Team-Micras/MicrasPCB/research/next-revision/calculations/power_tree/out/summary.txt

== A_none
  VDDA mean 3.2999 V; p-p    2063.0 uV (  40.97 LSB); rms     417.1 uV (   8.28 LSB)
  >200 kHz (switching) p-p    1407.9 uV (  27.96 LSB);  <200 kHz p-p     722.9 uV (  14.36 LSB)
  wall scan: window-mean spread      10.6 uV (   0.21 LSB); lit-dark     -10.3 uV (  -0.20 LSB); in-window rms     399.2 uV (   7.93 LSB)
  motor-current sample instants: p-p     794.5 uV (  15.78 LSB)
  lines (peak amplitude): a100k 7.00 uV, a300k 2.03 uV, a400k 0.53 uV, a1M1 536.63 uV
  v3d_pp 61.19 mV  vbat_pp 198.23 mV  va0_pp 2.23 mV  va0_mean 3.300 V
== A_bead
  VDDA mean 3.2991 V; p-p     943.7 uV (  18.74 LSB); rms     225.7 uV (   4.48 LSB)
  >200 kHz (switching) p-p     119.5 uV (   2.37 LSB);  <200 kHz p-p     938.1 uV (  18.63 LSB)
  wall scan: window-mean spread     200.1 uV (   3.97 LSB); lit-dark    -199.9 uV (  -3.97 LSB); in-window rms      40.1 uV (   0.80 LSB)
  motor-current sample instants: p-p     905.2 uV (  17.98 LSB)
  lines (peak amplitude): a100k 2.24 uV, a300k 0.79 uV, a400k 0.66 uV, a1M1 2.24 uV
  v3d_pp 61.19 mV  vbat_pp 198.23 mV  va0_pp 2.40 mV  va0_mean 3.300 V
== A_lc
  VDDA mean 3.2982 V; p-p    2452.6 uV (  48.71 LSB); rms     538.5 uV (  10.69 LSB)
  >200 kHz (switching) p-p      85.0 uV (   1.69 LSB);  <200 kHz p-p    2452.0 uV (  48.70 LSB)
  wall scan: window-mean spread     410.3 uV (   8.15 LSB); lit-dark    -409.9 uV (  -8.14 LSB); in-window rms     142.0 uV (   2.82 LSB)
  motor-current sample instants: p-p    2428.8 uV (  48.23 LSB)
  lines (peak amplitude): a100k 2.14 uV, a300k 0.53 uV, a400k 0.47 uV, a1M1 0.14 uV
  v3d_pp 61.19 mV  vbat_pp 198.24 mV  va0_pp 2.41 mV  va0_mean 3.300 V
== A_lcd
  VDDA mean 3.2865 V; p-p    4175.1 uV (  82.91 LSB); rms    1475.8 uV (  29.31 LSB)
  >200 kHz (switching) p-p      84.9 uV (   1.69 LSB);  <200 kHz p-p    4189.5 uV (  83.20 LSB)
  wall scan: window-mean spread    3026.3 uV (  60.10 LSB); lit-dark   -3024.9 uV ( -60.07 LSB); in-window rms     286.1 uV (   5.68 LSB)
  motor-current sample instants: p-p    4174.8 uV (  82.91 LSB)
  lines (peak amplitude): a100k 2.21 uV, a300k 0.53 uV, a400k 0.47 uV, a1M1 0.08 uV
  v3d_pp 61.19 mV  vbat_pp 198.23 mV  va0_pp 1.97 mV  va0_mean 3.300 V
== A_lcx
  VDDA mean 3.2995 V; p-p    1042.9 uV (  20.71 LSB); rms     248.7 uV (   4.94 LSB)
  >200 kHz (switching) p-p      83.1 uV (   1.65 LSB);  <200 kHz p-p    1042.1 uV (  20.70 LSB)
  wall scan: window-mean spread      89.4 uV (   1.78 LSB); lit-dark     -87.8 uV (  -1.74 LSB); in-window rms      40.5 uV (   0.80 LSB)
  motor-current sample instants: p-p    1039.2 uV (  20.64 LSB)
  lines (peak amplitude): a100k 1.92 uV, a300k 0.53 uV, a400k 0.47 uV, a1M1 0.34 uV
  v3d_pp 61.19 mV  vbat_pp 198.23 mV  va0_pp 2.25 mV  va0_mean 3.300 V
== A_lcx_hv
  VDDA mean 3.2995 V; p-p    1043.4 uV (  20.72 LSB); rms     248.7 uV (   4.94 LSB)
  >200 kHz (switching) p-p      83.5 uV (   1.66 LSB);  <200 kHz p-p    1042.4 uV (  20.70 LSB)
  wall scan: window-mean spread      89.4 uV (   1.78 LSB); lit-dark     -87.8 uV (  -1.74 LSB); in-window rms      40.5 uV (   0.80 LSB)
  motor-current sample instants: p-p    1039.2 uV (  20.64 LSB)
  lines (peak amplitude): a100k 1.52 uV, a300k 0.53 uV, a400k 0.47 uV, a1M1 0.34 uV
  v3d_pp 61.19 mV  vbat_pp 384.53 mV  va0_pp 2.26 mV  va0_mean 3.300 V
== A_pfm-lcx
  VDDA mean 3.3618 V; p-p    3474.8 uV (  69.01 LSB); rms     468.8 uV (   9.31 LSB)
  >200 kHz (switching) p-p     112.4 uV (   2.23 LSB);  <200 kHz p-p    3472.5 uV (  68.96 LSB)
  wall scan: window-mean spread     690.5 uV (  13.71 LSB); lit-dark    -125.3 uV (  -2.49 LSB); in-window rms     298.4 uV (   5.93 LSB)
  motor-current sample instants: p-p    3396.3 uV (  67.45 LSB)
  lines (peak amplitude): a100k 12.56 uV, a300k 0.47 uV, a400k 0.45 uV, a1M1 0.08 uV
  v3d_pp 61.19 mV  vbat_pp 198.20 mV  va0_pp 5.87 mV  va0_mean 3.362 V
== A6981_lc
  VDDA mean 3.2982 V; p-p    2245.5 uV (  44.59 LSB); rms     503.9 uV (  10.01 LSB)
  >200 kHz (switching) p-p      87.8 uV (   1.74 LSB);  <200 kHz p-p    2239.9 uV (  44.48 LSB)
  wall scan: window-mean spread     452.5 uV (   8.99 LSB); lit-dark    -442.7 uV (  -8.79 LSB); in-window rms     102.4 uV (   2.03 LSB)
  motor-current sample instants: p-p    2233.1 uV (  44.35 LSB)
  lines (peak amplitude): a100k 2.31 uV, a300k 0.53 uV, a400k 2.64 uV, a1M1 0.08 uV
  v3d_pp 61.19 mV  vbat_pp 197.20 mV  va0_pp 3.47 mV  va0_mean 3.300 V
== A6981_lcx
  VDDA mean 3.2995 V; p-p     918.7 uV (  18.24 LSB); rms     230.8 uV (   4.58 LSB)
  >200 kHz (switching) p-p      85.6 uV (   1.70 LSB);  <200 kHz p-p     907.2 uV (  18.02 LSB)
  wall scan: window-mean spread     147.5 uV (   2.93 LSB); lit-dark    -140.1 uV (  -2.78 LSB); in-window rms      40.5 uV (   0.80 LSB)
  motor-current sample instants: p-p     893.6 uV (  17.75 LSB)
  lines (peak amplitude): a100k 2.26 uV, a300k 0.53 uV, a400k 5.55 uV, a1M1 0.08 uV
  v3d_pp 61.19 mV  vbat_pp 197.20 mV  va0_pp 3.32 mV  va0_mean 3.300 V
== B
  VDDA mean 3.3000 V; p-p    1052.5 uV (  20.90 LSB); rms     118.6 uV (   2.35 LSB)
  >200 kHz (switching) p-p     323.2 uV (   6.42 LSB);  <200 kHz p-p    1082.8 uV (  21.50 LSB)
  wall scan: window-mean spread       0.1 uV (   0.00 LSB); lit-dark       0.0 uV (   0.00 LSB); in-window rms      38.9 uV (   0.77 LSB)
  motor-current sample instants: p-p    1041.3 uV (  20.68 LSB)
  lines (peak amplitude): a100k 6.16 uV, a300k 2.36 uV, a400k 2.07 uV, a1M1 0.30 uV
  v3d_pp 61.19 mV  vbat_pp 197.62 mV  v5_pp 5.92 mV  v5_mean 5.093 V
== B_hv
  VDDA mean 3.3000 V; p-p    1052.5 uV (  20.90 LSB); rms     118.6 uV (   2.35 LSB)
  >200 kHz (switching) p-p     320.9 uV (   6.37 LSB);  <200 kHz p-p    1082.1 uV (  21.49 LSB)
  wall scan: window-mean spread       0.1 uV (   0.00 LSB); lit-dark       0.0 uV (   0.00 LSB); in-window rms      38.9 uV (   0.77 LSB)
  motor-current sample instants: p-p    1043.2 uV (  20.72 LSB)
  lines (peak amplitude): a100k 6.17 uV, a300k 2.34 uV, a400k 2.07 uV, a1M1 0.30 uV
  v3d_pp 61.19 mV  vbat_pp 383.84 mV  v5_pp 5.92 mV  v5_mean 5.093 V
== C
  VDDA mean 3.3000 V; p-p     242.2 uV (   4.81 LSB); rms      32.9 uV (   0.65 LSB)
  >200 kHz (switching) p-p      85.4 uV (   1.70 LSB);  <200 kHz p-p     243.5 uV (   4.84 LSB)
  wall scan: window-mean spread      68.1 uV (   1.35 LSB); lit-dark     -31.7 uV (  -0.63 LSB); in-window rms      16.8 uV (   0.33 LSB)
  motor-current sample instants: p-p     228.9 uV (   4.55 LSB)
  lines (peak amplitude): a100k 1.31 uV, a300k 0.64 uV, a400k 0.61 uV, a1M1 0.11 uV
  v3d_pp 61.19 mV  vbat_pp 196.87 mV  vpre_pp 105.94 mV  vpre_mean 14.350 V
== C_hv
  VDDA mean 3.3000 V; p-p     242.1 uV (   4.81 LSB); rms      32.9 uV (   0.65 LSB)
  >200 kHz (switching) p-p      85.4 uV (   1.70 LSB);  <200 kHz p-p     243.5 uV (   4.84 LSB)
  wall scan: window-mean spread      68.1 uV (   1.35 LSB); lit-dark     -31.7 uV (  -0.63 LSB); in-window rms      16.8 uV (   0.33 LSB)
  motor-current sample instants: p-p     228.9 uV (   4.55 LSB)
  lines (peak amplitude): a100k 1.09 uV, a300k 0.64 uV, a400k 0.61 uV, a1M1 0.11 uV
  v3d_pp 61.19 mV  vbat_pp 382.78 mV  vpre_pp 106.21 mV  vpre_mean 14.344 V
== F
  VDDA mean 3.2987 V; p-p   61949.7 uV (1230.28 LSB); rms   10451.2 uV ( 207.55 LSB)
  >200 kHz (switching) p-p     113.5 uV (   2.25 LSB);  <200 kHz p-p   61956.6 uV (1230.42 LSB)
  wall scan: window-mean spread   29060.8 uV ( 577.13 LSB); lit-dark   -2948.1 uV ( -58.55 LSB); in-window rms    4552.4 uV (  90.41 LSB)
  motor-current sample instants: p-p   61678.0 uV (1224.89 LSB)
  lines (peak amplitude): a100k 26.52 uV, a300k 0.41 uV, a400k 0.47 uV, a1M1 0.10 uV
  v3d_pp 59.90 mV  vbat_pp 197.20 mV
== Frc
  VDDA mean 3.2577 V; p-p   15507.2 uV ( 307.96 LSB); rms    3464.5 uV (  68.80 LSB)
  >200 kHz (switching) p-p      50.2 uV (   1.00 LSB);  <200 kHz p-p   15479.9 uV ( 307.42 LSB)
  wall scan: window-mean spread   14124.1 uV ( 280.50 LSB); lit-dark   -6522.6 uV (-129.53 LSB); in-window rms     830.6 uV (  16.49 LSB)
  motor-current sample instants: p-p   15424.6 uV ( 306.32 LSB)
  lines (peak amplitude): a100k 0.92 uV, a300k 0.23 uV, a400k 0.24 uV, a1M1 0.06 uV
  v3d_pp 60.37 mV  vbat_pp 197.20 mV
== A_none_line
  VDDA mean 3.2999 V; p-p    1361.3 uV (  27.03 LSB); rms     397.6 uV (   7.90 LSB)
  >200 kHz (switching) p-p    1353.2 uV (  26.87 LSB);  <200 kHz p-p      10.5 uV (   0.21 LSB)
  wall scan: window-mean spread       0.4 uV (   0.01 LSB); lit-dark      -0.0 uV (  -0.00 LSB); in-window rms     397.7 uV (   7.90 LSB)
  motor-current sample instants: p-p     161.8 uV (   3.21 LSB)
  LINE REJECTION battery->VDDA: 100 kHz -79.8 dB (VBAT line 51.2 mV), 300 kHz -86.7 dB (VBAT line 36.4 mV)
  lines (peak amplitude): a100k 5.23 uV, a300k 1.68 uV, a400k 0.18 uV, a1M1 536.69 uV
  v3d_pp 0.00 mV  vbat_pp 187.15 mV  va0_pp 1.55 mV  va0_mean 3.300 V
== A_lcx_line
  VDDA mean 3.2995 V; p-p       1.6 uV (   0.03 LSB); rms       0.4 uV (   0.01 LSB)
  >200 kHz (switching) p-p       0.8 uV (   0.02 LSB);  <200 kHz p-p       0.9 uV (   0.02 LSB)
  wall scan: window-mean spread       0.0 uV (   0.00 LSB); lit-dark       0.0 uV (   0.00 LSB); in-window rms       0.4 uV (   0.01 LSB)
  motor-current sample instants: p-p       0.2 uV (   0.00 LSB)
  LINE REJECTION battery->VDDA: 100 kHz -101.6 dB (VBAT line 51.2 mV), 300 kHz -127.7 dB (VBAT line 36.3 mV)
  lines (peak amplitude): a100k 0.42 uV, a300k 0.02 uV, a400k 0.00 uV, a1M1 0.37 uV
  v3d_pp 0.00 mV  vbat_pp 187.57 mV  va0_pp 1.68 mV  va0_mean 3.300 V
== A6981_lcx_line
  VDDA mean 3.2995 V; p-p      11.5 uV (   0.23 LSB); rms       3.9 uV (   0.08 LSB)
  >200 kHz (switching) p-p      11.2 uV (   0.22 LSB);  <200 kHz p-p       0.4 uV (   0.01 LSB)
  wall scan: window-mean spread       0.0 uV (   0.00 LSB); lit-dark       0.0 uV (   0.00 LSB); in-window rms       3.9 uV (   0.08 LSB)
  motor-current sample instants: p-p       0.2 uV (   0.00 LSB)
  LINE REJECTION battery->VDDA: 100 kHz -109.1 dB (VBAT line 51.2 mV), 300 kHz -132.8 dB (VBAT line 36.4 mV)
  lines (peak amplitude): a100k 0.18 uV, a300k 0.01 uV, a400k 5.55 uV, a1M1 0.00 uV
  v3d_pp 0.00 mV  vbat_pp 186.56 mV  va0_pp 2.82 mV  va0_mean 3.300 V
== C_line
  VDDA mean 3.3000 V; p-p      33.2 uV (   0.66 LSB); rms      17.5 uV (   0.35 LSB)
  >200 kHz (switching) p-p       0.7 uV (   0.01 LSB);  <200 kHz p-p      32.9 uV (   0.65 LSB)
  wall scan: window-mean spread      31.0 uV (   0.62 LSB); lit-dark      -0.8 uV (  -0.02 LSB); in-window rms      15.4 uV (   0.31 LSB)
  motor-current sample instants: p-p      32.4 uV (   0.64 LSB)
  LINE REJECTION battery->VDDA: 100 kHz -101.4 dB (VBAT line 51.1 mV), 300 kHz -110.9 dB (VBAT line 36.3 mV)
  lines (peak amplitude): a100k 0.43 uV, a300k 0.10 uV, a400k 0.00 uV, a1M1 0.01 uV
  v3d_pp 0.00 mV  vbat_pp 185.94 mV  vpre_pp 91.15 mV  vpre_mean 14.359 V

| case | VDDA p-p | rms | 100 kHz line | fSW line | scan-mean spread | lit-dark | in-window rms | I-sample p-p |
|---|---|---|---|---|---|---|---|---|
| A_none | 2063.0 µV / 40.97 | 417.1 µV / 8.28 | 7.0 µV / 0.14 | 536.6 µV / 10.66 | 10.6 µV / 0.21 | 10.3 µV / 0.20 | 399.2 µV / 7.93 | 794.5 µV / 15.78 |
| A_bead | 943.7 µV / 18.74 | 225.7 µV / 4.48 | 2.2 µV / 0.04 | 2.2 µV / 0.04 | 200.1 µV / 3.97 | 199.9 µV / 3.97 | 40.1 µV / 0.80 | 905.2 µV / 17.98 |
| A_lc | 2452.6 µV / 48.71 | 538.5 µV / 10.69 | 2.1 µV / 0.04 | 0.5 µV / 0.01 | 410.3 µV / 8.15 | 409.9 µV / 8.14 | 142.0 µV / 2.82 | 2428.8 µV / 48.23 |
| A_lcd | 4175.1 µV / 82.91 | 1475.8 µV / 29.31 | 2.2 µV / 0.04 | 0.5 µV / 0.01 | 3026.3 µV / 60.10 | 3024.9 µV / 60.07 | 286.1 µV / 5.68 | 4174.8 µV / 82.91 |
| A_lcx | 1042.9 µV / 20.71 | 248.7 µV / 4.94 | 1.9 µV / 0.04 | 0.5 µV / 0.01 | 89.4 µV / 1.78 | 87.8 µV / 1.74 | 40.5 µV / 0.80 | 1039.2 µV / 20.64 |
| A_lcx_hv | 1043.4 µV / 20.72 | 248.7 µV / 4.94 | 1.5 µV / 0.03 | 0.5 µV / 0.01 | 89.4 µV / 1.78 | 87.8 µV / 1.74 | 40.5 µV / 0.80 | 1039.2 µV / 20.64 |
| A_pfm-lcx | 3474.8 µV / 69.01 | 468.8 µV / 9.31 | 12.6 µV / 0.25 | 0.4 µV / 0.01 | 690.5 µV / 13.71 | 125.3 µV / 2.49 | 298.4 µV / 5.93 | 3396.3 µV / 67.45 |
| A6981_lc | 2245.5 µV / 44.59 | 503.9 µV / 10.01 | 2.3 µV / 0.05 | 2.6 µV / 0.05 | 452.5 µV / 8.99 | 442.7 µV / 8.79 | 102.4 µV / 2.03 | 2233.1 µV / 44.35 |
| A6981_lcx | 918.7 µV / 18.24 | 230.8 µV / 4.58 | 2.3 µV / 0.04 | 5.5 µV / 0.11 | 147.5 µV / 2.93 | 140.1 µV / 2.78 | 40.5 µV / 0.80 | 893.6 µV / 17.75 |
| B | 1052.5 µV / 20.90 | 118.6 µV / 2.35 | 6.2 µV / 0.12 | 2.1 µV / 0.04 | 0.1 µV / 0.00 | 0.0 µV / 0.00 | 38.9 µV / 0.77 | 1041.3 µV / 20.68 |
| B_hv | 1052.5 µV / 20.90 | 118.6 µV / 2.35 | 6.2 µV / 0.12 | 2.1 µV / 0.04 | 0.1 µV / 0.00 | 0.0 µV / 0.00 | 38.9 µV / 0.77 | 1043.2 µV / 20.72 |
| C | 242.2 µV / 4.81 | 32.9 µV / 0.65 | 1.3 µV / 0.03 | 0.6 µV / 0.01 | 68.1 µV / 1.35 | 31.7 µV / 0.63 | 16.8 µV / 0.33 | 228.9 µV / 4.55 |
| C_hv | 242.1 µV / 4.81 | 32.9 µV / 0.65 | 1.1 µV / 0.02 | 0.6 µV / 0.01 | 68.1 µV / 1.35 | 31.7 µV / 0.63 | 16.8 µV / 0.33 | 228.9 µV / 4.55 |
| F | 61949.7 µV / 1230.28 | 10451.2 µV / 207.55 | 26.5 µV / 0.53 | 0.5 µV / 0.01 | 29060.8 µV / 577.13 | 2948.1 µV / 58.55 | 4552.4 µV / 90.41 | 61678.0 µV / 1224.89 |
| Frc | 15507.2 µV / 307.96 | 3464.5 µV / 68.80 | 0.9 µV / 0.02 | 0.2 µV / 0.00 | 14124.1 µV / 280.50 | 6522.6 µV / 129.53 | 830.6 µV / 16.49 | 15424.6 µV / 306.32 |
| A_none_line | 1361.3 µV / 27.03 | 397.6 µV / 7.90 | 5.2 µV / 0.10 | 536.7 µV / 10.66 | 0.4 µV / 0.01 | 0.0 µV / 0.00 | 397.7 µV / 7.90 | 161.8 µV / 3.21 |
| A_lcx_line | 1.6 µV / 0.03 | 0.4 µV / 0.01 | 0.4 µV / 0.01 | 0.4 µV / 0.01 | 0.0 µV / 0.00 | 0.0 µV / 0.00 | 0.4 µV / 0.01 | 0.2 µV / 0.00 |
| A6981_lcx_line | 11.5 µV / 0.23 | 3.9 µV / 0.08 | 0.2 µV / 0.00 | 5.5 µV / 0.11 | 0.0 µV / 0.00 | 0.0 µV / 0.00 | 3.9 µV / 0.08 | 0.2 µV / 0.00 |
| C_line | 33.2 µV / 0.66 | 17.5 µV / 0.35 | 0.4 µV / 0.01 | 0.0 µV / 0.00 | 31.0 µV / 0.62 | 0.8 µV / 0.02 | 15.4 µV / 0.31 | 32.4 µV / 0.64 |
