Team-Micras/MicrasPCB/research/next-revision/calculations/supply3v3/out/summary_slots.txt

== a
  frame 0 slot    0: 3V3 3.2972  VDDA 3.2966  I_LED  168.61 mA  I/VDDA 51.1448 mA/V
  frame 0 slot    1: 3V3 3.2980  VDDA 3.2975  I_LED  168.68 mA  I/VDDA 51.1544 mA/V
  frame 0 slot    2: 3V3 3.2981  VDDA 3.2975  I_LED  168.68 mA  I/VDDA 51.1545 mA/V
  frame 0 slot    3: 3V3 3.2981  VDDA 3.2975  I_LED  168.68 mA  I/VDDA 51.1545 mA/V
  frame 0 slot dark: 3V3 3.3009  VDDA 3.3004  I_LED    0.00 mA  I/VDDA nan mA/V
  frame 1 slot    0: 3V3 3.2972  VDDA 3.2967  I_LED  168.61 mA  I/VDDA 51.1449 mA/V
  frame 1 slot    1: 3V3 3.2980  VDDA 3.2975  I_LED  168.68 mA  I/VDDA 51.1544 mA/V
  frame 1 slot    2: 3V3 3.2981  VDDA 3.2975  I_LED  168.68 mA  I/VDDA 51.1545 mA/V
  frame 1 slot    3: 3V3 3.2981  VDDA 3.2975  I_LED  168.68 mA  I/VDDA 51.1545 mA/V
  frame 1 slot dark: 3V3 3.3009  VDDA 3.3004  I_LED    0.00 mA  I/VDDA nan mA/V
  frame 2 slot    0: 3V3 3.2972  VDDA 3.2967  I_LED  168.61 mA  I/VDDA 51.1449 mA/V
  frame 2 slot    1: 3V3 3.2980  VDDA 3.2975  I_LED  168.68 mA  I/VDDA 51.1544 mA/V
  frame 2 slot    2: 3V3 3.2981  VDDA 3.2975  I_LED  168.68 mA  I/VDDA 51.1545 mA/V
  frame 2 slot    3: 3V3 3.2981  VDDA 3.2975  I_LED  168.68 mA  I/VDDA 51.1545 mA/V
  frame 2 slot dark: 3V3 3.3009  VDDA 3.3004  I_LED    0.00 mA  I/VDDA nan mA/V
  VDDA in scan windows: 3.2966..3.2975 V (spread 0.9 mV)
  VDDA dark-slot minus lit-slot (mean): 3.0 mV
  I_LED spread 0.08 mA = 0.05 %; I/VDDA spread 0.02 %
== a_esp
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
  frame 0 slot    3: 3V3 3.3000  VDDA 3.2999  I_LED  170.00 mA  I/VDDA 51.5163 mA/V
  frame 0 slot dark: 3V3 3.3000  VDDA 3.2999  I_LED    0.00 mA  I/VDDA nan mA/V
  frame 1 slot    0: 3V3 3.3000  VDDA 3.2999  I_LED  170.00 mA  I/VDDA 51.5163 mA/V
  frame 1 slot    1: 3V3 3.3000  VDDA 3.2999  I_LED  169.98 mA  I/VDDA 51.5114 mA/V
  frame 1 slot    2: 3V3 3.3013  VDDA 3.2999  I_LED  170.00 mA  I/VDDA 51.5163 mA/V
  frame 1 slot    3: 3V3 3.3000  VDDA 3.2999  I_LED  170.00 mA  I/VDDA 51.5163 mA/V
  frame 1 slot dark: 3V3 3.3000  VDDA 3.2999  I_LED    0.00 mA  I/VDDA nan mA/V
  frame 2 slot    0: 3V3 3.3000  VDDA 3.2999  I_LED  170.00 mA  I/VDDA 51.5163 mA/V
  frame 2 slot    1: 3V3 3.3000  VDDA 3.2999  I_LED  170.00 mA  I/VDDA 51.5163 mA/V
  frame 2 slot    2: 3V3 3.3000  VDDA 3.2999  I_LED  170.00 mA  I/VDDA 51.5163 mA/V
  frame 2 slot    3: 3V3 3.3000  VDDA 3.2999  I_LED  170.00 mA  I/VDDA 51.5163 mA/V
  frame 2 slot dark: 3V3 3.3000  VDDA 3.2999  I_LED    0.00 mA  I/VDDA nan mA/V
  VDDA in scan windows: 3.2999..3.2999 V (spread 0.0 mV)
  VDDA dark-slot minus lit-slot (mean): -0.0 mV
  I_LED spread 0.06 mA = 0.03 %; I/VDDA spread 0.03 %
