Team-Micras/MicrasPCB/research/next-revision/calculations/esp/placement.png

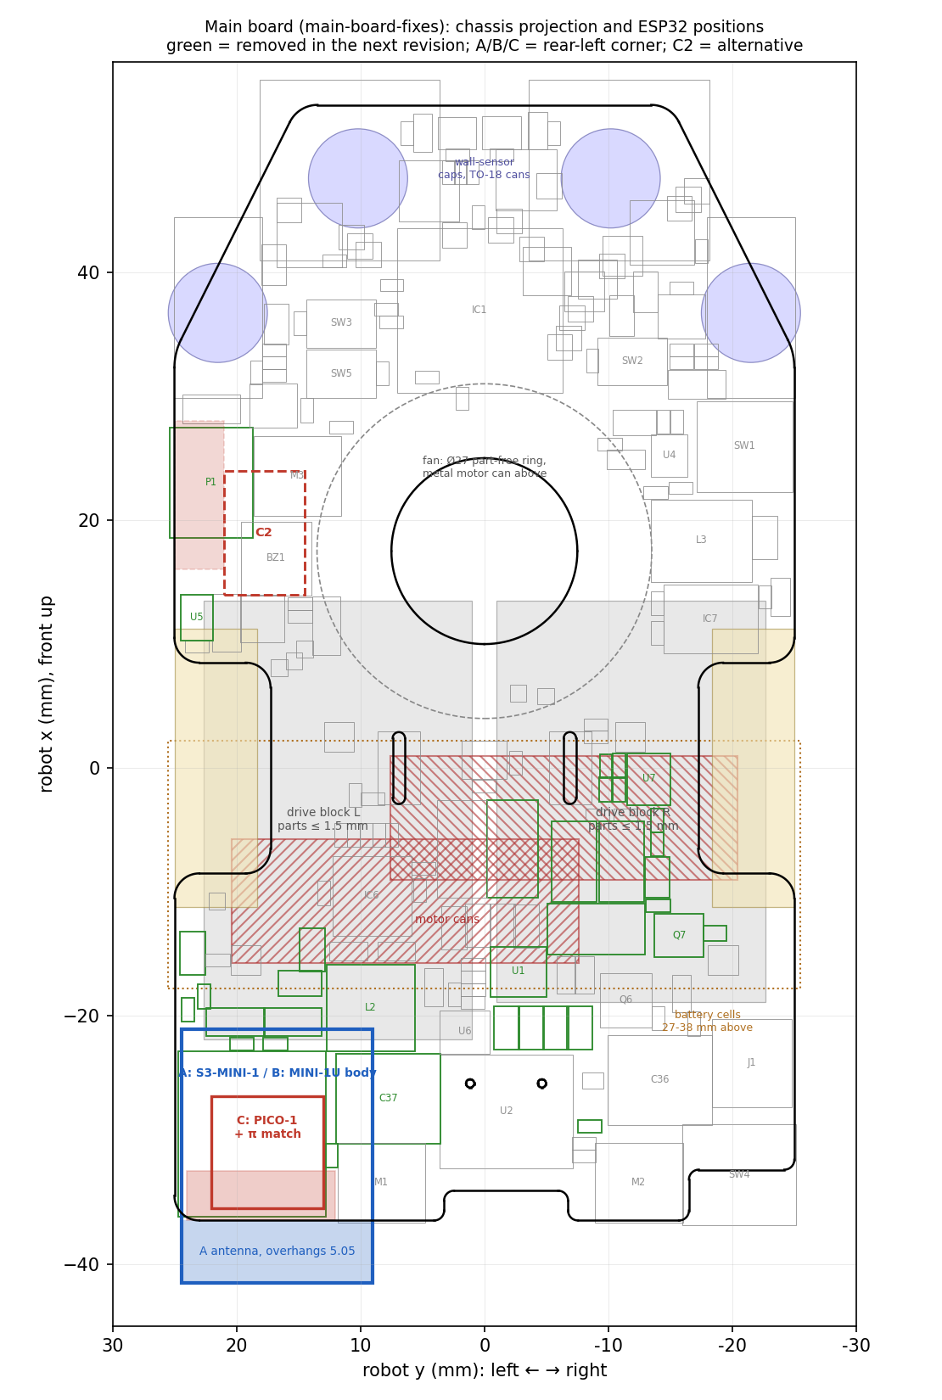
research/next-revision/calculations/esp/placement.png
