Team-Micras/MicrasPCB/boards/main/layout/main.kicad_pcb

## KiCad design boards/main/layout/main.kicad_pcb (2026-11-10)

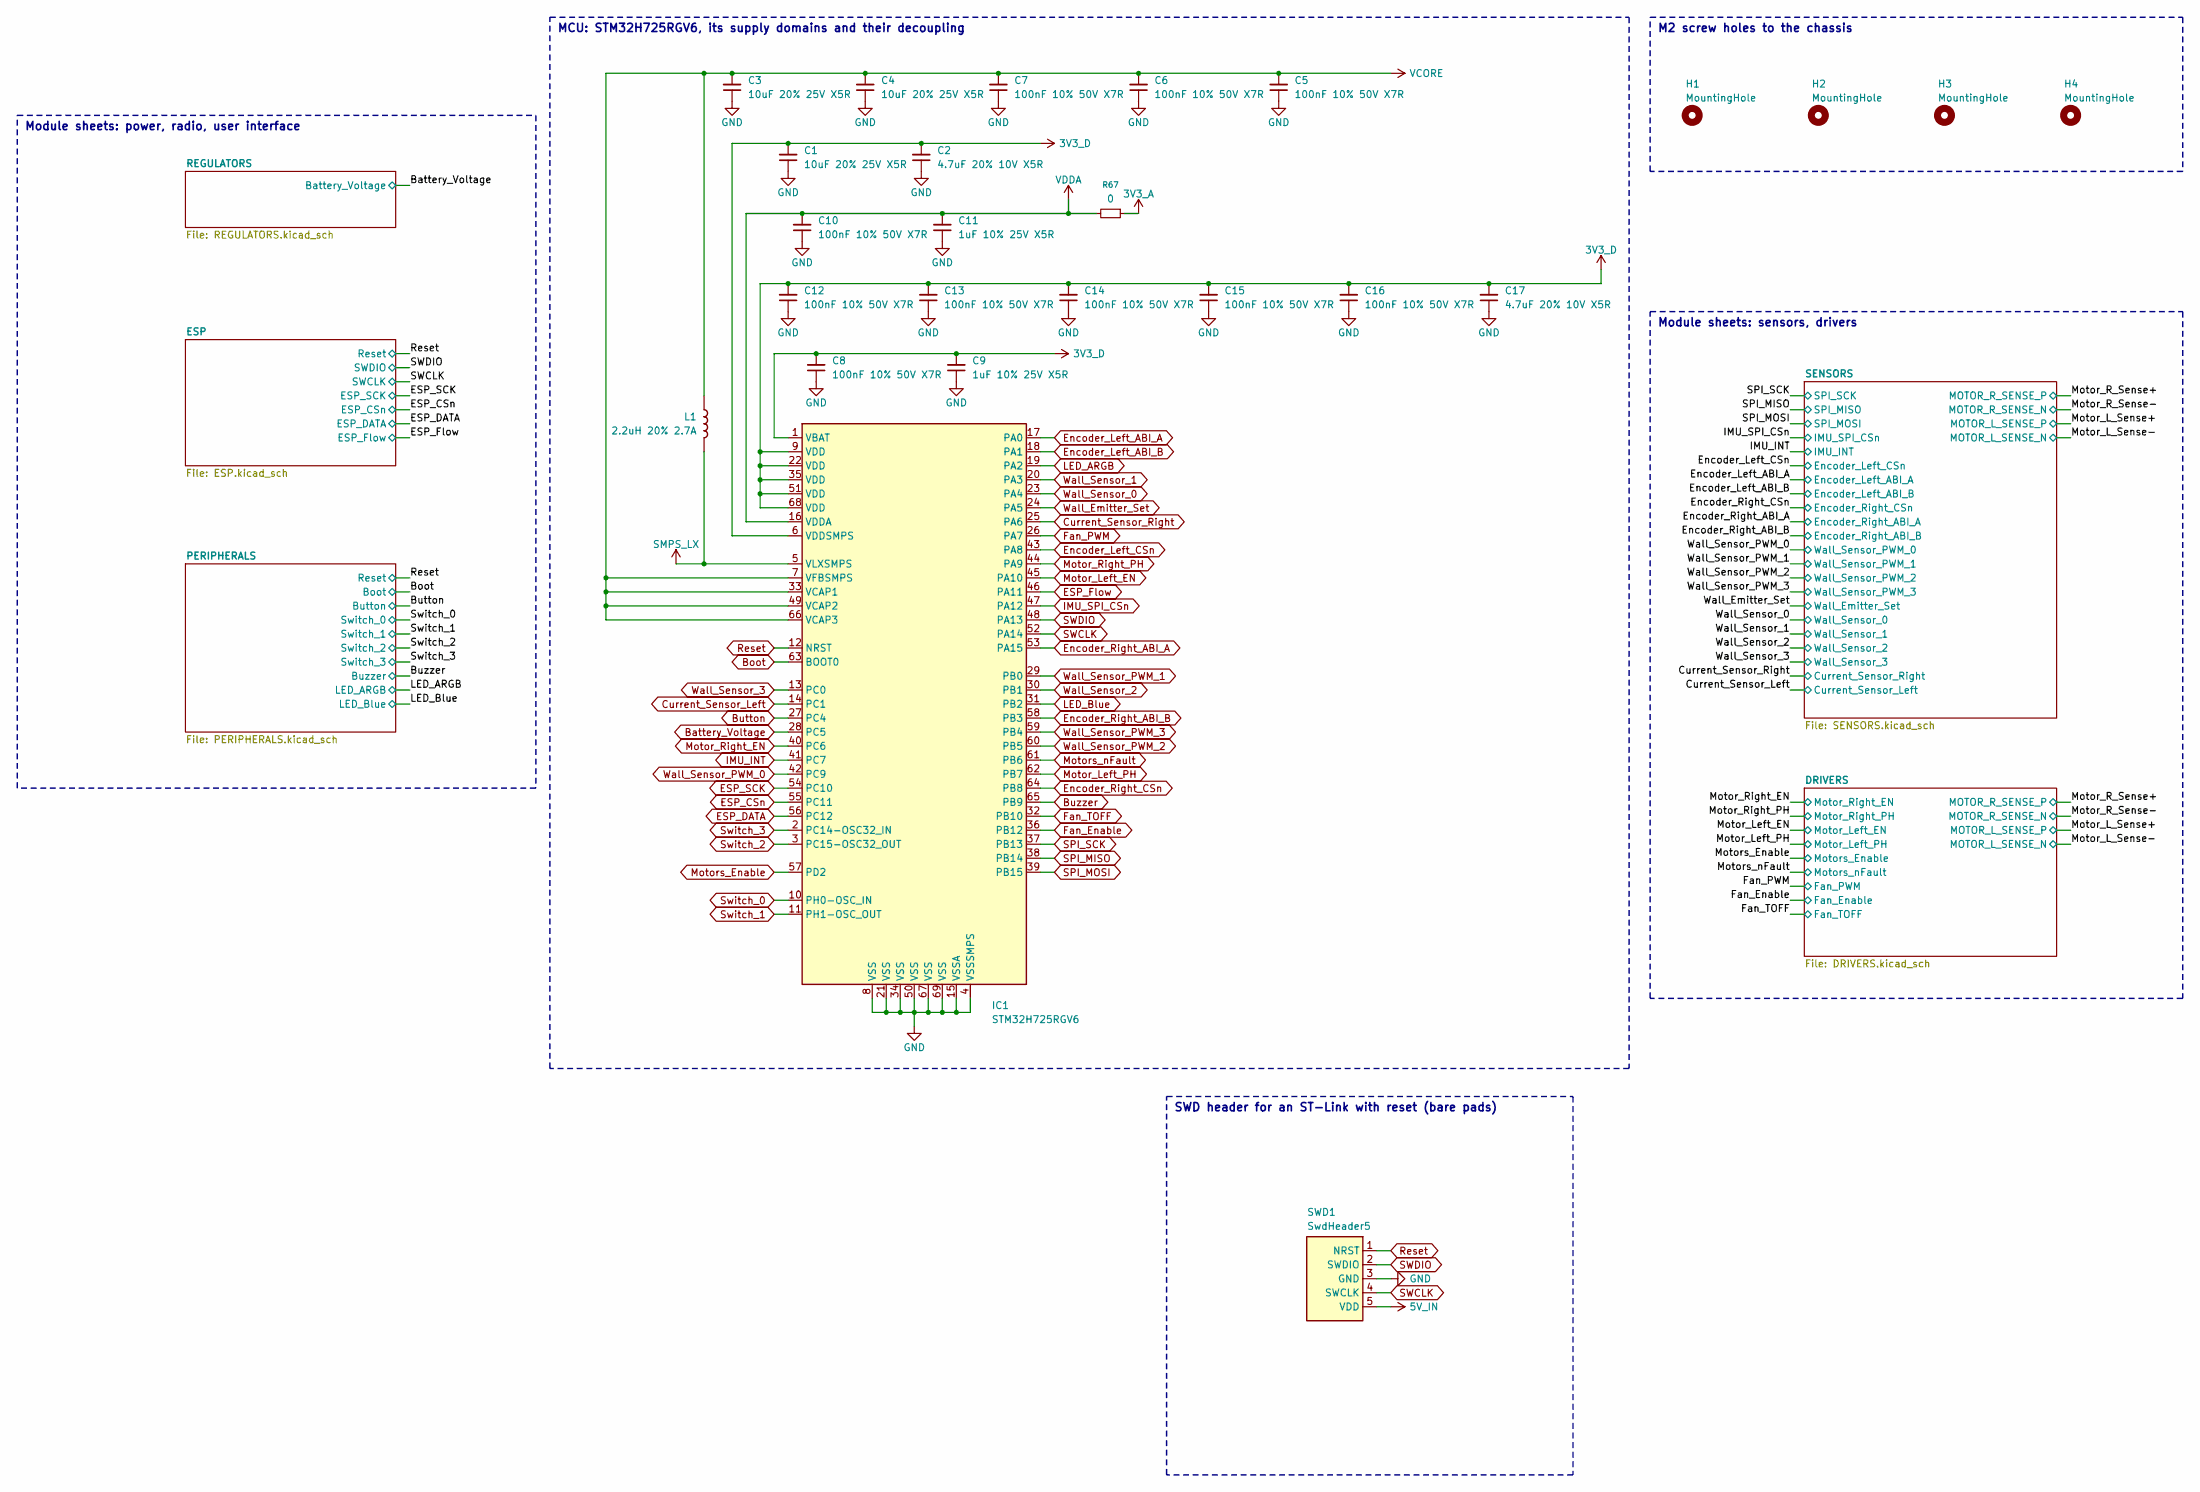
[picture p2: schematic main.kicad_sch, MCU and module sheets]

Parts:
C1, C3, C4: 10uF 20% 25V X5R; C_0603_1608Metric
C2, C17: 4.7uF 20% 10V X5R; C_0402_1005Metric
C5, C6, C7, C8, C10, C12, C13, C14, C15, C16: 100nF 10% 50V X7R; C_0402_1005Metric
C9, C11: 1uF 10% 25V X5R; C_0402_1005Metric
H1, H2, H3, H4: MountingHole; MountingHole_2.4mm_NPTH
IC1: STM32H725RGV6; QFN-68-1EP_8x8mm_P0.4mm_EP6.5x6.5mm_SplitPaste
L1: 2.2uH 20% 2.7A; IND-SMD_L2.0-W1.6-B
R67: 0; R_0402_1005Metric
SWD1: SwdHeader5; PinHeader_1x05_P1.27mm_Vertical

Connections:
3V3_A: R67.1; also elsewhere on the board
3V3_D: C1.2, C2.2, C8.2, C9.2, C12.2, C13.2, C14.2, C15.2, C16.2, C17.2, IC1.1 (VBAT), IC1.6 (VDDSMPS), IC1.9 (VDD), IC1.22 (VDD), IC1.35 (VDD), IC1.51 (VDD), IC1.68 (VDD); also elsewhere on the board
5V_IN: SWD1.5 (VDD); also elsewhere on the board
Battery_Voltage: IC1.28 (PC5); also elsewhere on the board
Boot: IC1.63 (BOOT0); also elsewhere on the board
Button: IC1.27 (PC4); also elsewhere on the board
Buzzer: IC1.65 (PB9); also elsewhere on the board
Current_Sensor_Left: IC1.14 (PC1); also elsewhere on the board
Current_Sensor_Right: IC1.25 (PA6); also elsewhere on the board
ESP_CSn: IC1.55 (PC11); also elsewhere on the board
ESP_DATA: IC1.56 (PC12); also elsewhere on the board
ESP_Flow: IC1.46 (PA11); also elsewhere on the board
ESP_SCK: IC1.54 (PC10); also elsewhere on the board
Encoder_Left_ABI_A: IC1.17 (PA0); also elsewhere on the board
Encoder_Left_ABI_B: IC1.18 (PA1); also elsewhere on the board
Encoder_Left_CSn: IC1.43 (PA8); also elsewhere on the board
Encoder_Right_ABI_A: IC1.53 (PA15); also elsewhere on the board
Encoder_Right_ABI_B: IC1.58 (PB3); also elsewhere on the board
Encoder_Right_CSn: IC1.64 (PB8); also elsewhere on the board
Fan_Enable: IC1.36 (PB12); also elsewhere on the board
Fan_PWM: IC1.26 (PA7); also elsewhere on the board
Fan_TOFF: IC1.32 (PB10); also elsewhere on the board
GND: C1.1, C2.1, C3.1, C4.1, C5.1, C6.1, C7.1, C8.1, C9.1, C10.1, C11.1, C12.1, C13.1, C14.1, C15.1, C16.1, C17.1, IC1.4 (VSSSMPS), IC1.8 (VSS), IC1.15 (VSSA), IC1.21 (VSS), IC1.34 (VSS), IC1.50 (VSS), IC1.67 (VSS), IC1.69 (VSS), SWD1.3 (GND); also elsewhere on the board
IMU_INT: IC1.41 (PC7); also elsewhere on the board
IMU_SPI_CSn: IC1.47 (PA12); also elsewhere on the board
LED_ARGB: IC1.19 (PA2); also elsewhere on the board
LED_Blue: IC1.31 (PB2); also elsewhere on the board
Motor_Left_EN: IC1.45 (PA10); also elsewhere on the board
Motor_Left_PH: IC1.62 (PB7); also elsewhere on the board
Motor_Right_EN: IC1.40 (PC6); also elsewhere on the board
Motor_Right_PH: IC1.44 (PA9); also elsewhere on the board
Motors_Enable: IC1.57 (PD2); also elsewhere on the board
Motors_nFault: IC1.61 (PB6); also elsewhere on the board
Reset: IC1.12 (NRST), SWD1.1 (NRST); also elsewhere on the board
SMPS_LX: IC1.5 (VLXSMPS), L1.2
SPI_MISO: IC1.38 (PB14); also elsewhere on the board
SPI_MOSI: IC1.39 (PB15); also elsewhere on the board
SPI_SCK: IC1.37 (PB13); also elsewhere on the board
SWCLK: IC1.52 (PA14), SWD1.4 (SWCLK); also elsewhere on the board
SWDIO: IC1.48 (PA13), SWD1.2 (SWDIO); also elsewhere on the board
Switch_0: IC1.10 (PH0-OSC_IN); also elsewhere on the board
Switch_1: IC1.11 (PH1-OSC_OUT); also elsewhere on the board
Switch_2: IC1.3 (PC15-OSC32_OUT); also elsewhere on the board
Switch_3: IC1.2 (PC14-OSC32_IN); also elsewhere on the board
VCORE: C3.2, C4.2, C5.2, C6.2, C7.2, IC1.7 (VFBSMPS), IC1.33 (VCAP1), IC1.49 (VCAP2), IC1.66 (VCAP3), L1.1
VDDA: C10.2, C11.2, IC1.16 (VDDA), R67.2
Wall_Emitter_Set: IC1.24 (PA5); also elsewhere on the board
Wall_Sensor_0: IC1.23 (PA4); also elsewhere on the board
Wall_Sensor_1: IC1.20 (PA3); also elsewhere on the board
Wall_Sensor_2: IC1.30 (PB1); also elsewhere on the board
Wall_Sensor_3: IC1.13 (PC0); also elsewhere on the board
Wall_Sensor_PWM_0: IC1.42 (PC9); also elsewhere on the board
Wall_Sensor_PWM_1: IC1.29 (PB0); also elsewhere on the board
Wall_Sensor_PWM_2: IC1.60 (PB5); also elsewhere on the board
Wall_Sensor_PWM_3: IC1.59 (PB4); also elsewhere on the board

Notes on the sheet:
MCU: STM32H725RGV6, its supply domains and their decoupling
SWD header for an ST-Link with reset (bare pads)
M2 screw holes to the chassis
Module sheets: power, radio, user interface
Module sheets: sensors, drivers

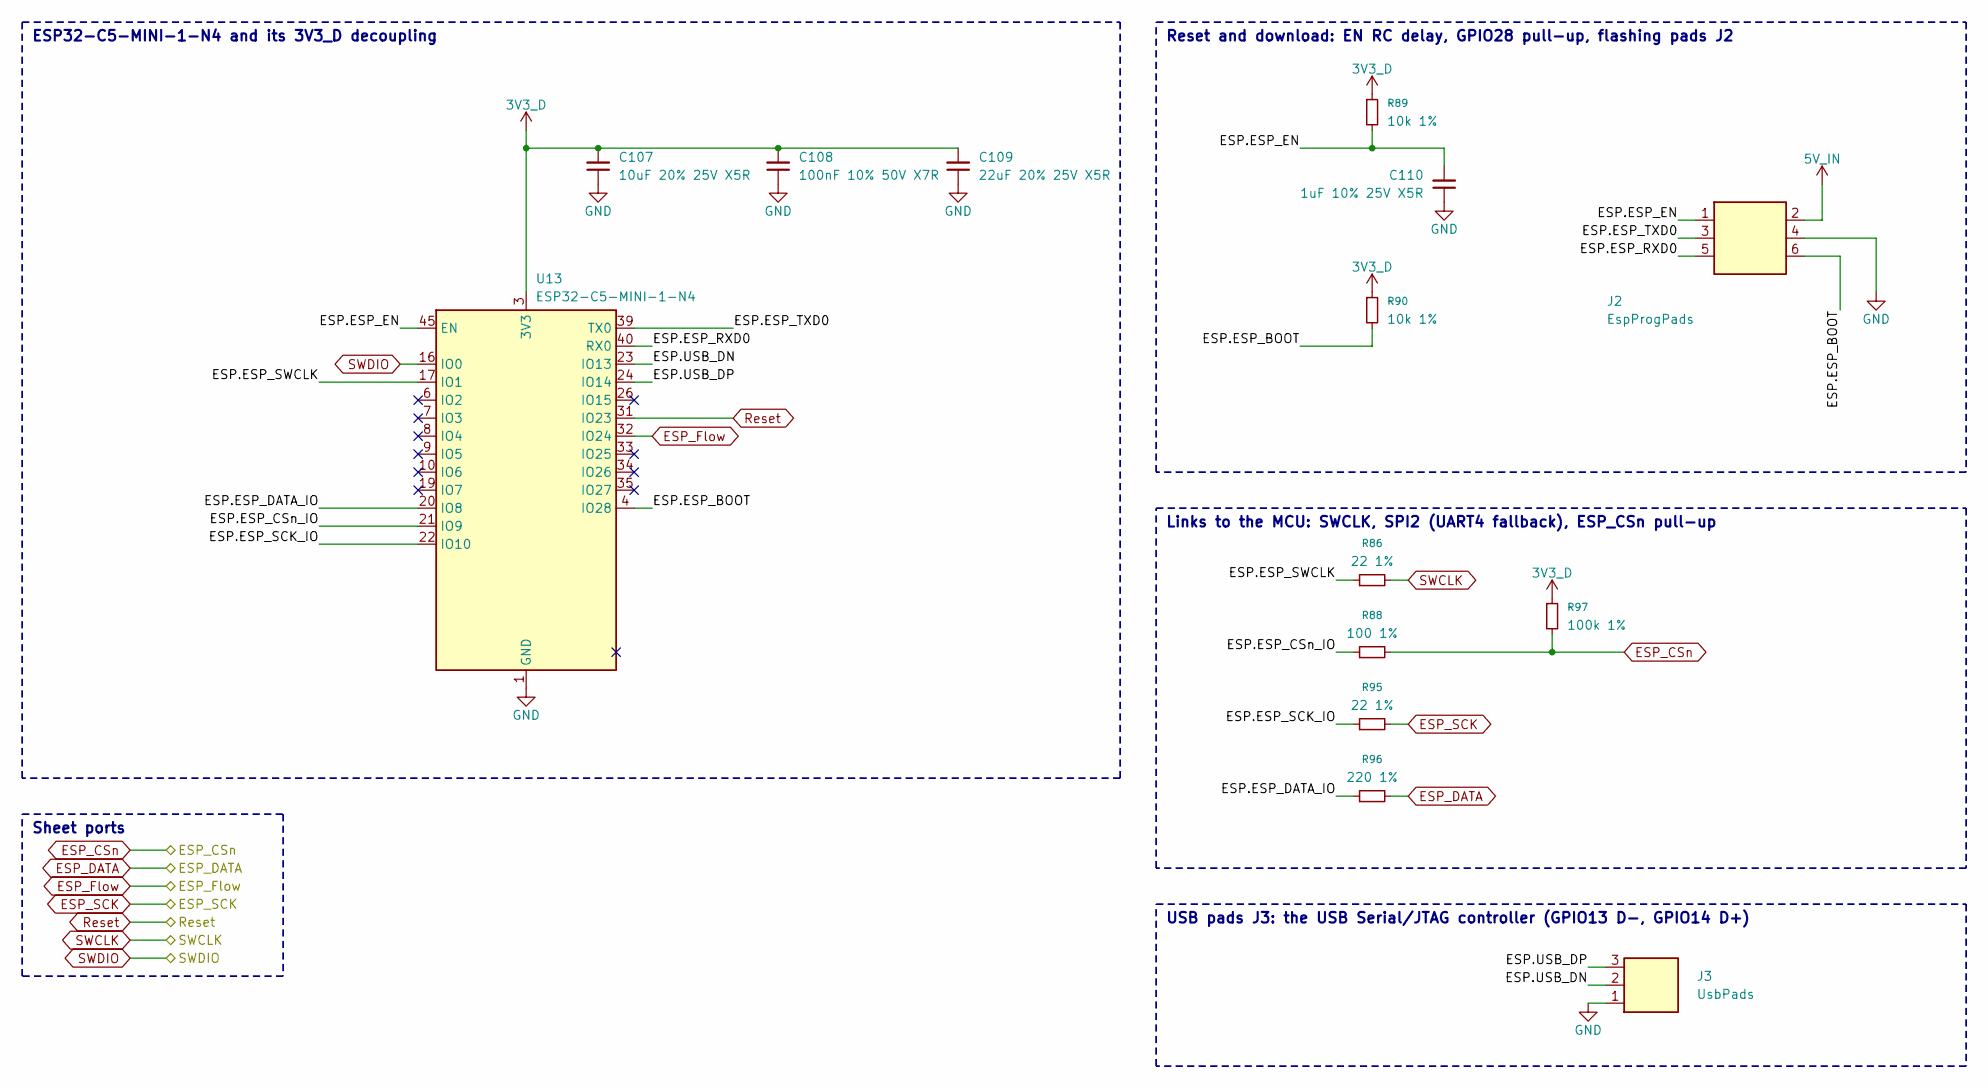
[picture p3: schematic ESP.kicad_sch, ESP32-C5 radio and debug probe]

Parts:
C107: 10uF 20% 25V X5R; C_0603_1608Metric
C108: 100nF 10% 50V X7R; C_0402_1005Metric
C109: 22uF 20% 25V X5R; C_0805_2012Metric
C110: 1uF 10% 25V X5R; C_0402_1005Metric
J2: EspProgPads; EspProgPads_2x03_P1.27mm
J3: UsbPads; UsbPads_1x03_P1.27mm
R86, R95: 22 1%; R_0402_1005Metric
R88: 100 1%; R_0402_1005Metric
R89, R90: 10k 1%; R_0402_1005Metric
R96: 220 1%; R_0402_1005Metric
R97: 100k 1%; R_0402_1005Metric
U13: ESP32-C5-MINI-1-N4; ESP32-C5-MINI-1

Connections:
3V3_D: C107.2, C108.2, C109.2, R89.1, R90.1, R97.1, U13.3 (3V3); also elsewhere on the board
5V_IN: J2.2; also elsewhere on the board
ESP.ESP_BOOT: J2.6, R90.2, U13.4 (IO28)
ESP.ESP_CSn_IO: R88.1, U13.21 (IO9)
ESP.ESP_DATA_IO: R96.1, U13.20 (IO8)
ESP.ESP_EN: C110.2, J2.1, R89.2, U13.45 (EN)
ESP.ESP_RXD0: J2.5, U13.40 (RX0)
ESP.ESP_SCK_IO: R95.1, U13.22 (IO10)
ESP.ESP_SWCLK: R86.1, U13.17 (IO1)
ESP.ESP_TXD0: J2.3, U13.39 (TX0)
ESP.U13.NC_ESP32-C5-MINI-1_IO2: U13.6 (IO2)
ESP.U13.NC_ESP32-C5-MINI-1_IO3: U13.7 (IO3)
ESP.U13.NC_ESP32-C5-MINI-1_IO4: U13.8 (IO4)
ESP.U13.NC_ESP32-C5-MINI-1_IO5: U13.9 (IO5)
ESP.U13.NC_ESP32-C5-MINI-1_IO6: U13.10 (IO6)
ESP.U13.NC_ESP32-C5-MINI-1_IO7: U13.19 (IO7)
ESP.U13.NC_ESP32-C5-MINI-1_IO15: U13.26 (IO15)
ESP.U13.NC_ESP32-C5-MINI-1_IO25: U13.33 (IO25)
ESP.U13.NC_ESP32-C5-MINI-1_IO26: U13.34 (IO26)
ESP.U13.NC_ESP32-C5-MINI-1_IO27: U13.35 (IO27)
ESP.USB_DN: J3.2, U13.23 (IO13)
ESP.USB_DP: J3.3, U13.24 (IO14)
ESP_CSn: R88.2, R97.2; also elsewhere on the board
ESP_DATA: R96.2; also elsewhere on the board
ESP_Flow: U13.32 (IO24); also elsewhere on the board
ESP_SCK: R95.2; also elsewhere on the board
GND: C107.1, C108.1, C109.1, C110.1, J2.4, J3.1, U13.1 (GND), U13.2 (GND), U13.42 (GND), U13.43 (GND), U13.46 (GND), U13.47 (GND), U13.48 (GND), U13.50 (GND), U13.51 (GND), U13.52 (GND), U13.53 (GND), U13.54 (GND), U13.55 (GND), U13.56 (GND), U13.57 (GND), U13.58 (GND), U13.59 (GND), U13.60 (GND), U13.61 (GND), U13.62 (GND), U13.63 (GND), U13.64 (GND), U13.65 (GND); also elsewhere on the board
Reset: U13.31 (IO23); also elsewhere on the board
SWCLK: R86.2; also elsewhere on the board
SWDIO: U13.16 (IO0); also elsewhere on the board

Notes on the sheet:
ESP32-C5-MINI-1-N4 and its 3V3_D decoupling
Reset and download: EN RC delay, GPIO28 pull-up, flashing pads J2
Links to the MCU: SWCLK, SPI2 (UART4 fallback), ESP_CSn pull-up
USB pads J3: the USB Serial/JTAG controller (GPIO13 D-, GPIO14 D+)
Sheet ports

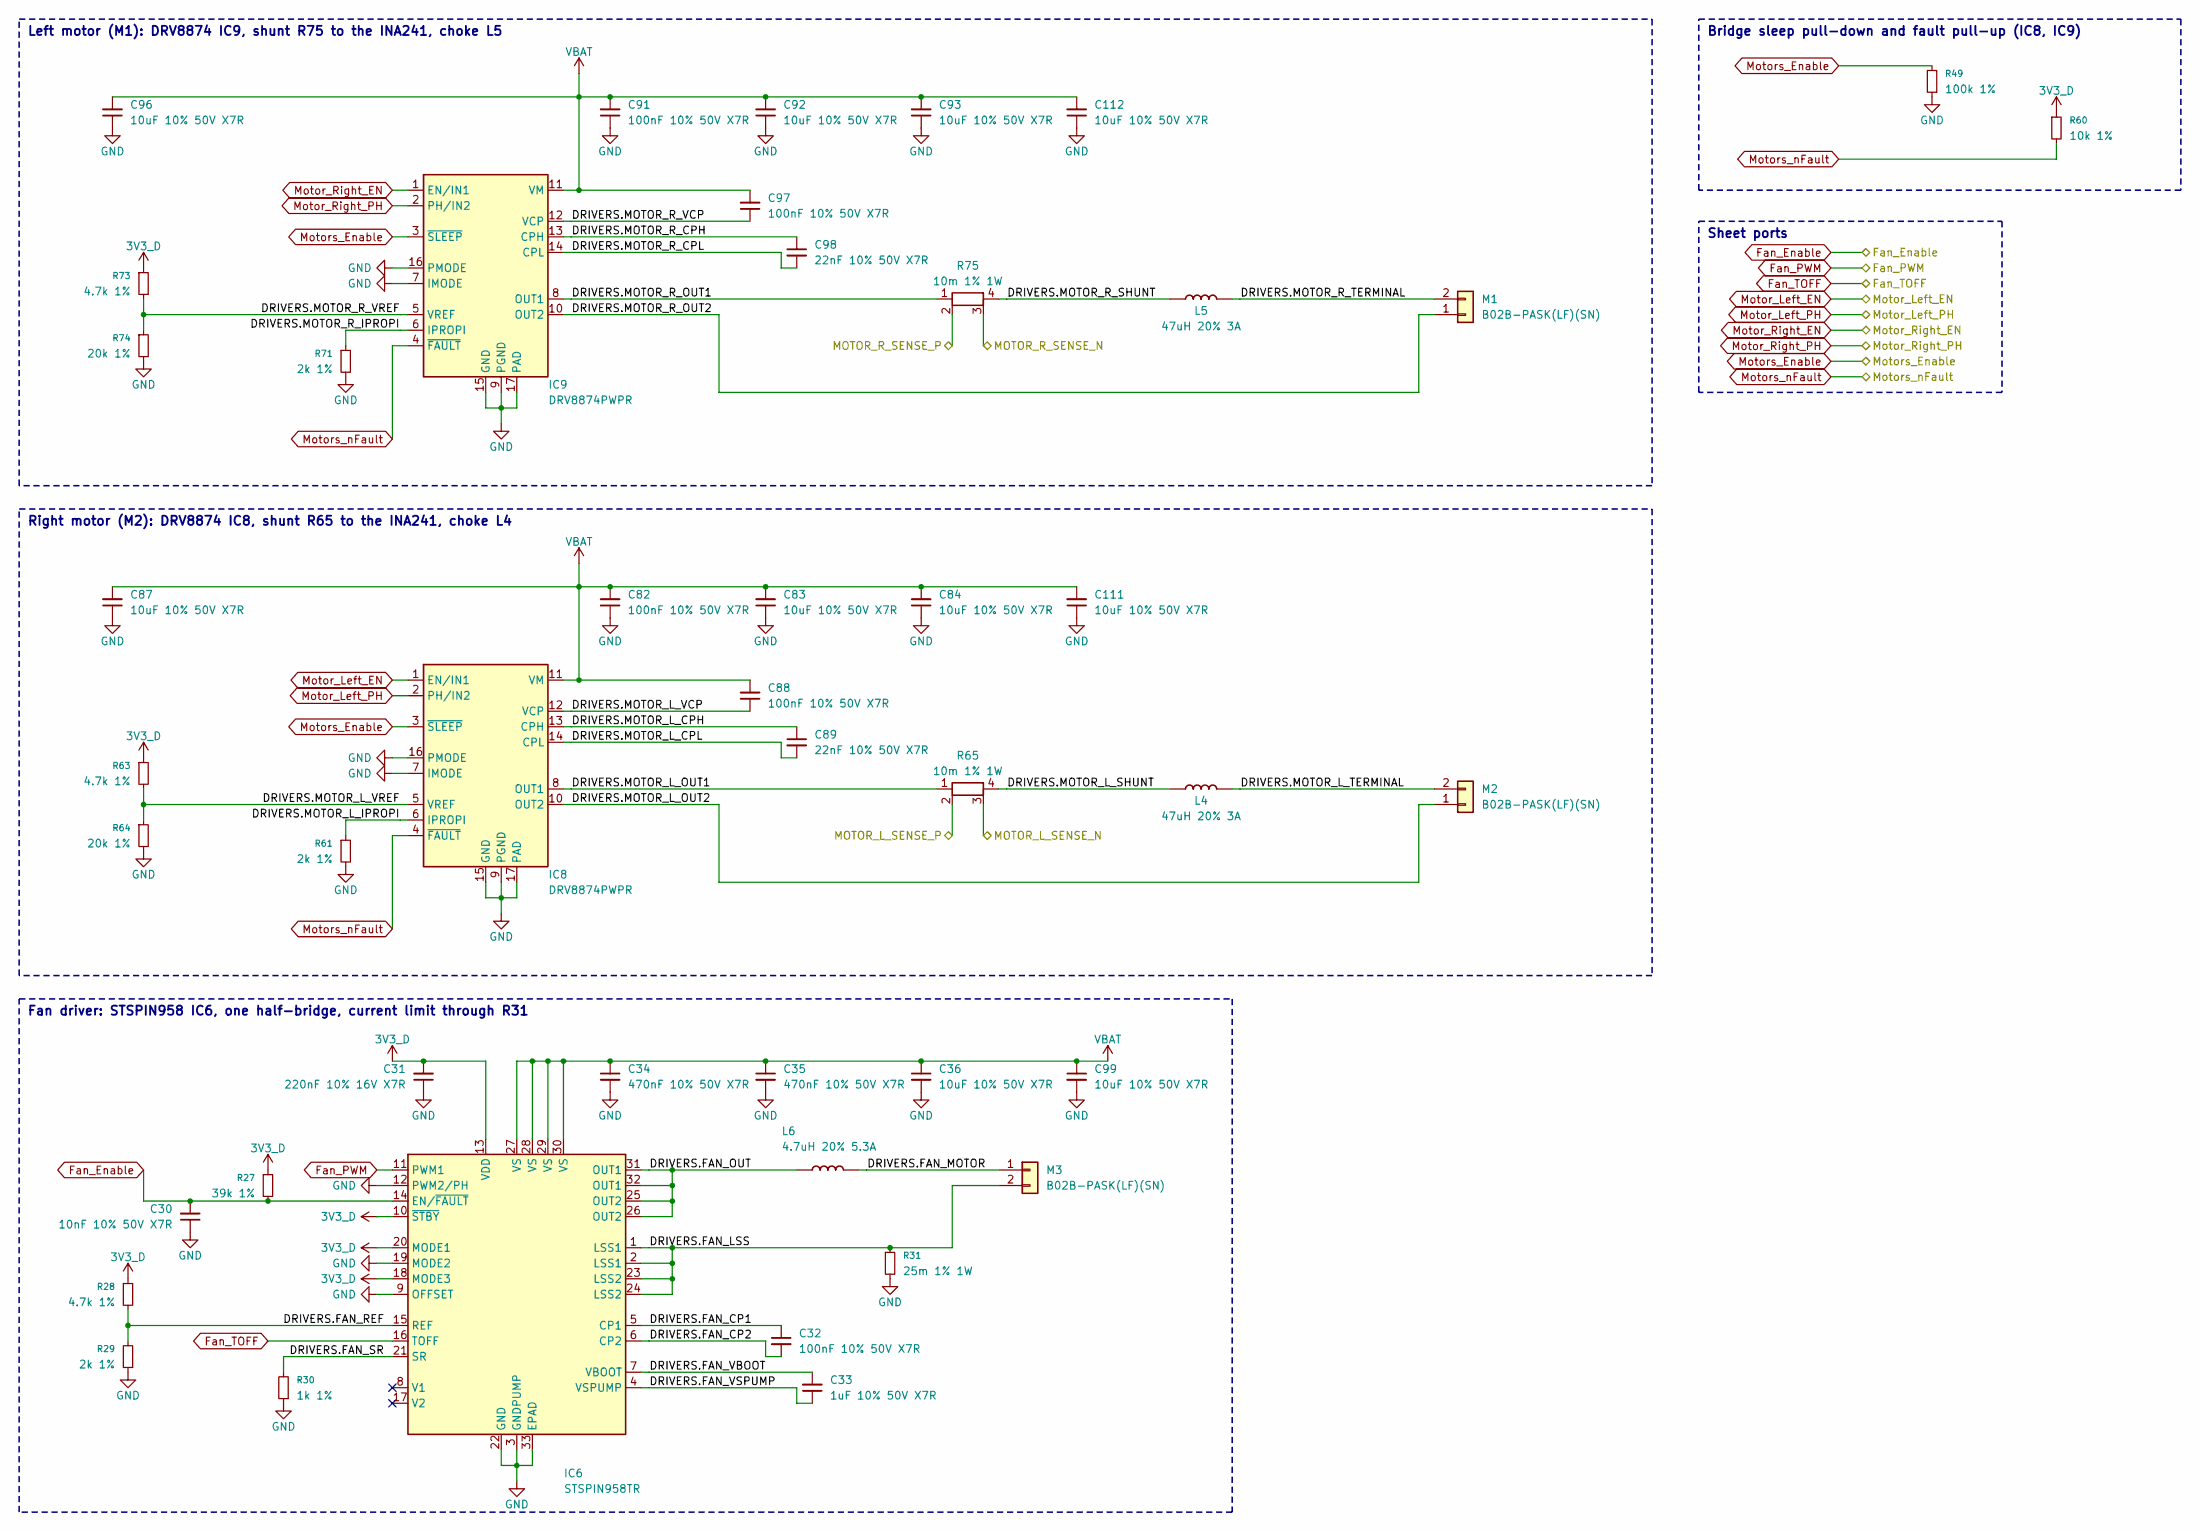
[picture p4: schematic DRIVERS.kicad_sch, Motor bridges and fan driver]

Parts:
C30: 10nF 10% 50V X7R; C_0402_1005Metric
C31: 220nF 10% 16V X7R; C_0402_1005Metric
C32, C82, C88, C91, C97: 100nF 10% 50V X7R; C_0402_1005Metric
C33: 1uF 10% 50V X7R; C_0805_2012Metric
C34, C35: 470nF 10% 50V X7R; C_0805_2012Metric
C36, C83, C84, C87, C92, C93, C96, C99, C111, C112: 10uF 10% 50V X7R; C_1210_3225Metric
C89, C98: 22nF 10% 50V X7R; C_0402_1005Metric
IC6: STSPIN958TR; QFN50P500X500X100-33N-D_SplitPaste
IC8, IC9: DRV8874PWPR; Texas_PWP0016J_HTSSOP-16-1EP_4.4x5mm_P0.65mm_EP3.4x5mm_Mask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
L4, L5: 47uH 20% 3A; L_MetalLions_MTQH707050S
L6: 4.7uH 20% 5.3A; L_MPS_MPL-AL5030
M1, M2, M3: B02B-PASK(LF)(SN); JST_PA_B02B-PASK_1x02_P2.00mm_Vertical
R27: 39k 1%; R_0402_1005Metric
R28, R63, R73: 4.7k 1%; R_0402_1005Metric
R29, R61, R71: 2k 1%; R_0402_1005Metric
R30: 1k 1%; R_0402_1005Metric
R31: 25m 1% 1W; R_1206_3216Metric
R49: 100k 1%; R_0402_1005Metric
R60: 10k 1%; R_0402_1005Metric
R64, R74: 20k 1%; R_0402_1005Metric
R65, R75: 10m 1% 1W; Vishay_WSK2512_6332Metric_5mR-200mR

Connections:
3V3_D: C31.2, IC6.10 (~STBY), IC6.13 (VDD), IC6.18 (MODE3), IC6.20 (MODE1), R27.1, R28.1, R60.1, R63.1, R73.1; also elsewhere on the board
DRIVERS.FAN_CP1: C32.1, IC6.5 (CP1)
DRIVERS.FAN_CP2: C32.2, IC6.6 (CP2)
DRIVERS.FAN_LSS: IC6.1 (LSS1), IC6.2 (LSS1), IC6.23 (LSS2), IC6.24 (LSS2), M3.2, R31.1
DRIVERS.FAN_MOTOR: L6.2, M3.1
DRIVERS.FAN_OUT: IC6.25 (OUT2), IC6.26 (OUT2), IC6.31 (OUT1), IC6.32 (OUT1), L6.1
DRIVERS.FAN_REF: IC6.15 (REF), R28.2, R29.2
DRIVERS.FAN_SR: IC6.21 (SR), R30.2
DRIVERS.FAN_VBOOT: C33.2, IC6.7 (VBOOT)
DRIVERS.FAN_VSPUMP: C33.1, IC6.4 (VSPUMP)
DRIVERS.IC6.NC_STSPIN958_V1: IC6.8 (V1)
DRIVERS.IC6.NC_STSPIN958_V2: IC6.17 (V2)
DRIVERS.MOTOR_L_CPH: C89.1, IC8.13 (CPH)
DRIVERS.MOTOR_L_CPL: C89.2, IC8.14 (CPL)
DRIVERS.MOTOR_L_IPROPI: IC8.6 (IPROPI), R61.1
DRIVERS.MOTOR_L_OUT1: IC8.8 (OUT1), R65.1 (I1)
DRIVERS.MOTOR_L_OUT2: IC8.10 (OUT2), M2.1
DRIVERS.MOTOR_L_SHUNT: L4.1, R65.4 (I2)
DRIVERS.MOTOR_L_TERMINAL: L4.2, M2.2
DRIVERS.MOTOR_L_VCP: C88.1, IC8.12 (VCP)
DRIVERS.MOTOR_L_VREF: IC8.5 (VREF), R63.2, R64.1
DRIVERS.MOTOR_R_CPH: C98.1, IC9.13 (CPH)
DRIVERS.MOTOR_R_CPL: C98.2, IC9.14 (CPL)
DRIVERS.MOTOR_R_IPROPI: IC9.6 (IPROPI), R71.1
DRIVERS.MOTOR_R_OUT1: IC9.8 (OUT1), R75.1 (I1)
DRIVERS.MOTOR_R_OUT2: IC9.10 (OUT2), M1.1
DRIVERS.MOTOR_R_SHUNT: L5.1, R75.4 (I2)
DRIVERS.MOTOR_R_TERMINAL: L5.2, M1.2
DRIVERS.MOTOR_R_VCP: C97.1, IC9.12 (VCP)
DRIVERS.MOTOR_R_VREF: IC9.5 (VREF), R73.2, R74.1
Fan_Enable: C30.2, IC6.14 (EN/~FAULT), R27.2; also elsewhere on the board
Fan_PWM: IC6.11 (PWM1); also elsewhere on the board
Fan_TOFF: IC6.16 (TOFF); also elsewhere on the board
GND: C30.1, C31.1, C34.2, C35.2, C36.2, C82.1, C83.1, C84.1, C87.1, C91.1, C92.1, C93.1, C96.1, C99.2, C111.1, C112.1, IC6.3 (GNDPUMP), IC6.9 (OFFSET), IC6.12 (PWM2/PH), IC6.19 (MODE2), IC6.22 (GND), IC6.33 (EPAD), IC8.7 (IMODE), IC8.9 (PGND), IC8.15 (GND), IC8.16 (PMODE), IC8.17 (PAD), IC9.7 (IMODE), IC9.9 (PGND), IC9.15 (GND), IC9.16 (PMODE), IC9.17 (PAD), R29.1, R30.1, R31.2, R49.1, R61.2, R64.2, R71.2, R74.2; also elsewhere on the board
Motor_L_Sense+: R65.2 (E1); also elsewhere on the board
Motor_L_Sense-: R65.3 (E2); also elsewhere on the board
Motor_Left_EN: IC8.1 (EN/IN1); also elsewhere on the board
Motor_Left_PH: IC8.2 (PH/IN2); also elsewhere on the board
Motor_R_Sense+: R75.2 (E1); also elsewhere on the board
Motor_R_Sense-: R75.3 (E2); also elsewhere on the board
Motor_Right_EN: IC9.1 (EN/IN1); also elsewhere on the board
Motor_Right_PH: IC9.2 (PH/IN2); also elsewhere on the board
Motors_Enable: IC8.3 (~SLEEP), IC9.3 (~SLEEP), R49.2; also elsewhere on the board
Motors_nFault: IC8.4 (~FAULT), IC9.4 (~FAULT), R60.2; also elsewhere on the board
VBAT: C34.1, C35.1, C36.1, C82.2, C83.2, C84.2, C87.2, C88.2, C91.2, C92.2, C93.2, C96.2, C97.2, C99.1, C111.2, C112.2, IC6.27 (VS), IC6.28 (VS), IC6.29 (VS), IC6.30 (VS), IC8.11 (VM), IC9.11 (VM); also elsewhere on the board

Notes on the sheet:
Left motor (M1): DRV8874 IC9, shunt R75 to the INA241, choke L5
Right motor (M2): DRV8874 IC8, shunt R65 to the INA241, choke L4
Fan driver: STSPIN958 IC6, one half-bridge, current limit through R31
Bridge sleep pull-down and fault pull-up (IC8, IC9)
Sheet ports

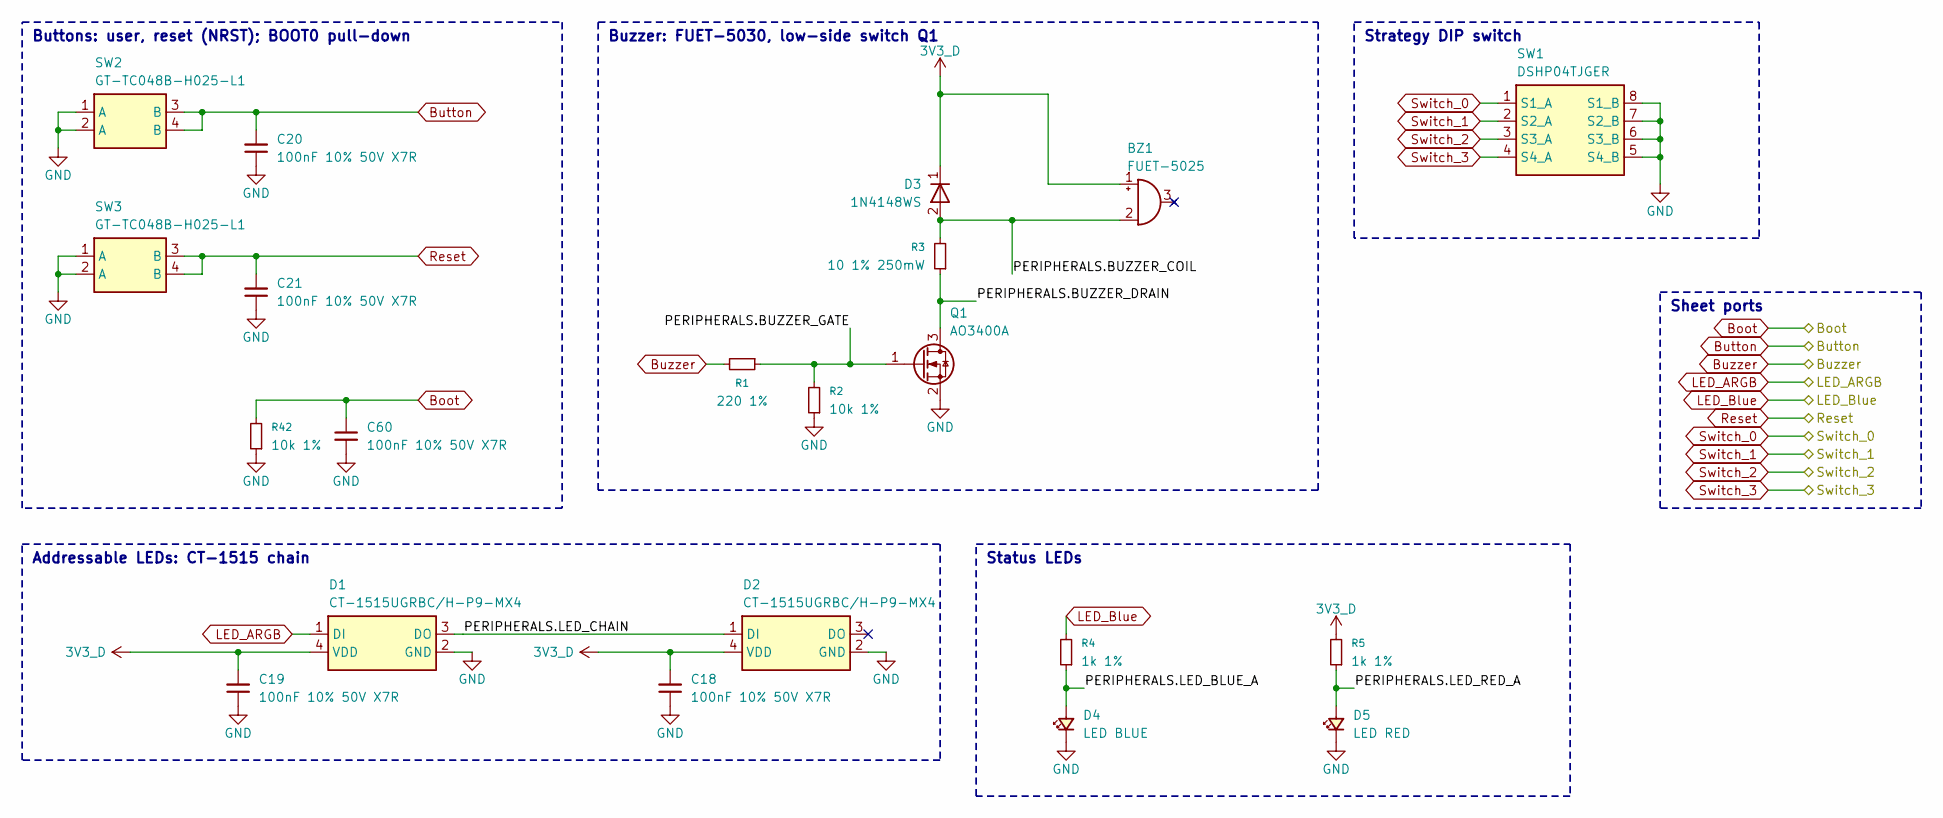
[picture p5: schematic PERIPHERALS.kicad_sch, User interface]

Parts:
BZ1: FUET-5025; BUZ-SMD_FST-5025
C18, C19, C20, C21, C60: 100nF 10% 50V X7R; C_0402_1005Metric
D1, D2: CT-1515UGRBC/H-P9-MX4; LED-SMD_4P-L1.5-W1.5-P1.04_CT-1515UGRBC
D3: 1N4148WS; D_SOD-323
D4: LED BLUE; LED_0603_1608Metric
D5: LED RED; LED_0603_1608Metric
Q1: AO3400A; SOT-23-3_L2.9-W1.3-P1.90-LS2.4-BR
R1: 220 1%; R_0402_1005Metric
R2, R42: 10k 1%; R_0402_1005Metric
R3: 10 1% 250mW; R_1206_3216Metric
R4, R5: 1k 1%; R_0402_1005Metric
SW1: DSHP04TJGER; SW-SMD_8P-L6.7-W5.4-P1.27-LS5.6
SW2, SW3: GT-TC048B-H025-L1; SW-SMD-4P_L4.2-W3.2_GT-TC048

Connections:
3V3_D: BZ1.1 (+), C18.2, C19.2, D1.4 (VDD), D2.4 (VDD), D3.1 (K), R5.2; also elsewhere on the board
Boot: C60.1, R42.2; also elsewhere on the board
Button: C20.2, SW2.3 (B), SW2.4 (B); also elsewhere on the board
Buzzer: R1.2; also elsewhere on the board
GND: C18.1, C19.1, C20.1, C21.1, C60.2, D1.2 (GND), D2.2 (GND), D4.1 (K), D5.1 (K), Q1.2 (S), R2.1, R42.1, SW1.5 (S4_B), SW1.6 (S3_B), SW1.7 (S2_B), SW1.8 (S1_B), SW2.1 (A), SW2.2 (A), SW3.1 (A), SW3.2 (A); also elsewhere on the board
LED_ARGB: D1.1 (DI); also elsewhere on the board
LED_Blue: R4.2; also elsewhere on the board
PERIPHERALS.BUZZER_COIL: BZ1.2 (-), D3.2 (A), R3.2
PERIPHERALS.BUZZER_DRAIN: Q1.3 (D), R3.1
PERIPHERALS.BUZZER_GATE: Q1.1 (G), R1.1, R2.2
PERIPHERALS.BZ1.NC_BUZZER_NC: BZ1.3 (NC)
PERIPHERALS.D2.NC_LED_DO: D2.3 (DO)
PERIPHERALS.LED_BLUE_A: D4.2 (A), R4.1
PERIPHERALS.LED_CHAIN: D1.3 (DO), D2.1 (DI)
PERIPHERALS.LED_RED_A: D5.2 (A), R5.1
Reset: C21.2, SW3.3 (B), SW3.4 (B); also elsewhere on the board
Switch_0: SW1.1 (S1_A); also elsewhere on the board
Switch_1: SW1.2 (S2_A); also elsewhere on the board
Switch_2: SW1.3 (S3_A); also elsewhere on the board
Switch_3: SW1.4 (S4_A); also elsewhere on the board

Notes on the sheet:
Buzzer: FUET-5030, low-side switch Q1
Buttons: user, reset (NRST); BOOT0 pull-down
Addressable LEDs: CT-1515 chain
Strategy DIP switch
Status LEDs
Sheet ports

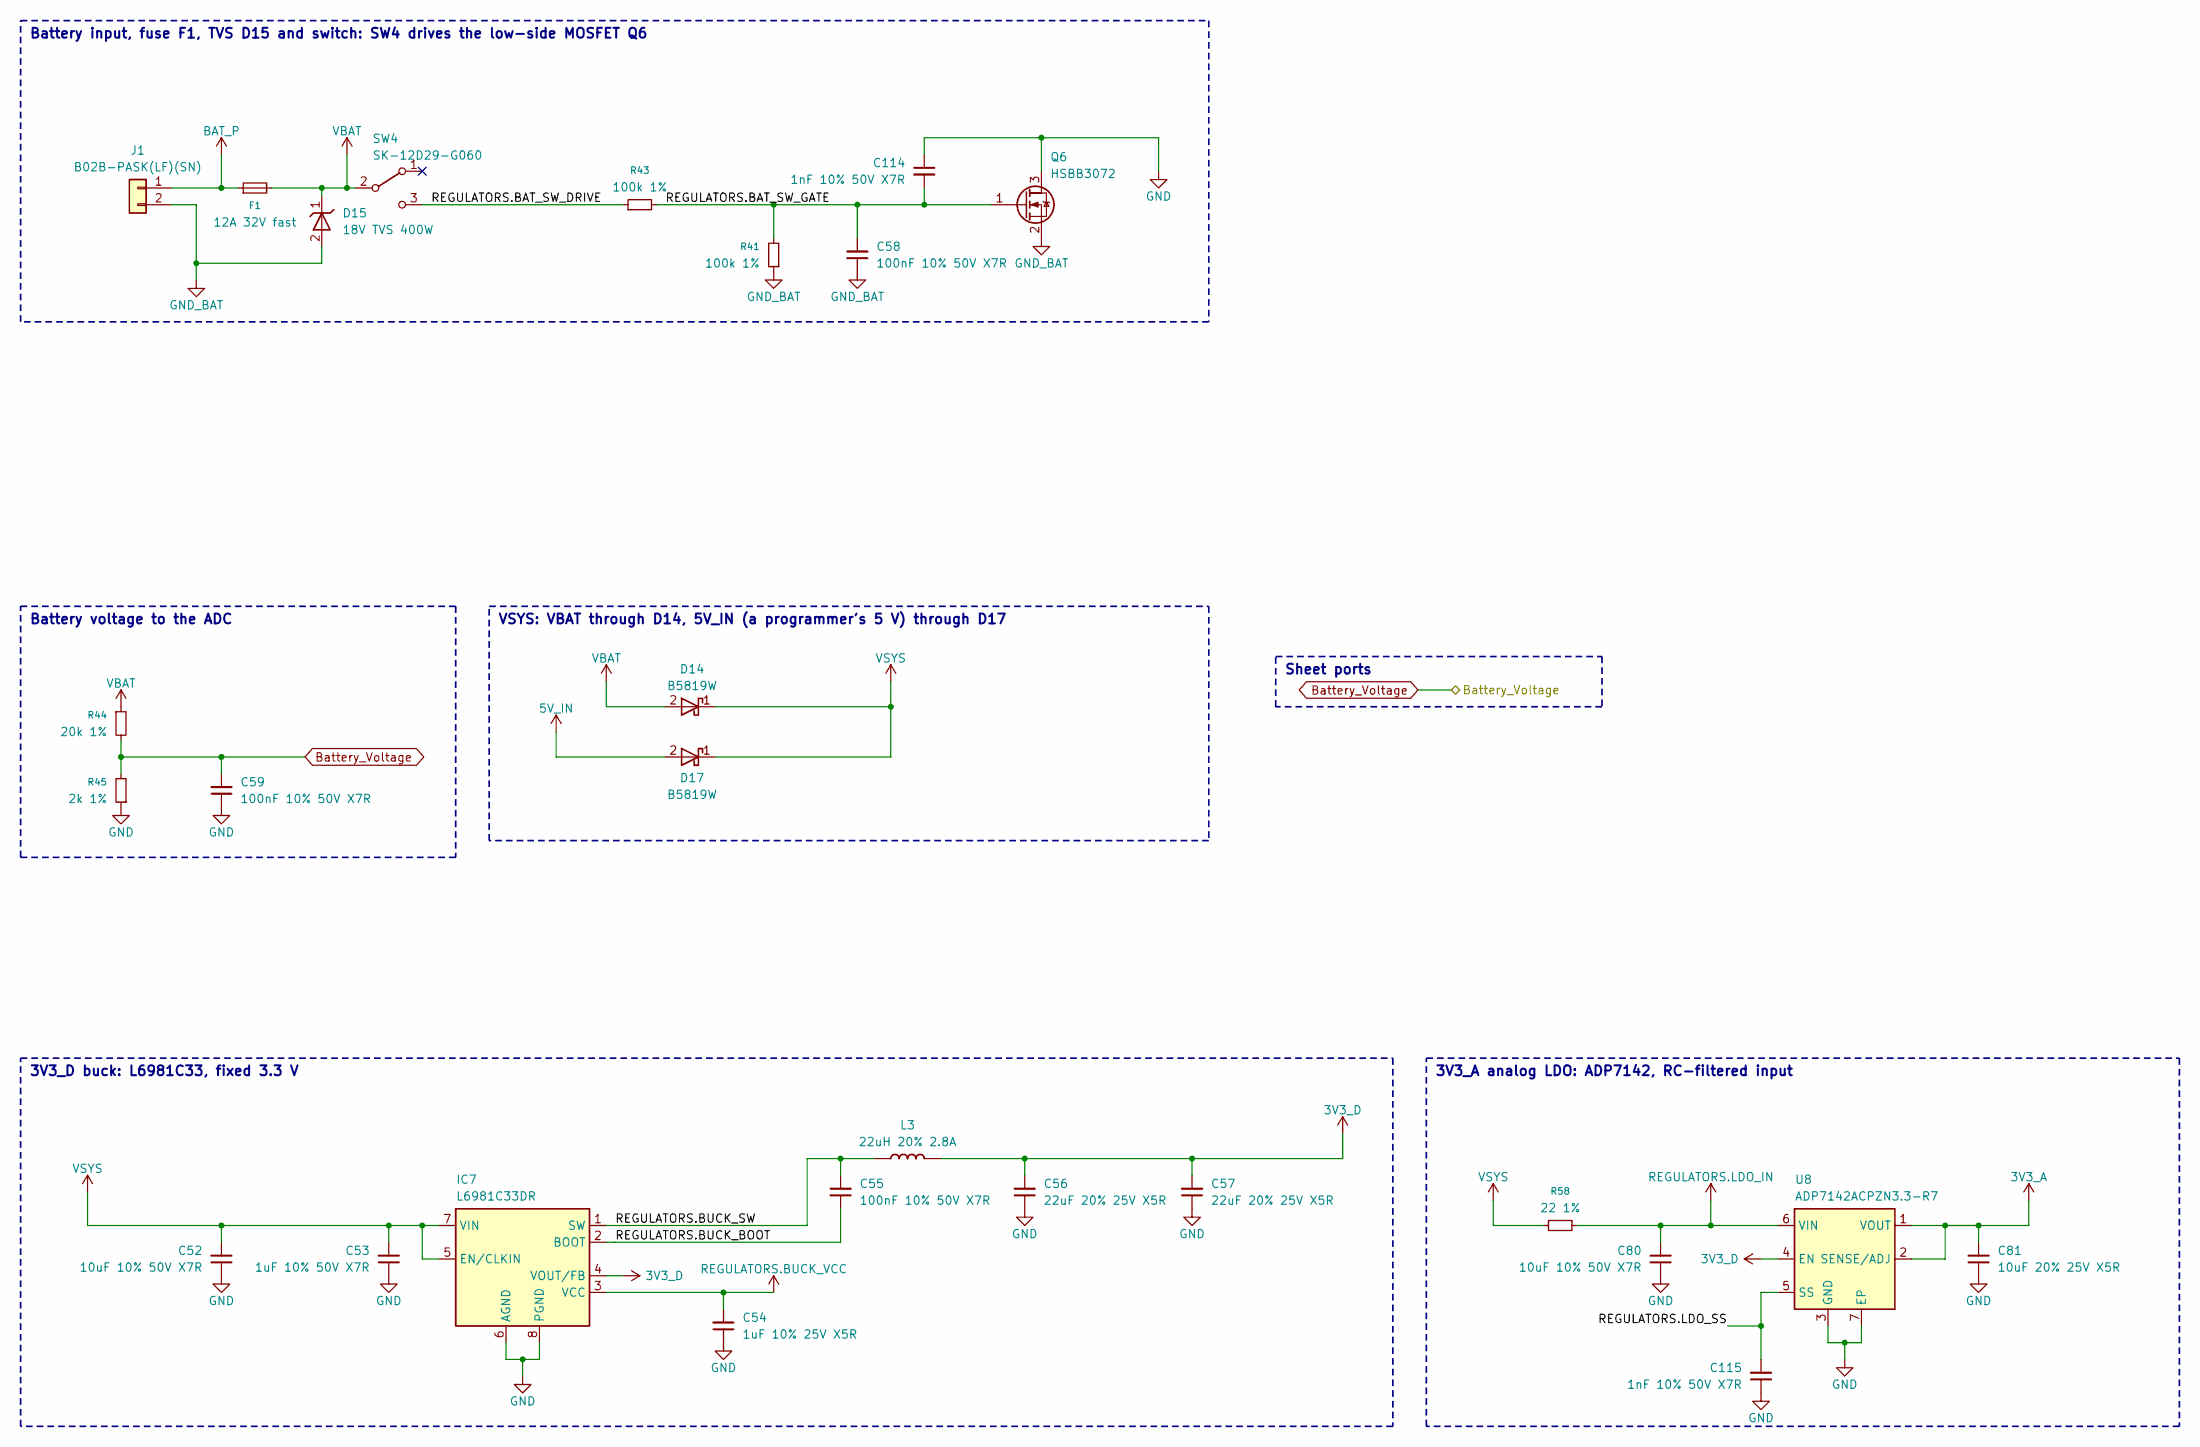
[picture p6: schematic REGULATORS.kicad_sch, Battery input, VSYS and regulators]

Parts:
C52, C80: 10uF 10% 50V X7R; C_1210_3225Metric
C53: 1uF 10% 50V X7R; C_0805_2012Metric
C54: 1uF 10% 25V X5R; C_0402_1005Metric
C55, C58, C59: 100nF 10% 50V X7R; C_0402_1005Metric
C56, C57: 22uF 20% 25V X5R; C_0805_2012Metric
C81: 10uF 20% 25V X5R; C_0603_1608Metric
C114, C115: 1nF 10% 50V X7R; C_0402_1005Metric
D14, D17: B5819W; D_SOD-123
D15: 18V TVS 400W; D_SMA
F1: 12A 32V fast; Fuse_Littelfuse_501_1206
IC7: L6981C33DR; SOIC127P600X175-8N
J1: B02B-PASK(LF)(SN); JST_PA_B02B-PASK_1x02_P2.00mm_Vertical
L3: 22uH 20% 2.8A; IND-SMD_L6.5-W6.0
Q6: HSBB3072; PRPAK-8_L3.0-W3.0-P0.65-BL-EP_SplitPaste
R41, R43: 100k 1%; R_0402_1005Metric
R44: 20k 1%; R_0402_1005Metric
R45: 2k 1%; R_0402_1005Metric
R58: 22 1%; R_0402_1005Metric
SW4: SK-12D29-G060; SW-TH_SK-12D29-G060
U8: ADP7142ACPZN3.3-R7; LFCSP-6-1EP_2x2mm_P0.65mm_EP1x1.6mm

Connections:
3V3_A: C81.2, U8.1 (VOUT), U8.2 (SENSE/ADJ); also elsewhere on the board
3V3_D: C56.2, C57.2, IC7.4 (VOUT/FB), L3.2, U8.4 (EN); also elsewhere on the board
5V_IN: D17.2 (A); also elsewhere on the board
BAT_P: F1.1, J1.1
Battery_Voltage: C59.2, R44.2, R45.2; also elsewhere on the board
GND: C52.1, C53.1, C54.1, C56.1, C57.1, C59.1, C80.1, C81.1, C114.1, C115.1, IC7.6 (AGND), IC7.8 (PGND), Q6.3 (D), R45.1, U8.3 (GND), U8.7 (EP); also elsewhere on the board
GND_BAT: C58.1, D15.2 (A), J1.2, Q6.2 (S), R41.1
REGULATORS.BAT_SW_DRIVE: R43.1, SW4.3 (B)
REGULATORS.BAT_SW_GATE: C58.2, C114.2, Q6.1 (G), R41.2, R43.2
REGULATORS.BUCK_BOOT: C55.1, IC7.2 (BOOT)
REGULATORS.BUCK_SW: C55.2, IC7.1 (SW), L3.1
REGULATORS.BUCK_VCC: C54.2, IC7.3 (VCC)
REGULATORS.LDO_IN: C80.2, R58.2, U8.6 (VIN)
REGULATORS.LDO_SS: C115.2, U8.5 (SS)
REGULATORS.SW4.NC_SK-12D29-G060_A: SW4.1 (A)
VBAT: D14.2 (A), D15.1 (K), F1.2, R44.1, SW4.2 (COM); also elsewhere on the board
VSYS: C52.2, C53.2, D14.1 (K), D17.1 (K), IC7.5 (EN/CLKIN), IC7.7 (VIN), R58.1

Notes on the sheet:
Battery input, fuse F1, TVS D15 and switch: SW4 drives the low-side MOSFET Q6
Battery voltage to the ADC
VSYS: VBAT through D14, 5V_IN (a programmer's 5 V) through D17
3V3_D buck: L6981C33, fixed 3.3 V
3V3_A analog LDO: ADP7142, RC-filtered input
Sheet ports
