Team-Micras/MicrasPCB/boards/main/layout/main.kicad_pcb

## KiCad design boards/main/layout/main.kicad_pcb (continued)

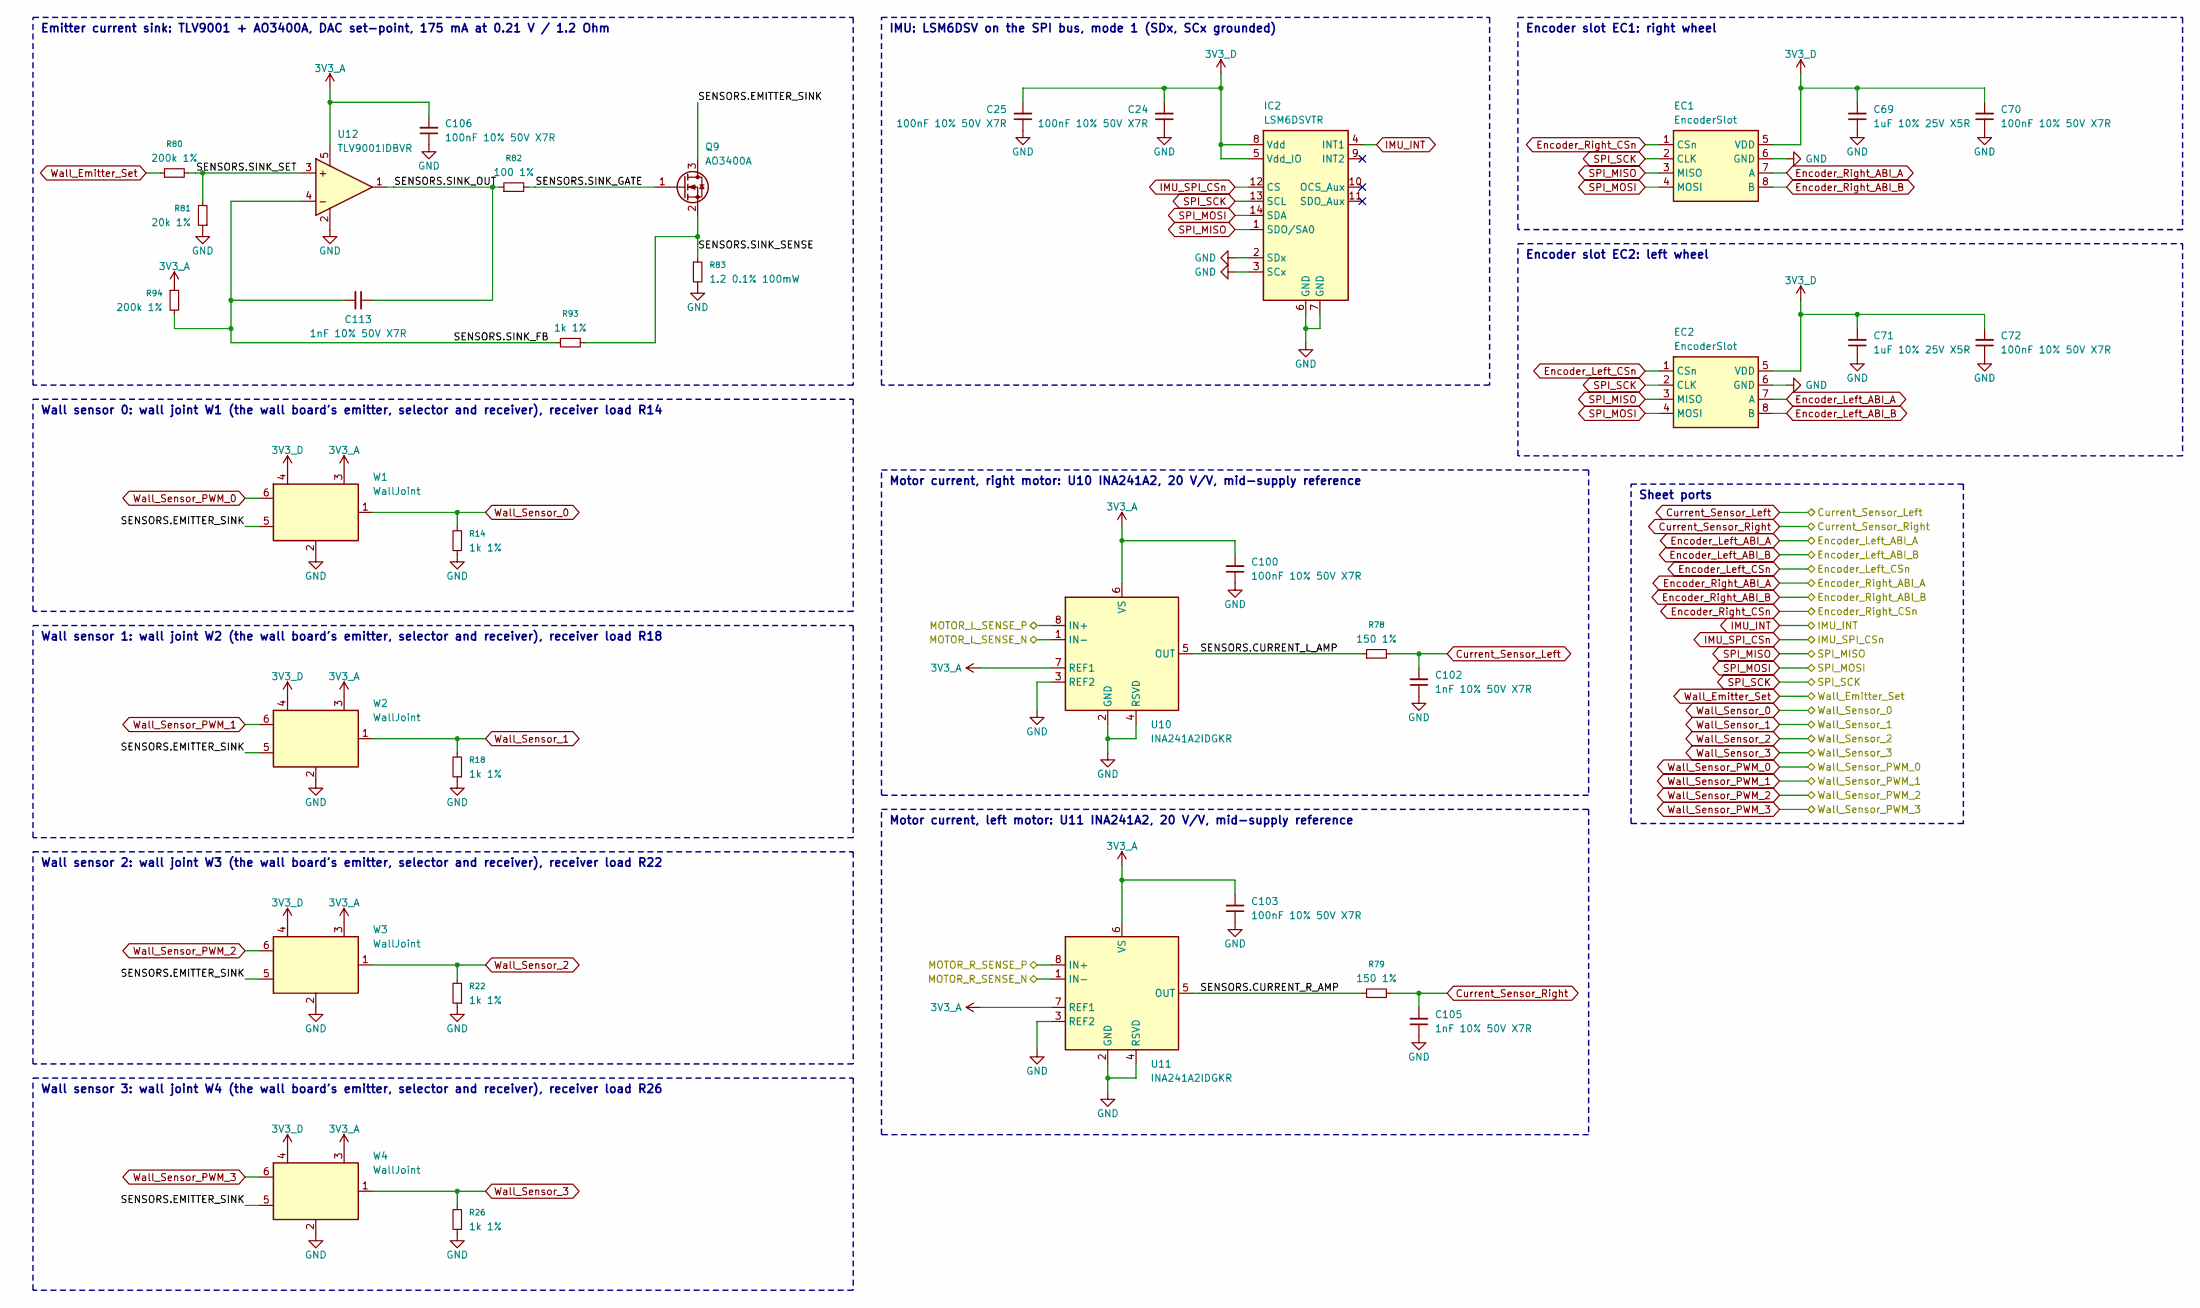
[picture p7: schematic SENSORS.kicad_sch, Sensors: IMU, encoders, motor current, wall sensors]

Parts:
C24, C25, C70, C72, C100, C103, C106: 100nF 10% 50V X7R; C_0402_1005Metric
C69, C71: 1uF 10% 25V X5R; C_0402_1005Metric
C102, C105, C113: 1nF 10% 50V X7R; C_0402_1005Metric
EC1, EC2: EncoderSlot; EncoderSlot_2x4_P0.95mm
IC2: LSM6DSVTR; LGA-14_3x2.5mm_P0.5mm
Q9: AO3400A; SOT-23-3_L2.9-W1.3-P1.90-LS2.4-BR
R14, R18, R22, R26, R93: 1k 1%; R_0402_1005Metric
R78, R79: 150 1%; R_0402_1005Metric
R80, R94: 200k 1%; R_0402_1005Metric
R81: 20k 1%; R_0402_1005Metric
R82: 100 1%; R_0402_1005Metric
R83: 1.2 0.1% 100mW; R_0603_1608Metric
U10, U11: INA241A2IDGKR; Texas_DGK0008A_VSSOP-8_3x3mm_P0.65mm
U12: TLV9001IDBVR; SOT-23-5
W1, W2, W3, W4: WallJoint; WallJoint_2x03_P1.27mm

Connections:
3V3_A: C100.2, C103.2, C106.2, R94.1, U10.6 (VS), U10.7 (REF1), U11.6 (VS), U11.7 (REF1), U12.5 (V+), W1.3 (3V3_A), W2.3 (3V3_A), W3.3 (3V3_A), W4.3 (3V3_A); also elsewhere on the board
3V3_D: C24.2, C25.2, C69.2, C70.2, C71.2, C72.2, EC1.5 (VDD), EC2.5 (VDD), IC2.5 (Vdd_IO), IC2.8 (Vdd), W1.4 (3V3_D), W2.4 (3V3_D), W3.4 (3V3_D), W4.4 (3V3_D); also elsewhere on the board
Current_Sensor_Left: C102.2, R78.2; also elsewhere on the board
Current_Sensor_Right: C105.2, R79.2; also elsewhere on the board
Encoder_Left_ABI_A: EC2.7 (A); also elsewhere on the board
Encoder_Left_ABI_B: EC2.8 (B); also elsewhere on the board
Encoder_Left_CSn: EC2.1 (CSn); also elsewhere on the board
Encoder_Right_ABI_A: EC1.7 (A); also elsewhere on the board
Encoder_Right_ABI_B: EC1.8 (B); also elsewhere on the board
Encoder_Right_CSn: EC1.1 (CSn); also elsewhere on the board
GND: C24.1, C25.1, C69.1, C70.1, C71.1, C72.1, C100.1, C102.1, C103.1, C105.1, C106.1, EC1.6 (GND), EC2.6 (GND), IC2.2 (SDx), IC2.3 (SCx), IC2.6 (GND), IC2.7 (GND), R14.1, R18.1, R22.1, R26.1, R81.1, R83.2, U10.2 (GND), U10.3 (REF2), U10.4 (RSVD), U11.2 (GND), U11.3 (REF2), U11.4 (RSVD), U12.2 (V-), W1.2 (GND), W2.2 (GND), W3.2 (GND), W4.2 (GND); also elsewhere on the board
IMU_INT: IC2.4 (INT1); also elsewhere on the board
IMU_SPI_CSn: IC2.12 (CS); also elsewhere on the board
Motor_L_Sense+: U10.8 (IN+); also elsewhere on the board
Motor_L_Sense-: U10.1 (IN-); also elsewhere on the board
Motor_R_Sense+: U11.8 (IN+); also elsewhere on the board
Motor_R_Sense-: U11.1 (IN-); also elsewhere on the board
SENSORS.CURRENT_L_AMP: R78.1, U10.5 (OUT)
SENSORS.CURRENT_R_AMP: R79.1, U11.5 (OUT)
SENSORS.EMITTER_SINK: Q9.3 (D), W1.5 (SINK), W2.5 (SINK), W3.5 (SINK), W4.5 (SINK)
SENSORS.IC2.NC_LSM6DSV_INT2: IC2.9 (INT2)
SENSORS.IC2.NC_LSM6DSV_OCS_Aux: IC2.10 (OCS_Aux)
SENSORS.IC2.NC_LSM6DSV_SDO_Aux: IC2.11 (SDO_Aux)
SENSORS.SINK_FB: C113.2, R93.2, R94.2, U12.4 (-)
SENSORS.SINK_GATE: Q9.1 (G), R82.2
SENSORS.SINK_OUT: C113.1, R82.1, U12.1 (OUT)
SENSORS.SINK_SENSE: Q9.2 (S), R83.1, R93.1
SENSORS.SINK_SET: R80.2, R81.2, U12.3 (+)
SPI_MISO: EC1.3 (MISO), EC2.3 (MISO), IC2.1 (SDO/SA0); also elsewhere on the board
SPI_MOSI: EC1.4 (MOSI), EC2.4 (MOSI), IC2.14 (SDA); also elsewhere on the board
SPI_SCK: EC1.2 (CLK), EC2.2 (CLK), IC2.13 (SCL); also elsewhere on the board
Wall_Emitter_Set: R80.1; also elsewhere on the board
Wall_Sensor_0: R14.2, W1.1 (OUT); also elsewhere on the board
Wall_Sensor_1: R18.2, W2.1 (OUT); also elsewhere on the board
Wall_Sensor_2: R22.2, W3.1 (OUT); also elsewhere on the board
Wall_Sensor_3: R26.2, W4.1 (OUT); also elsewhere on the board
Wall_Sensor_PWM_0: W1.6 (PWM); also elsewhere on the board
Wall_Sensor_PWM_1: W2.6 (PWM); also elsewhere on the board
Wall_Sensor_PWM_2: W3.6 (PWM); also elsewhere on the board
Wall_Sensor_PWM_3: W4.6 (PWM); also elsewhere on the board

Notes on the sheet:
Emitter current sink: TLV9001 + AO3400A, DAC set-point, 175 mA at 0.21 V / 1.2 Ohm
Wall sensor 0: wall joint W1 (the wall board's emitter, selector and receiver), receiver load R14
Wall sensor 1: wall joint W2 (the wall board's emitter, selector and receiver), receiver load R18
Wall sensor 2: wall joint W3 (the wall board's emitter, selector and receiver), receiver load R22
Wall sensor 3: wall joint W4 (the wall board's emitter, selector and receiver), receiver load R26
IMU: LSM6DSV on the SPI bus, mode 1 (SDx, SCx grounded)
Encoder slot EC1: right wheel
Encoder slot EC2: left wheel
Motor current, right motor: U10 INA241A2, 20 V/V, mid-supply reference
Motor current, left motor: U11 INA241A2, 20 V/V, mid-supply reference
Sheet ports

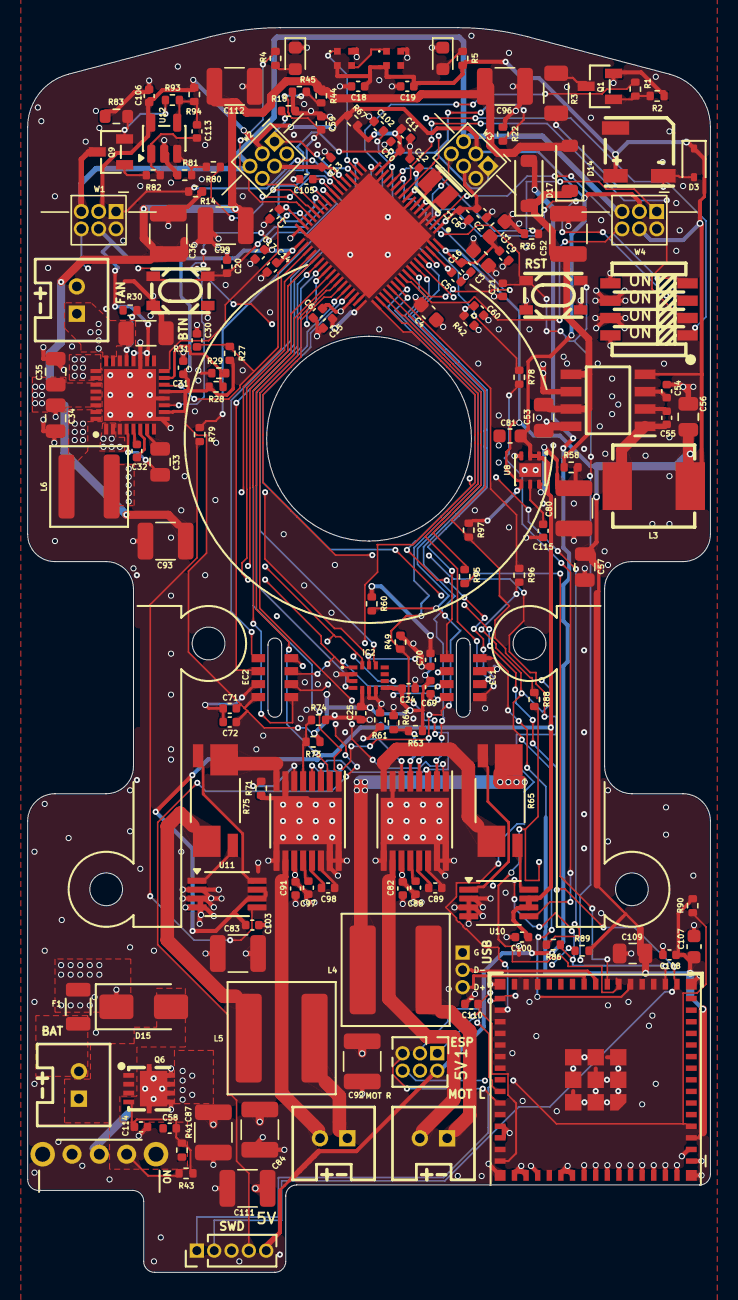
[picture p8: board main.kicad_pcb from above]

Board: 4 copper layers, 50.0 x 91.1 mm, 168 parts (0 on the bottom side), 121 nets.
