Team-Micras/MicrasPCB/boards/encoder/layout/encoder.kicad_pcb

## KiCad design boards/encoder/layout/encoder.kicad_pcb (2026-11-08)

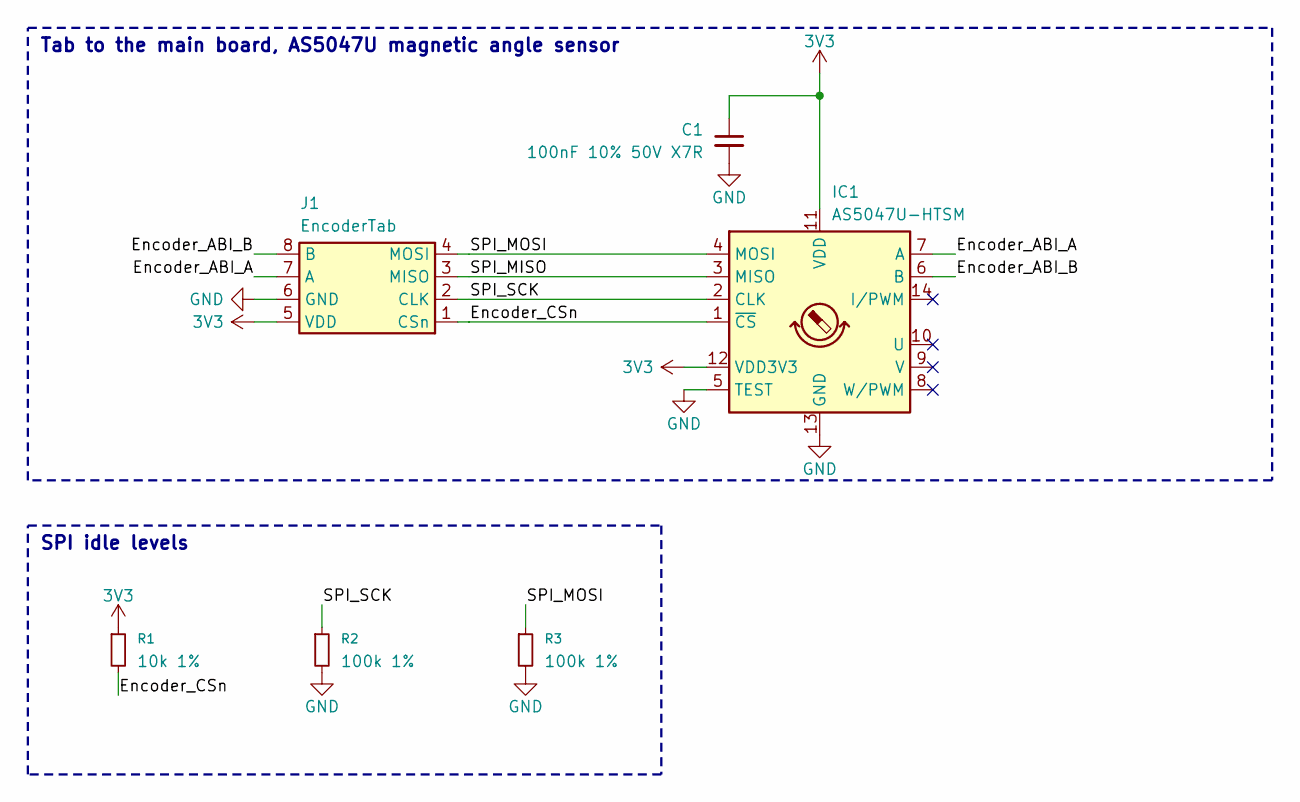
[picture p9: schematic encoder.kicad_sch, Wheel encoder]

Parts:
C1: 100nF 10% 50V X7R; C_0603_1608Metric
IC1: AS5047U-HTSM; SOP65P640X120-14N
J1: EncoderTab; ENCODER_CONN
R1: 10k 1%; R_0402_1005Metric
R2, R3: 100k 1%; R_0402_1005Metric

Connections:
3V3: C1.1, IC1.11 (VDD), IC1.12 (VDD3V3), J1.5 (VDD), R1.1
Encoder_ABI_A: IC1.7 (A), J1.7 (A)
Encoder_ABI_B: IC1.6 (B), J1.8 (B)
Encoder_CSn: IC1.1 (~CS), J1.1 (CSn), R1.2
GND: C1.2, IC1.5 (TEST), IC1.13 (GND), J1.6 (GND), R2.2, R3.2
IC1.NC_AS5047U_I/PWM: IC1.14 (I/PWM)
IC1.NC_AS5047U_U: IC1.10 (U)
IC1.NC_AS5047U_V: IC1.9 (V)
IC1.NC_AS5047U_W/PWM: IC1.8 (W/PWM)
SPI_MISO: IC1.3 (MISO), J1.3 (MISO)
SPI_MOSI: IC1.4 (MOSI), J1.4 (MOSI), R3.1
SPI_SCK: IC1.2 (CLK), J1.2 (CLK), R2.1

Notes on the sheet:
Tab to the main board, AS5047U magnetic angle sensor
SPI idle levels

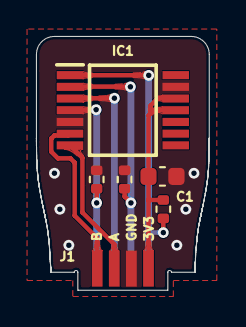
[picture p10: board encoder.kicad_pcb from above]

Board: 2 copper layers, 9.6 x 14.1 mm, 6 parts (0 on the bottom side), 8 nets.
