Team-Micras/MicrasPCB/boards/wall/layout/wall.kicad_pcb

## KiCad design boards/wall/layout/wall.kicad_pcb (2026-11-08)

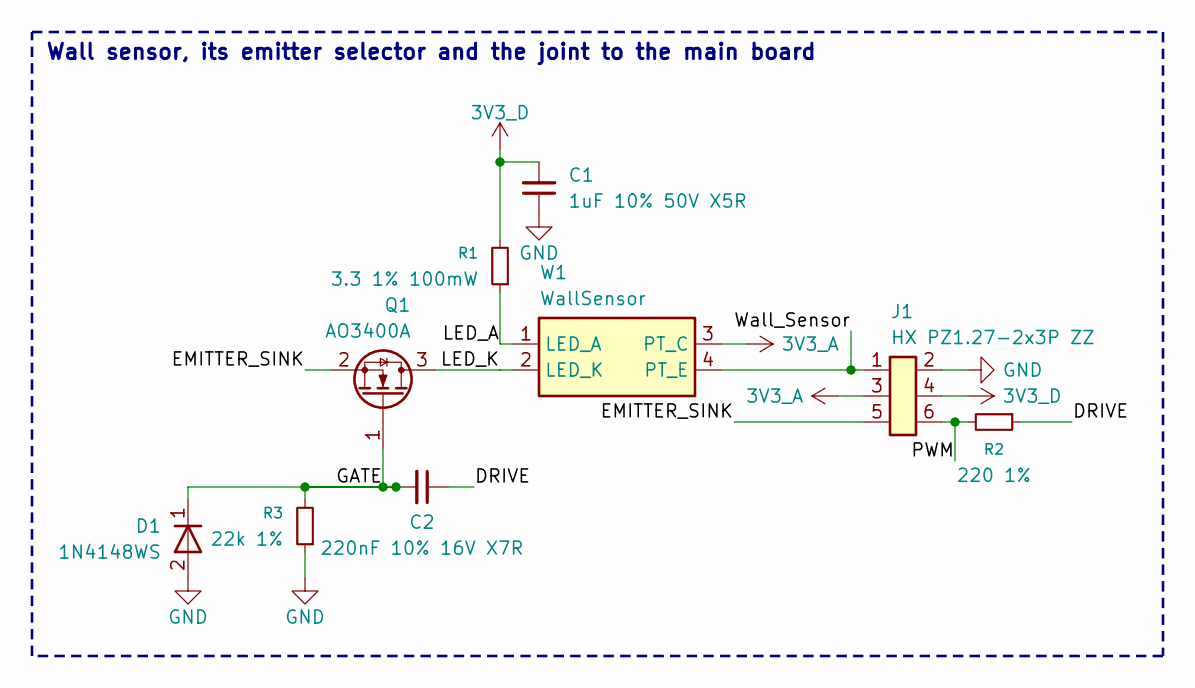
[picture p11: schematic wall.kicad_sch, Micras wall-sensor board]

Parts:
C1: 1uF 10% 50V X5R; C_0603_1608Metric
C2: 220nF 10% 16V X7R; C_0402_1005Metric
D1: 1N4148WS; D_SOD-323
J1: HX PZ1.27-2x3P ZZ; HX-PZ1.27-2x3P-ZZ_Straddle
Q1: AO3400A; SOT-23-3_L2.9-W1.3-P1.90-LS2.4-BR
R1: 3.3 1% 100mW; R_0603_1608Metric
R2: 220 1%; R_0402_1005Metric
R3: 22k 1%; R_0402_1005Metric
W1: WallSensor; WallSensor_SFH4550_TPS601A_Upright

Connections:
3V3_A: J1.3, W1.3 (PT_C)
3V3_D: C1.2, J1.4, R1.2
DRIVE: C2.1, R2.1
EMITTER_SINK: J1.5, Q1.2 (S)
GATE: C2.2, D1.1 (K), Q1.1 (G), R3.2
GND: C1.1, D1.2 (A), J1.2, R3.1
LED_A: R1.1, W1.1 (LED_A)
LED_K: Q1.3 (D), W1.2 (LED_K)
PWM: J1.6, R2.2
Wall_Sensor: J1.1, W1.4 (PT_E)

Notes on the sheet:
Wall sensor, its emitter selector and the joint to the main board

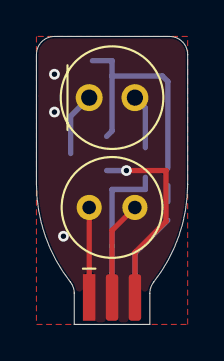
[picture p12: board wall.kicad_pcb from above]

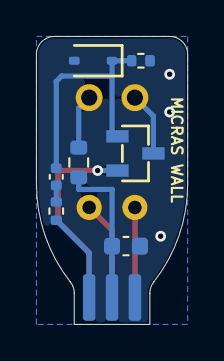
[picture p13: board wall.kicad_pcb from below]

Board: 2 copper layers, 8.4 x 16.0 mm, 9 parts (7 on the bottom side), 10 nets.
