Team-Micras/MicrasPCB/tools/micras_pcb/cli.py

"""micras-pcb: one entry point for the repo's generators and checks (see README)."""

from __future__ import annotations

import argparse
import sys
from pathlib import Path

from . import assembly, checks, firmware, jlc, lvs, mech, order, outputs, placement, previous
from .paths import SCHEMATIC_ONLY, boards, has_layout

# Commands that read the layout: a schematic-only board skips them with the reason.
LAYOUT_COMMANDS = {"lvs", "drc", "dfm"}


def main(argv: list[str] | None = None) -> int:
    ap = argparse.ArgumentParser(prog="micras-pcb")
    sub = ap.add_subparsers(dest="cmd", required=True)

    def board_cmd(name: str, help: str, check: bool = False):
        p = sub.add_parser(name, help=help)
        p.add_argument("boards", nargs="*", help="board names (default: all)")
        if check:
            p.add_argument("--check", action="store_true", help="verify only; fail on drift (CI)")
        return p

    board_cmd("mech", "apply spec/<board>.toml to the layout and export <board>_mech.json", check=True)
    board_cmd(
        "rules", "copy rules/jlcpcb.kicad_dru and set rules/kicad-severities.toml in each board's project", check=True
    )
    p = board_cmd(
        "sch",
        "place the generated schematic from boards/<board>/schematic/*.toml, drafting what they leave out"
        " (check: placed cleanly and up to date)",
        check=True,
    )
    p.add_argument("--info", metavar="SHEET", help="print a sheet's parts and pins (board, then refs to show)")
    p.add_argument(
        "--draft",
        action="store_true",
        help="write drafted entries for parts without one into the placement files (marked auto = true)",
    )
    p.add_argument("--sheet", help="with --draft: only this sheet")
    p.add_argument("--all", action="store_true", help="with --draft: draft whole sheets into build/<board>/sch-draft/")
    board_cmd("erc", "KiCad ERC on the generated schematic")
    board_cmd("drc", "KiCad DRC with the JLCPCB rules and zone refill")
    board_cmd("lvs", "connectivity of the generated schematic vs the PCB")
    board_cmd("dfm", "Diode DFM against the JLCPCB PDK")
    board_cmd(
        "fab", "JLCPCB gerbers, drill, BOM, CPL and order options into build/<board>/fab (a panel's, if spec has one)"
    )
    p = board_cmd("quote", "JLCPCB's bare-board price with each board's order options (online)")
    p.add_argument("--qty", type=int, default=5, help="boards, or panels for a panelised board (default: 5)")
    board_cmd("outputs", "review outputs: schematic PDF/SVG, layer SVGs, 3D renders, GLB/STEP")
    sub.add_parser(
        "assembly",
        help="the main board with its wall and encoder boards in place: build/main/review/assembly.glb/.step and renders",
    )
    p = sub.add_parser("parts", help="check parts/jlc.toml covers every board")
    p.add_argument("--online", action="store_true", help="also query JLCPCB stock and library type")
    p = sub.add_parser("previous", help="a board's previous revision: snapshot and connectivity comparison")
    psub = p.add_subparsers(dest="action", required=True)
    s = psub.add_parser("snapshot", help="write boards/<board>/previous/board.json from the previous revision")
    s.add_argument("board", choices=sorted(previous.SOURCES), help="board")
    s.add_argument(
        "--source", type=Path, help="previous revision directory (default: $MICRAS_PREVIOUS, else ../hw_debug)"
    )
    s.add_argument("--check", action="store_true", help="verify only; fail if board.json is stale")
    s = psub.add_parser("compare", help="new board connectivity vs the previous revision + boards/<board>/changes.toml")
    s.add_argument("board")

    p = sub.add_parser("firmware", help="the firmware's pin map and drive settings as a committed contract")
    fsub = p.add_subparsers(dest="action", required=True)
    s = fsub.add_parser("snapshot", help="write boards/main/firmware.toml from MicrasFirmware")
    s.add_argument(
        "--source", type=Path, help="MicrasFirmware checkout (default: $MICRAS_FIRMWARE, else ../MicrasFirmware)"
    )
    s.add_argument("--check", action="store_true", help="verify only; fail if firmware.toml is stale")

    a = ap.parse_args(argv)
    if a.cmd == "assembly":
        return assembly.run()
    if a.cmd == "parts":
        return jlc.check_parts(a.online)
    if a.cmd == "firmware":
        return firmware.snapshot(a.source, check=a.check)
    if a.cmd == "previous":
        if a.action == "snapshot":
            return previous.snapshot(a.source, a.board, check=a.check)
        return previous.compare(a.board)
    if a.cmd == "quote":
        return order.quote_all(a.boards, a.qty)
    if a.cmd == "sch" and a.info:
        return placement.info(a.boards[0], a.info, a.boards[1:])
    status = 0
    for b in a.boards or boards():
        print(f"== {a.cmd} {b}")
        if a.cmd in LAYOUT_COMMANDS and not has_layout(b):
            print(f"{b}: {a.cmd} skipped: {SCHEMATIC_ONLY}")
            continue
        if a.cmd == "mech":
            status |= mech.run(b, a.check)
        elif a.cmd == "rules":
            status |= checks.rules(b, a.check)
        elif a.cmd == "sch" and a.draft:
            status |= placement.draft(b, a.sheet, a.all)
        elif a.cmd == "sch":
            status |= placement.run(b, a.check)
        elif a.cmd == "erc":
            status |= checks.erc(b)
        elif a.cmd == "lvs":
            status |= lvs.run(b)
        elif a.cmd == "drc":
            status |= checks.drc(b)
        elif a.cmd == "dfm":
            status |= checks.dfm(b)
        elif a.cmd == "fab":
            status |= jlc.fab(b)
        elif a.cmd == "outputs":
            status |= outputs.run(b)
    return status


if __name__ == "__main__":
    sys.exit(main())
