Team-Micras/MicrasPCB/tests/test_layout.py

"""Layout checks on every board: decoupling next to its pin, the encoder joint's slot, fab hygiene.

The placement-dependent checks skip, with the reason, while a board's layout has no outline: until
then the footprints sit where the netlist sync packed them, which says nothing about the design. A
schematic-only board (no layout file, Project(layout = False)) is not listed at all.
"""

import json
import math
import re
import shutil
import tomllib

import pytest
from micras_pcb import jlc, layout, sexpr, spec
from micras_pcb.paths import ROOT, board_pcb, layout_boards, layout_dir

from .conftest import needs_kicad
from .design import design

needs_pcb = pytest.mark.skipif(shutil.which("pcb") is None, reason="pcb not installed")

# Decoupling the datasheets ask to sit at the pin ("as close as possible", "near", "close to"):
# (MPN prefix, pin names, count, capacitance range in F, source). count None: one capacitor per pad
# (the STM32's five VDD pads); a number: that many capacitors at the pin group.
PER_PAD = None
# reach of the capacitors that cannot sit at their pin (mm, pad centre to pad centre; see below)
REACH_C109, REACH_C108 = 15.5, 13.5
REACH_VDDSMPS = 4.6  # mm: the main board's C2 (4.7 uF, the local input capacitor) from VDDSMPS (pin 6)
# C1 (10 uF 0603) cannot sit in the 1.8 mm room between IC1 and the wall joint W3 (spec [ic1] block):
# it stands just past the chip's right vertex, the nearest spot (AN5419 Table 2 asks only "close")
REACH_VDDSMPS_BULK = 5.6  # mm: the main board's C1 from VDDSMPS (pin 6)
REACH_VFBSMPS = 7.5  # mm: the main board's C3/C4 from VFBSMPS (pin 7)
DECOUPLING = [
    (
        "STM32H725",
        ("VDD",),
        PER_PAD,
        (90e-9, 110e-9),
        "AN5419 Rev 3 Table 2 p7: 100 nF per VDD pin, as close as possible",
    ),
    ("STM32H725", ("VDDA",), 1, (90e-9, 110e-9), "AN5419 Table 2 p7: 100 nF as close as possible to VDDA"),
    # The SMPS (Direct SMPS supply): AN5419 asks for its capacitors "close" with no number; the
    # main board's sit where its escape rows leave room (layout README, Open items). The reaches
    # are its own, which may not grow.
    (
        "STM32H725",
        ("VDDSMPS",),
        1,
        (4.2e-6, 5.2e-6),
        "AN5419 Rev 3 Table 2 p8: 10 uF + 4.7 uF on VDDSMPS (best performance)",
        REACH_VDDSMPS,
    ),
    (
        "STM32H725",
        ("VDDSMPS",),
        1,
        (9e-6, 11e-6),
        "AN5419 Rev 3 Table 2 p8: 10 uF + 4.7 uF on VDDSMPS (best performance)",
        REACH_VDDSMPS_BULK,
    ),
    (
        "STM32H725",
        ("VFBSMPS",),
        2,
        (9e-6, 11e-6),
        "AN5419 Rev 3 Table 2 p8: 2 x 10 uF close to the inductor on the VFBSMPS side",
        REACH_VFBSMPS,
    ),
    ("STM32H725", ("VBAT",), 1, (90e-9, 110e-9), "AN5419 Table 2 p7: 100 nF close to the VBAT pin"),
    ("STM32H725", ("VCAP1",), 1, (90e-9, 110e-9), "AN5419 Figure 5 p10: 100 nF close to each VCAP pin"),
    ("STM32H725", ("VCAP2",), 1, (90e-9, 110e-9), "AN5419 Figure 5 p10: 100 nF close to each VCAP pin"),
    ("STM32H725", ("VCAP3",), 1, (90e-9, 110e-9), "AN5419 Figure 5 p10: 100 nF close to each VCAP pin"),
    ("LSM6DSV", ("Vdd",), 1, (90e-9, 110e-9), "DS13476 Rev 5 Table 2 note 1, Figure 27: 100 nF as near as possible"),
    ("LSM6DSV", ("Vdd_IO",), 1, (90e-9, 110e-9), "DS13476 Rev 5 Table 2 note 1, Figure 27: 100 nF as near as possible"),
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
