Team-Micras/MicrasPCB/(commit log)

2026-10-13 ✨ Add the PCB-as-code framework and the encoder board, checked and published by CI
    [encoder.kicad_pcb, encoder.kicad_sch]
2026-10-14 🔥 Check JLCPCB stock with make parts-online before ordering instead of a weekly workflow
2026-10-14 ⬆️ Move CI to Ubuntu 26.04 and the current actions, Zener to 0.4.81 and the tools to Python 3.14, with Dependabot keeping them current and no GitHub Pages deploy
    [encoder.kicad_sch]
2026-10-14 📌 Pin the CI actions to commits, since setup-uv publishes no major-version tags
2026-10-14 🐛 Add the KiCad PPA source and key explicitly, since add-apt-repository added nothing on Ubuntu 26.04 runners
2026-10-14 🔊 Show apt's KiCad candidates in CI
2026-10-14 🐛 Keep the KiCad PPA on the base architecture, since its amd64v3 index on Ubuntu 26.04 lacks KiCad itself
2026-10-14 🔧 Set the KiCad rule severities from rules/kicad-severities.toml, ignoring footprint library links a clean checkout cannot resolve
    [checks.py, cli.py]
2026-10-14 📝 Drop KiHub from the severities note
2026-10-14 🔥 Remove the design webpage, keeping the review outputs and fab package as the CI artifact
2026-10-14 ✨ Add the previous main board snapshot and connectivity comparator
    micras-pcb previous snapshot reads the previous revision (KiCad 10 conversion in hw_debug)
    into boards/main/previous/board.json; micras-pcb previous compare <board> checks the new
    board's connectivity against it plus the changes declared in boards/<board>/changes.toml.
2026-10-14 🔥 Remove docs/, keeping what is still relevant in the README and skills
    The README now explains why the repo uses Zener and KiCad and the toolchain's known limits; the
    new micras-pcb skill gives agents the parts, JLCPCB-output, KiCad-scripting and review-gate
    workflow. pcb.toml no longer needs to exclude docs/.
2026-10-14 🙈 Ignore agent worktrees
2026-10-14 📝 Describe the final state in the docs, without history
2026-10-14 📝 Allow pcbnew in one-off layout scripts
2026-10-14 ✨ Add the L6205D dual full-bridge driver package
2026-10-14 ✨ Add the STSPIN958 brushed DC driver package
2026-10-14 ✨ Add the TSC2020 current-sense amplifier package
2026-10-14 ✨ Add the AO3400A N-MOSFET package
2026-10-14 ✨ Add the main board peripheral and Micras custom part packages
    EncoderSlot (EC) and WallSensor (W) custom parts, WS2815C-2020-4P (D), FUET-5030 buzzer (BZ), DSHP04TJGER DIP switch (SW), GT-TC048B-H025-L1 tactile switch (SW) and 1N4148W (D): Altium MicrasLib footprints with their STEP models, KiCad 10 symbols with pins = pad numbers, datasheet docstrings and test benches.
2026-10-14 ✨ Add the main board power component packages
    L6981 buck, TPS61178 boost, CJA1117B LDO, HSBB3072 MOSFET, MK-12D18-G040 slide switch, the AFE201612S2R2MBT, XAL6030-102 and YSPIA0645-220M inductors, the VT1C221M0605 and JVS25V100M6X4 electrolytic capacitors and the JST B02B-PASK header. Footprints and STEP models come from the MicrasMainBoard Altium library with unchanged pad numbers and geometry; the SOT-89 tab copper carries pad number 2.
2026-10-14 ✨ Add the STM32H725RGV6, LSM6DSV, GT-USB-7010ASV, KASML010, PZ254V-11-04P and test point packages
    Component packages for the main board's MCU, IMU, USB and debug group, with the main board's footprints and embedded STEP models, datasheet-typed symbols and test benches.
2026-10-14 🔧 Let the checks handle a board without spec or with off-board supplies
    ERC accepts power_pin_not_driven only on the nets a board lists in boards/<board>/erc.toml as supplied from off the board, the role a PWR_FLAG has in a hand-drawn schematic (Zener cannot place one). mech skips a board that has no spec/<board>.toml yet. parts --online reports zero stock without failing, since some parts are bought elsewhere. A comparator test pins down that a single-pin net counts as unconnected whatever its name.
    [checks.py, jlc.py, mech.py]
2026-10-14 ✨ Add the main board circuit
    boards/main in Zener: the root sheet with the STM32H725RGV6 and its supply network, and the REGULATORS, DRIVERS, SENSORS and PERIPHERALS sheets. Every part keeps its designator from the MicrasMainBoard Altium design, every passive its value, rating and part number, and every named net its name. The generated KiCad project has the footprints unplaced; the layout transfer places and routes them.
    [main.kicad_pcb, main.kicad_sch]
2026-10-14 🍱 Source the main board parts at JLCPCB
    LCSC numbers from the MicrasMainBoard JLCPCB BOM, basic/extended and stock from the JLCPCB parts search on 2026-10-14. 0402CG180J500NT maps to its own LCSC number C1549 (basic).
2026-10-14 ✅ Gate the main board on its previous revision
    changes.toml declares C1 (MCU VBAT pin and its C8/C9 on 3V3), C2 (VFBSMPS and VCAP1-3 on VCORE) and the test point designators that gain a number. make check runs micras-pcb previous compare main; tests/test_main.py pins the declared changes, the net names and the part numbers.
2026-10-14 📝 Describe the main board
2026-10-14 🔧 Run every gate in make check and report each one
    make check now runs build, warnings, test, layout-check, erc, lvs,
    previous, drc, dfm, pytest, lint and parts even when one fails, then
    prints a pass/FAIL line per gate and fails if any failed. Multi-board
    gates check every board before failing. The new warnings gate fails on
    any pcb build warning (a net outside a part's operating range). make
    help prints target names again.
2026-10-14 ✅ Test the main board's circuit against its datasheets
    Test benches that instantiate the whole board: the MCU supply, boot,
    reset, debug header and USB lines (AN5419, DS13311, AN4879); the buck,
    boost, USB LDO and battery switch with the datasheet equations (DS13554
    Eq. 36-43, SLVSDA7E Eq. 2-5, LM1117, DS14341 dVS/dt); the L6205,
    STSPIN958 and TSC2020 application circuits; the USB-C terminations, SBU
    and ESD; capacitor ratings against net voltages. The encoder board gets
    the generic ones. Correct the L6981 ripple statement in Regulators.zen:
    18 % is below the 20-40 % target, not inside it.
2026-10-14 ✨ Test the main board against the firmware's pin map
    micras-pcb firmware snapshot reads MicrasFirmware (cube/micras_v1.ioc,
    the v1 target and the buzzer driver) and writes boards/main/firmware.toml:
    every assigned pin with its label and function, the supply configuration,
    the battery channel and the drive duties. tests/test_firmware.py checks
    the board against it: every pin wired, net names, each function reaching
    its part, the Direct SMPS wiring, a measurable battery voltage, and the
    emitter and buzzer resistor ratings at the firmware's duties.
    [cli.py, design.py, firmware.py]
2026-10-14 ✅ Test the power tree, the encoder joint and the layout
    One source per supply net and no back-feed through a regulator; the
    encoder slots' pinout against the encoder tab, by signal role; on every
    board: courtyards, paste on SMD pads, embedded 3D models and complete
    JLCPCB part data. Decoupling within 3 mm of its pin and the encoder slot
    fit (JLCPCB 1.0 mm minimum non-plated slot, rounded milling) skip until a
    layout has an outline.
    [layout.py, test_joint.py, test_layout.py]
2026-10-14 🔧 Add JLCPCB's per-object clearances to the DRC rules
    From the JLCPCB capabilities page: SMD pad to pad 0.15 mm, PTH hole to
    track 0.28 mm (0.35 mm preferred), NPTH and via hole to track 0.2 mm,
    inner-layer PTH hole to copper 0.3 mm and via hole to copper 0.2 mm.
2026-10-14 📝 Describe the main board's known faults and the new gates
    boards/main/README.md lists every check the board fails, with the fault,
    the requirement it breaks and a fix that keeps the board's functions,
    the checks that wait for the layout, and the requirements left without
    a check. The README gate table and the micras-pcb skill cover the
    warnings gate, the board test benches and the firmware contract.
2026-10-14 🔧 Keep agent worktrees out of the pcb workspace and the edit hook
    pcb scans every pcb.toml under the workspace, so a git worktree under
    .claude/worktrees (a full checkout with its own [workspace]) broke pcb
    build and pcb bom in the main checkout; the workspace now excludes it.
    The after-edit hook checks the checkout that holds the edited file, so
    an agent in a worktree gets feedback on its own tree.
2026-10-14 ✨ Add the M2 screw holes to the main board
    The previous board's four screw holes were footprints without a designator. They are now
    H1-H4, instances of a new micras/MountingHole package (2.4 mm NPTH, the previous footprint),
    declared in changes.toml as added parts.
    [main.kicad_pcb, main.kicad_sch]
2026-10-14 🚚 Transfer the previous main board's placement, routing and outline
    boards/main/previous/transfer_layout.py copies the previous revision's copper, zones and board
    graphics with each net renamed by pad membership, places every footprint by designator (stdlib
    generic R/C/LED footprints fitted onto the old pads), keeps the old reference text and the aux and
    grid origins, refills the zones and syncs with pcb layout. Teardrop zones become plain zones with
    stable UUIDs: KiCad 10 does not save teardrop UUIDs, so a board with teardrops is never
    byte-stable.
    boards/main/previous/rework.py makes the two copper changes: C1 (IC1 pin 1, C8 and C9 off the
    battery chain, onto 3V3 with a bridge to pin 6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
    [main.kicad_pcb]
2026-10-14 📐 Add the main board's mechanical spec
    spec/main.toml holds the main board's interface in the robot frame: thickness, axle origin,
    extents, M2 holes, encoder slots, USB-C peg holes, fan hole and wheel notches. micras-pcb mech
    main places and locks H1-H4, sets the Altium aux origin, checks every outline feature against
    the transferred Edge.Cuts and exports build/main/main_mech.json; --check fails on drift.
    [main.kicad_pcb]
2026-10-14 📝 Describe the main board layout
    Layers, block placement, the C1/C2 copper, the generic footprints and the teardrop zones; the
    layout gates' failures inherited from the previous layout; the transfer scripts in the repository
    map and the spec's role for an outline that is layout geometry.
2026-10-14 📝 Give every layout check failure of the main board its root cause
    Each DRC and DFM violation type with its count, cause and fix, and the
    two layout tests that run now that the board has an outline.
2026-10-14 🍱 Give the main board packages courtyards, tab paste and edge-clear silkscreen
    Every package from the Altium library gets an F.CrtYd courtyard around its
    body outline and pads (IPC-7351B nominal excess: 0.25 mm, 0.5 mm for
    connectors, 0.15 mm below 0603), replacing the User-layer courtyards, so
    KiCad's overlap check sees them. CJA1117B's tab pad gets its paste opening,
    the WallSensor silkscreen keeps clear of the board edge, the DIP switch
    texts reach the 0.6 mm / 0.08 mm minimums, and the pads that carried a
    -100 mm paste margin (U2, Q6, SW4) take their paste from the drawn
    apertures only, with the same stencil.
2026-10-14 ✨ Add the TPS2121, LM66100, USBLC6-2SC6, AO3401A, 1N4148WS and PZ254V-11-05P packages
    The parts the main board's fixes need: the TPS2121 power mux and the
    LM66100 ideal diode for the supply ORing, the USBLC6-2SC6 ESD array for the
    USB data lines, the AO3401A P-MOSFET for the switched SBU supply, the
    1N4148WS gate clamp of the wall emitters, and the 5-pin header that brings
    NRST to the SWD connector. Footprints from the datasheet land patterns or
    the matching KiCad library footprints, each with a courtyard and its STEP
    embedded (the TPS2121's is a body envelope: no RUX0012A model exists).
2026-10-14 ✨ Compare net names in the previous-revision gate, with declared renames
    `micras-pcb previous compare` now also fails when a net the previous board
    named (not an Altium automatic name) is the same pads under another name,
    unless a change declares it with rename_nets (applied at once, so two nets
    can swap names). Changes can also declare part_numbers (same pads, another
    part) and dnp, which tests/test_main.py checks against the BOM.
2026-10-14 ✨ Declare the firmware changes a board needs before MicrasFirmware has them
    boards/<board>/firmware_changes.toml lists pin, battery, supply or drive
    settings the board needs from the firmware; the firmware tests apply them
    on top of the snapshot, and flag one the snapshot already has.
2026-10-14 🐛 Count the KiCad library's paste-only pads in the paste check
    KiCad library footprints such as D_SOD-882 give each copper pad no paste
    of its own and a separate paste-only pad over it; the check counted only
    drawn paste shapes, so it reported those pads as unpasted.
2026-10-14 🔧 Accept ERC's undriven power pins on nets fed through a passive part
    A net supplied through a ferrite bead or an inductor has no power output
    pin in KiCad's eyes, the case a PWR_FLAG covers in a hand-drawn schematic.
    erc.toml lists such nets in [passive_supply], next to [external_supply].
2026-10-14 📐 Make the encoder slots 1.0 x 5.8 mm milled slots with round ends
    JLCPCB mills non-plated slots no narrower than 1.0 mm and cannot cut square
    corners, so the 0.9 x 5.1 mm rectangles cannot be made, and their milled
    corners would keep the 5.0 mm tab out. The spec now gives a 1.0 mm slot
    with R0.5 ends, 5.8 mm long so the tab's corners (0.8 mm board + 0.1 mm)
    clear the ends with 0.1 mm of outline tolerance; mech checks the straight
    sides and the end arcs and exports the radius. The EncoderSlot pads move
    out to x = +/-1.21 mm, 0.21 mm from the new walls, keeping their pitch, so
    existing encoder boards still mate. The tab-fit test now measures the
    length the round ends leave open (the old 0.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
    [mech.py, test_spec.py]
2026-10-14 🐛 Type the TPS2121's second OUT pin passive
    KiCad's ERC reports two power outputs on one net as a pin conflict; pin 1
    keeps the power output type for the net.
2026-10-14 🐛 Fix the main board's design review findings in the circuit
    Every fix keeps the board's functions, connectors and firmware interface,
    and is declared in boards/main/changes.toml under its review item
    (hw_debug/schematic_review.md):
    - Power tree (C3, C4, C5, M3, m5): the TPS2121 power mux U4 feeds the 3V3
    buck from the battery or USB VBUS (VSYS); the buck is the non-sinking
    L6981C33; the USB LDO U3 is gone; the SWD probe's pin reaches 3V3 through
    the LM66100 ideal diode U5; the boost (now the auto-PFM TPS61178, M15) is
    enabled by Motors_Enable. USB or the probe alone can no longer power VBAT,
    the boost or the fan driver. The review's LM66100 on VSYS is not possible:
    its VIN/V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
    [main.kicad_pcb, main.kicad_sch]
2026-10-14 📝 Describe the main board with the review's findings fixed
    The power tree and its three modes, the firmware changes the board needs,
    the one circuit check that stays failing (SBU supply, M6) and why, and what
    the layout still lacks: placement and routing of the new parts, the encoder
    slot outline, footprint updates, with placement notes.
2026-10-14 ♻️ Update the main board's footprints from their packages
    `pcb layout --sync-footprints` reloads the 42 footprints that differed from
    their packages, keeping position, rotation, nets and routing: the packages'
    courtyards, paste apertures, edge-clear wall sensor silkscreen, SW1 texts and
    the EncoderSlot pads at x = +/-1.21 mm. Clears lib_footprint_mismatch and
    padstack.
    [main.kicad_pcb]
2026-10-14 🐛 Trim the USB-C receptacle's outer ground pads clear of the peg holes
    The A1B12/B1A12 pads of the GT-USB-7010ASV footprint ended 0.175/0.190 mm
    from the NPTH peg holes, under JLCPCB's 0.2 mm hole-to-copper limit. They
    are now 1.19 mm long (0.05 mm shorter at the end facing the holes), which
    leaves 0.22 mm; the paste apertures follow.
2026-10-14 ♻️ Use an 0402 ferrite bead for FB1
    The 0603 GZ1608D601TF found no room in IC1's VDDA feed. The Murata
    BLM15AX601SN1D (LCSC C76886, extended) has the same 600 Ohm at 100 MHz,
    340 mOhm DCR and 500 mA in 0402.
    [main.kicad_sch]
2026-10-14 ✨ Place and route the main board's review fixes
    boards/main/layout/fixes.py is a one-off pcbnew script run on the layout
    as the footprint update left it; router.py is the grid router it uses for
    the connections left over after the hand-placed copper. The layout:
    - Edge.Cuts: the six 1-10 nm outline lines go; both encoder slots are
    1.0 x 5.8 mm with R0.5 ends at the spec's centres.
    - Places the 35 new parts (U4 power mux with R46/C61/C62/C63, U5/C64,
    U6/D8, Q7, R43/C58, R44/R45/C59, R47/R48, R49, C65-C76, D9-D12, FB1)
    and the resized R3/R13/R17/R21/R25 (1206), C56 (0805) and P1 (1x05).
    - Removes the copper the changed nets contradict (U1 pad 11 off VBAT,
    C60/IC6 pad 12 to GND, SBU,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
    [main.kicad_pcb]
2026-10-14 📝 Describe the main board's layout and its remaining faults
2026-10-14 ✨ Snapshot the previous encoder board
    `micras-pcb previous snapshot` takes a board: the encoder's previous
    revision is read from the Altium files in hw_debug/modules/encoder. The
    PcbDoc is converted with `kicad-cli pcb import` on each run, the part
    fields come from the SchDoc's component parameters (read from its
    compound file), and the Altium netlist export must group the pads as the
    PCB does. boards/encoder/previous/board.json holds the result: IC1, C1,
    J1 with their pad nets, 2 layers, 0.79 mm.
2026-10-14 ✨ Add the HM-19, USB-C plug and open pad packages
    Footprints from the Altium MicrasBluetoothModuleLib of the previous Bluetooth module, pad numbers and geometry kept, STEP models embedded with pcb embed-step; KiCad 10 symbols with the datasheet pin types; test benches for the contact tables.
2026-10-14 📸 Snapshot the previous Bluetooth module
    boards/bluetooth/previous/board.json from hw_debug/modules/bluetooth (PcbDoc converted by kicad-cli, SchDoc part fields, extracted netlist as a cross-check). The SchDoc reader now also takes the LCSC library's parameter names (Manufacturer Part, Manufacturer, Supplier Part) and the UTF-8 form of a value; the main and encoder snapshots are unchanged.
2026-10-14 ✨ Add the Bluetooth module board
    boards/bluetooth replicates the MicrasBluetoothModule Altium design part for part, with its designators: HM-19 with its vendor application circuit, the vertical USB-C plug that takes 3V3 from SBU and the UART on D+/D-, the status LED and the key pad. Stackup and design rules from the PcbDoc.
    [bluetooth.kicad_sch]
2026-10-14 🍱 Source the Bluetooth module parts
    R1-R3 and C2 move to JLCPCB basic parts of the same value, package and rating; C1, D1, USB1 keep their LCSC numbers from the SchDoc; the HM-19 maps to JLCPCB's consignment listing.
2026-10-14 🚚 Transfer the previous Bluetooth module's placement, routing and outline
    A pcbnew script converts the PcbDoc with kicad-cli and moves its placement, tracks, vias, zones, outline and silkscreen logo onto the generated layout, in the same KiCad coordinates. Converter UUIDs and item order change on every run, so copied items get content-derived UUIDs and a sorted order; placement runs before the copy, since KiCad gives a loose via the net of a pad it lands on when it loads a board.
    [bluetooth.kicad_pcb]
2026-10-14 📐 Add the Bluetooth module's mechanical spec
    spec/bluetooth.toml: plug-centred board frame, outline extents, plug and HM-19 positions, and the mating with the main board's U2. micras-pcb mech locks the plug, checks the layout-owned outline and exports build/bluetooth/bluetooth_mech.json with the board's place in the robot frame.
2026-10-14 🔧 Compare the Bluetooth module with its previous revision in make check
2026-10-14 ✅ Test the Bluetooth module against its datasheets and the main board
    A pcb test bench for the HM-19 application circuit, the LED current, SBU power and RESETB; pytest for the previous revision, the plug-to-U2 joint in both orientations (UART crossing to the firmware's UART4, supply, ground, PA11 held with the module unplugged) and the mechanics against the main board's layout. The SBU, RESETB, PA11 and courtyard checks fail on the replicated design (review M6, m17).
2026-10-14 📝 Describe the Bluetooth module and its known faults
2026-10-14 ✨ Add the JST SM05B-SRSS-TB package
2026-10-14 ✨ Give the AS5047U and EncoderTab packages the previous encoder board's footprints
    SOP65P640X120-14N (IC1) and ENCODER_CONN (J1) from the Altium EncoderLib, with pad numbers and geometry kept and the library's TSSOP-14 STEP embedded (pcb rectify: OK). The AS5047U package becomes a bare part with reference prefix IC: its 100 nF belongs to the board.
2026-10-14 🚚 Replicate the previous encoder board
    The circuit, designators (IC1, C1, J1) and net names of the Altium
    MicrasEncoder design, with C1 as the equivalent JLCPCB basic part
    (Yageo CC0603KRX7R9BB104 for the Fenghua 0603B104K500NT). The layout
    comes from the PcbDoc through boards/encoder/previous/transfer_layout.py:
    tracks, vias, pours, teardrops (as plain zones), outline, silkscreen and
    logo copied, IC1 and J1 at their previous positions, C1 fitted on the
    previous pads.
    spec/encoder.toml now checks the outline (layout geometry) instead of
    generating it: tab, reliefs, shoulder, tapers (fitted Bezier, 0.021 mm),
    corners and extents; thickness 0.79 mm from the PcbDoc stack; the mech
    JSON expo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
    [encoder.kicad_pcb, encoder.kicad_sch]
2026-10-14 ✅ Test the encoder against its previous revision and the slot joint
    Same connectivity and net names as the previous board, part numbers kept but for the declared C1 swap, the outline checked against the spec and exported from the layout, and the tab pads facing the EncoderSlot pads across the main board's surface.
    [test_encoder.py, test_joint.py, test_spec.py]
2026-10-14 📝 Describe the replicated encoder board
    Circuit, layout, mechanics, the joint, and the root cause of every check the board fails: IC1's courtyard on a user layer, a 1 nm outline line, an SPI_MOSI teardrop sliver and 0.5 mm pin labels.
2026-10-14 🍱 Give the HM-19 and USB-C plug packages courtyards
    F.CrtYd rectangles 0.25 mm around the pads and bodies (the HM-19's antenna
    end included), so KiCad's courtyard checks see the module's two largest
    parts.
2026-10-14 🐛 Identify the Bluetooth module on CC and pull its RESETB up
    M6: the plug's CC1 and CC2 join its D+ contacts. The main board's UART4 TX
    idles high and pulls its CC contacts (5.1 kOhm Rd each) to about 3.2 V
    through them, a level no USB Type-C source makes across a sink's Rd (R2.0
    Tables 4-35, 4-36: 2.18 / 2.04 V max), so the main board can switch 3V3
    onto SBU only for the module and leave SBU open for every USB partner.
    m17: R4 10 kOhm from HM-19 RESETB to 3V3; the CC2640R2F's RESET_N has no
    internal pull-up (SWRS204C Table 7-1).
    The board's minimum silkscreen text height is 0.5 mm, the size of its
    reference designators. The layout gets the packages' new courtyards and R4,
    not yet place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
    [bluetooth.kicad_pcb, bluetooth.kicad_sch]
2026-10-14 ✨ Place and route the Bluetooth module's review fixes
    boards/bluetooth/layout/fixes.py, a one-off pcbnew script:
    - removes the seven 1-12 nm Edge.Cuts lines of the Altium conversion and
    joins their neighbours, so the outline closes (invalid_outline);
    - joins USB1's CC1 and CC2 pads to the adjacent D+ pads (the signature);
    - places R4 between the HM-19 and C2, to C2's 3V3 pad and under the module
    to U1 pad 11 (RESETB), and moves C2's reference beside C2;
    - refills the pours.
    DRC is clean.
    [bluetooth.kicad_pcb]
2026-10-14 ✅ Test the Bluetooth module's signature, VBUS and RESETB pull-up
    Bench: SBU may supply U1 only with the signature (CC1 and CC2 on D+, nothing
    loading it), VBUS stays open, RESETB has one 10-100 kOhm pull-up to VCC.
    pytest: the changes M6 and m17 against the previous revision; the signature
    reaches both of the main board's CC contacts in either orientation, and its
    level at the main board's minimum TX high level stays above the highest CC
    level of a USB Type-C source; the supply check follows the main board's SBU
    through series parts to 3V3; the UART check looks at the data contacts.
2026-10-14 📝 Describe the Bluetooth module's signature and remaining fault
2026-10-14 🍱 Give the AS5047U footprint its courtyard on F.CrtYd and body outline on F.Fab
    The Altium EncoderLib footprint drew the courtyard on User.15 and the
    body outline on User.13 (Altium mechanical layers), so KiCad's
    courtyard checks did not see IC1. Same rectangles, on the KiCad layers;
    the encoder layout takes them with pcb layout --sync-footprints.
    [encoder.kicad_pcb]
2026-10-14 🔧 Set the encoder's silkscreen text minimum to 0.5 mm and test the 0.15 mm stroke
    The pin labels beside the tab are 0.5 mm high with a 0.154 mm stroke,
    the size the previous boards carry and the team reads; the owner takes
    that as the project minimum (JLCPCB recommends 1.0 mm). The board's
    design rules now say so, which clears DRC's eight text_height warnings
    without enlarging the labels. Zener does not set KiCad's minimum text
    thickness, so a pytest checks every visible silkscreen text against
    0.5 mm / 0.15 mm.
2026-10-14 📝 Give the main board's detector thresholds in the Bluetooth module README
2026-10-14 ✨ Pull the AS5047U's SPI inputs on the encoder board
    AS5047U DS v1-00 Figure 4 note 1 forbids a floating digital input, and
    CSn, CLK and MOSI float while the main board's MCU is in reset (its pins
    are in analog mode, RM0468 section 11.3.1). The board now carries the
    pulls of notes 2 and 3, with the part that needs them:
    - R1 10 kOhm, Encoder_CSn to 3V3: the sensor stays deselected.
    - R2 100 kOhm, SPI_SCK to GND, and R3 100 kOhm, SPI_MOSI to GND: the
    lines idle low (SPI mode 1). Both encoder boards and the IMU share
    them, so the two boards' pull-downs act in parallel (50 kOhm, 66 uA
    with a line high); the LSM6DSV adds no pull-up (DS13476 Table 22).
    Uni-Royal 0402 1 % parts, JLCPCB b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
    [encoder.kicad_pcb, encoder.kicad_sch]
2026-10-14 🐛 Fix the encoder layout's DRC findings and place R1-R3
    boards/encoder/layout/fixes.py, a one-off pcbnew script run on the
    previous layout after the netlist sync added R1-R3:
    - Outline: delete the 1 nm Edge.Cuts line the Altium conversion left at
    the top right corner, KiCad (153.3011, 98.953604)-(153.3011,
    98.953605), and start the right side on the corner arc's end
    (invalid_outline). The outline is unchanged; micras-pcb mech still
    matches spec/encoder.toml.
    - Teardrops: delete the second SPI_MOSI teardrop at IC1 pad 4, which
    overlapped the first and left a copper sliver (copper_sliver). Pad 4
    keeps one teardrop, as pads 1-3.
    - Supply: 3V3 runs straight up from its tab pad to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
    [encoder.kicad_pcb]
2026-10-14 📝 Describe the encoder board with its SPI pulls and clean checks
    The board README gives the pulls' datasheet reasons and values, the
    3V3 route and the new parts' placement, the project's 0.5 mm / 0.15 mm
    silkscreen text minimum, the regeneration chain (transfer_layout.py,
    fixes.py) and the remaining open items: mask colour and finish (Zener's
    ENIG/black defaults until confirmed), the paste openings on the edge
    tab, the placement rotations to verify. Its known-faults list is empty;
    the top-level README follows.
2026-10-14 ♻️ Make the SWD connector P1 a JST SH 5-pin side-entry header
    The owner chose a JST SH 1.0 mm connector for P1 instead of the 2.54 mm pin
    header. SM05B-SRSS-TB(LF)(SN) (LCSC C136657), side entry, so the probe cable
    leaves the board sideways at the left edge where the header stood. Same signal
    set and order: 1 SWD_VDD, 2 GND, 3 SWDIO, 4 SWCLK, 5 NRST; the reinforcement
    pads on GND. changes.toml m7 declares the new part and its MP pads.
    [main.kicad_sch]
2026-10-14 🔧 Allow 0.5 mm / 0.15 mm silkscreen text on the main board
    The owner wants the reference designators back on the silkscreen at the size
    of the previous board's (0.5 mm high, 0.154 mm stroke, legible on the
    fabricated board). Zener sets the minimum height; `micras-pcb rules` now also
    writes per-board design-rule constraints Zener cannot set
    ([design.<board>] in rules/kicad-severities.toml), here the 0.15 mm minimum
    stroke. Below JLCPCB's 1.0 mm / 0.153 mm legibility guarantee, as accepted.
2026-10-14 ✨ Apply the owner's layout decisions on the main board
    boards/main/layout/refine.py, a one-off pcbnew script after fixes.py:
    - Courtyards: the five overlaps cleared by moving parts instead of DRC
    exclusions (owner's choice). C36 -0.43 mm x, C37 -0.397 mm x, C23 -0.15,
    R6/R7 -0.12; SW4 +0.09/+0.22 mm, M2 -0.55 mm x, M1 +1.2 mm x (IC5's pad 10
    sits 0.2 mm from the corner arc, so IC5 cannot move); C38 into the corner M1
    frees, beside IC5 pin 14. Motor_R_Sense+/- re-run between C36's pads and
    past M1's pad 2.
    - P1: the JST SH side-entry header on the left edge (mating face 0.4 mm inside
    it, reinforcement pads 0.22 mm from it), M3 1.95 mm inwards to make room;
    the pin header's co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
    [main.kicad_pcb]
2026-10-14 🍱 Draw SW1's "ON" marks with a 0.15 mm stroke
    The DIP switch package's "ON" marks were 0.6 mm / 0.1 mm, under the main
    board's 0.15 mm silkscreen stroke minimum; 0.15 mm is the largest stroke
    KiCad's font draws at 0.6 mm. refine.py carries the same stroke onto the
    placed SW1, so the layout matches the package.
    [main.kicad_pcb]
2026-10-14 📝 Record the encoder's finish, mask colour and pre-tinned tab
2026-10-14 📝 Record the Bluetooth module's finish, mask colour and the PA11 pull-up in firmware
2026-10-14 ✅ Check the encoder tab against both boards' fab tolerances
    The encoder board is now 0.79 mm (its Altium stack), so the fixed play limits
    (0.2 mm across, 0.4 mm along, written for a 0.80 mm board) read 0.21 and
    0.41 mm. The bounds now come from the tolerances instead: the thickest
    encoder board (0.79 + 0.1 mm, JLCPCB below 1.0 mm) must enter the slot milled
    0.1 mm narrow and 0.1 mm short at each end, and the slot is no larger than
    that needs: one 0.1 mm grid step shorter fails, and its 1.0 mm width is
    JLCPCB's minimum non-plated slot. The 1.0 x 5.8 mm slot passes with 0.01 mm
    across and 0.06 mm along at the worst case. EncoderSlot's docs and the spec
    source quote the 0.79 mm board.
    [test_spec.py]
2026-10-14 ✅ Trace the Bluetooth module's SBU supply through the main board's switch
    The main board feeds SBU from 3V3 through the switch Q7 (review M6) and the
    fuse F1, so the mate test follows the sheet's local nets upstream through
    series parts and a transistor's drain to source, instead of one series part.
2026-10-14 ✅ Check every main board silkscreen text against the board's minimum
    Reads the project's min_text_height and min_text_thickness and checks every
    visible silkscreen text, field and footprint text of the layout, with the
    stroke KiCad draws (at most a quarter of the text size).
2026-10-14 📝 Describe the main board after the owner's layout decisions
    The SWD connector's pinout, the courtyard moves with their coordinates for
    MicrasHardware, C15 at IC1 pad 51, the silkscreen text size, and the
    remaining findings: the silkscreen artwork warnings, Wall_Sensor_2's long
    route and U6's branch, with what blocks each.
2026-10-14 ✨ Put the current-sense shunts on the Altium 2512 land pattern
    R31-R33 used KiCad's R_2512_6332Metric (1.225 x 3.35 mm pads, 4.10 mm2)
    where the MicrasMainBoard routed and soldered them on the MicrasLib
    RESC6432X89N land pattern (1.45 x 3.45 mm pads, 5.00 mm2). The R2512
    package is the stdlib resistor on that footprint, with the generic's
    configs, type and properties, its Altium STEP and the Altium courtyard
    on F.CrtYd.
2026-10-14 🍱 Keep the WallSensor silkscreen on the board
    The package drew the sensor body hatch on F.SilkS, which runs up to
    4.1 mm past the main board's edge at W1, W2 and W4. The silkscreen now
    outlines the lead area with the C and E labels beside it, and the body
    stays on User.13, as in main-board-fixes (525ddea), so both branches
    carry the same package.
2026-10-14 🔧 Set the boards up as the Altium designs: mask expansion, FR-4, origin, pour edge
    - Solder mask expansion 0.02 mm on all three boards (Altium rule
    SolderMaskExpansion, 0.7874 mil); the boards had 0.
    - Encoder dielectric: FR-4, Dk 4.5, as in MicrasEncoder.PcbDoc (was the
    stdlib FR4-Core, 4.6).
    - Main board drill and placement origin: the Altium origin (Board6
    ORIGINX/Y, the rear edge centre, KiCad 148.501075, 150.00362), as the
    Altium CAM output uses and as encoder and bluetooth already do. The
    previous value (84.3403, 180.6148) came from the hw_debug conversion,
    not from Altium.
    - Pours keep 0.21 mm from the board edge instead of 0.30 mm: JLCPCB's
    capability page allows 0.2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
2026-10-14 🚚 Transfer the Altium pour, teardrop and outline settings to the layouts
    The transfer scripts now carry what KiCad's Altium importer drops, and
    the layouts are regenerated with them:
    - Teardrops (converted to plain zones) fill with a 0.1 mm minimum width
    instead of the importer's 0.25 mm, which left 652 of 786 (main), 5 of
    25 (encoder) and 10 of 46 (bluetooth) teardrops without copper. 0.1 mm
    is JLCPCB's minimum copper feature: 0.0254 mm fills slightly more but
    fails the DFM feature width on all three boards.
    - Pours use the Altium polygons' neck width as minimum width (0.1 mm;
    0.4 mm on the encoder's bottom pour, which keeps it out of the channels
    between the SPI tracks, 0.3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
    [bluetooth.kicad_pcb, encoder.kicad_pcb, main.kicad_pcb, main.kicad_sch]
2026-10-14 📝 Describe the boards' differences from the Altium designs
    Each board README states its stackup and fab setup, the zone settings
    taken from Altium, a table of what stays different from the Altium board
    and why (pour clearances, generic footprints' pads, paste, mask and
    silkscreen, 3D models, mask thickness), and the known-faults counts after
    the layout changes.
2026-10-14 🐛 Write each schematic afresh in make gen
    pcb apply on an existing schematic only repairs netlist differences and keeps the power
    symbols, labels and wires a pin has left (pcb-kicad-sch DESIGN.md): after Q7's gate left +5V
    and R8/R9 went, ERC reported the stale +5V symbol, its wire and the USBD_P/USBD_N labels as
    dangling. Generation is deterministic, and the committed encoder and Bluetooth schematics are
    byte-identical when written afresh.
2026-10-14 ✨ Power SBU only for the Bluetooth module's CC signature, USB on plain copper
    M6: Q7's gate leaves VBUS. U7 (TLV7041) compares a peak hold of CC1 (R50, D13, C77, R51)
    with two thirds of 3V3 (R52/R53, hysteresis R54) and pulls the gate (R55 to 3V3) low only
    above any level a Type-C source makes across Rd: the module ties its CC contacts to D+, which
    UART4 TX holds high. New packages onsemi/BAT54HT1G and ti/TLV7041; the benches usb_c_sbu_open
    and sbu_signature_detector check the scheme and its thresholds.
    M11: R8/R9 (0 Ohm) and the unfitted C22/C23 go; D+/D- run on plain copper from U2 to PA12/PA11.
    PA11's idle level comes from the firmware's pull-up, not a resistor.
    USBLC6-2SC6: pins 1/6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
    [main.kicad_sch]
2026-10-14 ✅ Declare PA5 analog without pull and PA11's pull-up for the firmware
    C1: PA5 stops being Encoder_Left_ABI_I (S_TIM2_ETR with GPIO_PULLUP in micras_v0.ioc) and
    reads the battery divider, analog with no pull; the battery test fails on a pull on the
    divider's pin. m17: UART4_RX (PA11) with GPIO_PULLUP; the Bluetooth test counts the pulls the
    board declares for the firmware.
2026-10-14 ✨ Lay out U6 in line, the SBU detector and Wall_Sensor_2's short path
    boards/main/layout/usb_wall.py, a one-off pcbnew script after refine.py: U6 at the
    receptacle with D+/D- through its pads (F1 and D8 moved), the SBU feed to F1 by Q7, the
    detector between EC1 and the USB pair, and Wall_Sensor_2 back over IC1's top corner with
    PA5's node stepping under it to the divider.
    [main.kicad_pcb]
2026-10-14 🔧 Give KiCad Prism the boards' names and descriptions
    Prism takes each board's layout folder (the one holding the .kicad_pro)
    as a project and reads an optional .prism.json there. Each board's file
    sets project_name and description.
    It sets no readme: Prism reads a README only from inside the project
    folder. A "../README.md" path resolves in its working-tree view, but its
    commit view (which the project page uses for the selected branch) rejects
    paths that leave the project folder with HTTP 400, and the overview
    request fails with it.
2026-10-14 ♻️ Give the main layout main's pour settings and clear what the 2512 shunts touch
    boards/main/layout/finish.py, one-off after usb_wall.py: the teardrop, pour, inner-plane relief,
    screw-hole void, mask and LED settings that previous/transfer_layout.py gives a fresh transfer
    (the earlier scripts name copper with random UUIDs, so they do not replay on a new transfer);
    C33 above C32, clear of R31's 2512 courtyard; the SBU_DET_A via off R33's pad; C69/C70's 3V3
    from EC1 pin 5, their vias being in H2's plane void; three bumps on D- that match the USB pair;
    and the teardrops a 0.1 mm fill leaves alone or that make copper slivers (found by removing each
    and re-running DRC).
    [main.kicad_pcb]
2026-10-14 📝 Describe the main board's USB-C, SBU detector and finished layout
    The board README gives the USB-C and Bluetooth module section (U6 in line, the signature
    detector and its thresholds), the three firmware changes, the finish (ENIG, black mask, white
    silkscreen), the layout of IC1's top corner, the USB area and the detector, the moved parts for
    MicrasHardware, and the remaining known faults (silkscreen warnings only) and open items.
2026-10-14 ✨ Bypass U6's rail pin with C79 and set the designators to 0.5 mm / 0.125 mm
    USBLC6-2 DocID 11265 Figure 18 puts CBUS = 100 nF on the VBUS pin: C79
    (0402 X7R, CL05B104KB54PNC, basic) on 3V3 above U6, placed and routed by
    boards/main/layout/rail_silk.py, declared under M12.
    The owner chose 0.5 mm high, 0.125 mm stroke silkscreen designators (KiCad's
    stroke clamp at 0.5 mm): rail_silk.py resizes every designator and P1's
    labels and re-places the two whose spot changed; the board minimum stroke is
    0.125 mm.
    [main.kicad_pcb, main.kicad_sch]
2026-10-14 📝 Record the probe's VSYS back-feed and test that it stops at U4
    On the bench the L6981's high-side body diode lifts VSYS to 3V3 less a diode
    drop when the SWD probe alone powers the board. U4 holds OUT Hi-Z with no
    input above UVLO (SLVSEA3F Table 9-3, Figure 9-2, Table 7.5 ILK), so VBAT
    and +5V stay off. The README records it as known and accepted, with the
    load on the probe and the L6981's out-of-datasheet state as a bench item;
    test_debug_supply_back_feed_stops_at_the_mux walks every conducting path
    from the debug supplies.
2026-10-14 💄 Set the Bluetooth module's designators to 0.5 mm / 0.125 mm
    The owner's choice for every board: fixes.py sets each reference designator
    to 0.5 mm high with a 0.125 mm stroke (the layout rebuilt by the transfer
    script, the footprint sync and fixes.py; R4's footprint graphics take new
    UUIDs), the board's minimum stroke is 0.125 mm ([design.bluetooth]) and the
    silkscreen test covers the module. The README's known faults now list only
    the copper sliver warning.
    [bluetooth.kicad_pcb]
2026-10-14 💄 Set the encoder's silkscreen texts to 0.5 mm / 0.125 mm
    The owner's choice for every board: fixes.py sets the pin labels and the
    IC1, C1 and J1 designators to 0.5 mm high with a 0.125 mm stroke (the chain
    transfer_layout.py, make gen, fixes.py, make gen rebuilds the layout byte
    for byte), the board's minimum stroke is 0.125 mm ([design.encoder]) and the
    encoder's silkscreen test checks against it.
    [encoder.kicad_pcb]
2026-10-14 🚚 Move the board READMEs into their KiCad project folders
    KiCad Prism takes boards/<board>/layout/ as each board's project and shows a README only from that folder, so each board README moves there, its links rewritten. The layout/.prism.json files are dropped. README.md also records the main board's flat-schematic limit (diodeinc/pcb#1520).
2026-10-14 🐛 Name schematic nets without KiCad's sheet path
    KiCad prefixes a net named by a sheet-local label with its sheet path: "/" on the root sheet, "/REGULATORS/" on a module sheet. The tools dropped only the leading "/", so on a hierarchical schematic the previous-revision gate saw REGULATORS.MUX_SS as REGULATORS/REGULATORS.MUX_SS. The netlist reader now keeps the design's name, what follows the last "/" (KiCad writes a "/" inside a name as {slash}), and fails if two sheets' local nets would share it.
    [netlist.py, test_netlist.py]
2026-10-14 🐛 Accept erc.toml supplies on power symbols of every schematic sheet
    The ERC acceptance of boards/<board>/erc.toml nets read the power symbols of the root sheet only, so an undriven power input on a module sheet's VBAT or GND symbol failed ERC. It now follows the sheet files from the root and reads every sheet, with each instance's reference.
    [checks.py, test_checks.py]
2026-10-14 ✨ Give each main-board module its own schematic sheet
    Regulators, Drivers, Sensors and Peripherals declare Project(path="layout", layout=False), so pcb apply writes them as sheets of layout/main.kicad_sch (REGULATORS, DRIVERS, SENSORS, PERIPHERALS.kicad_sch) and the layout stays the board's: main.kicad_pcb is byte-identical. Every sheet's symbols fit its page (A1 root and SENSORS, A2 the others), where the flat sheet spanned 2627 x 1063 mm.
    make gen deletes every .kicad_sch of a layout before pcb apply: pcb refuses to write a new root over existing module sheets, and a regenerated sheet must not keep labels from an older generator.
    ERC fails on the sheets (diodeinc/pcb#1520) until a pcb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
    [DRIVERS.kicad_sch, PERIPHERALS.kicad_sch, REGULATORS.kicad_sch, SENSORS.kicad_sch, main.kicad_sch]
2026-10-14 📝 Record the main board's module sheets and the ERC labels they wait on
2026-10-15 ✅ Check that every track runs at a multiple of 45°
    tests/test_layout.py: test_tracks_are_octilinear_without_acute_corners
    fails on arc tracks, on a segment whose end lies more than 1 um off the
    nearest 45-degree line, and on two segments of a net joined end to end
    at an interior angle below 90 degrees outside a pad or via (acid trap).
    layout.Board now reads tracks and vias. The main and encoder boards'
    offenders are listed in their known faults.
    [layout.py, test_layout.py]
2026-10-15 🍱 Bare the wall sensor: SFH 4550 and TPS601A without the casing
    The embedded STEP keeps its name and frame but holds only the two devices at
    nominal size (MicrasHardware micras/leds.py sensor_model(), from the datasheet
    outlines), without CasingStacked; its TPS601A is a TO-18 can with the leads
    formed 2 mm behind the body. The footprint draws the bodies on User.13, outlines
    them on the silkscreen and adds an F.CrtYd courtyard (bodies at their largest
    and the pads, 0.25 mm excess).
2026-10-15 🚧 Draft the script that puts W1-W4 fully on the main board
    Not run yet: --study prints each sensor's courtyard margin to the edge, the
    least move for the chosen option, what it overlaps and the beams; the apply
    path stops without saving until NEIGHBOURS re-places the overlapped parts.
2026-10-15 📝 Add the next main-board revision research
    Design proposal for the next main board (4S, DCX 10 L, DRV8874, INA241, ESP32-S3, battery-side analog LDO), the owner's five questions, bench plan and the calculation scripts. Research only: no board changes.
2026-10-15 📝 Compare the ESP32 form factors for the next revision
    Module, SiP and chip-down options for the ESP32-S3 (and the C5 alternative) with sizes, support parts, certificates and JLCPCB stock; placement on the main board against the MicrasHardware chassis, with a plot script. Recommends the S3-MINI-1-N8 in the rear-left corner with its antenna beyond the rear edge.
2026-10-15 🎨 Route the main board's fix tracks at 45°
    router.py searches over (layer, cell, direction) with 45/90 degree bend costs, a minimum run after each turn and no acute corners, enters pads along their axes and fits the route's ends onto the anchors by changing run lengths only, so every track it draws runs at 0, 45 or 90 degrees. octilinear.py redraws the 279 off-angle segments the earlier scripts left (snap, slide, rip-up and reroute between the same copper, doglegs) and squares Wall_Sensor_0's acute fork: 0 off-45 segments, 0 arcs, 0 acute corners, DRC and LVS unchanged.
    [main.kicad_pcb]
2026-10-15 ✨ Add the INA241, INA228 and the four-terminal shunts
    Components for the next main-board revision's current sensing
    (research/next-revision, Current sensing and appendix A.3):
    - ti/INA241A2: INA241A2IDGKR, VSSOP-8 on TI's DGK0008A land pattern;
    build checks for the -5..110 V common mode and REF1/REF2 within 0..VS.
    - ti/INA228: INA228AIDGSR (the only commercial orderable), VSSOP-10 on
    TI's DGS0010A land pattern; build checks for IN+/IN- and VBUS ranges.
    - vishay/WSK2512-HIGH: 5 mOhm-0.2 Ohm Kelvin shunt (WSK2512R0100FEA
    default, R0100DEA, 5L000FEA) on Vishay's land pattern for that band.
    - vishay/WSK2512-MID: 1-4.9 mOhm band (WSK25122L000FEA, 2 mOhm), whose
    land pattern differs (a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
2026-10-15 ✨ Add the analog LDO, power-path diode, emitter op-amp and 3.3 V status LED
    Components for the next main-board revision (research/next-revision):
    - adi/ADP7142: ADP7142ACPZN3.3-R7, 40 V low-noise LDO, fixed 3.3 V, 6-lead
    LFCSP CP-6-3 (Rev. H), with a bench for the capacitors, EN levels, SS and
    junction temperature.
    - cj/B5819W: 40 V 1 A Schottky (JCET, SOD-123) for the VBAT -> VSYS OR-ing.
    - ti/TLV9001: TLV9001IDBVR, 1 MHz 2 V/us RRIO op amp at 60 uA, the IR
    emitter current-sink amplifier; the README compares it with the TLV9061,
    OPA376, MCP6001, LMV321 and OPA313.
    - worldsemi/WS2812C-2020: WS2812C-2020-V6, 3.3-5.3 V addressable RGB LED.
    The VBUS leg reuses components/aos/AO3401A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
2026-10-15 ✨ Add the DRV8874 and the motor and fan chokes
    DRV8874PWPR (TI SLVSF66A): symbol, PWP0016J footprint from TI's land pattern
    with the thermal-via grid as a layout guide, embedded STEP, and checks.zen:
    the board-side datasheet rules as a reusable test-bench check, exercised on a
    Figure 19 fixture with each legal strap and one broken rule per case.
    Coilcraft XAL7070-473MEC (47 uH, Isat 4.2 A, 97 mOhm max) for the wheel
    motors and XGL5030-472MEC (4.7 uH, Isat 6.7 A at 30 %, 24.5 mOhm max) for the
    fan, with the candidate comparison and the 0 Ohm option in their READMEs.
2026-10-15 🔧 Use the top-entry JST BM05B-SRSS-TB for the SWD connector P1
    The previous revision had an upright 2.54 mm header at this spot, so an upright plug fits the chassis; the side-entry SM05B-SRSS-TB was never needed. New package components/jst/BM05B-SRSS-TB (KiCad library footprint checked against the JST SH catalogue's top-entry land pattern, STEP embedded, test bench), LCSC C160391; the SM05B-SRSS-TB package goes. swd_top.py places P1 where the side-entry header was, contacts inwards, and routes its five nets at 45 degrees.
    [main.kicad_pcb, main.kicad_sch]
2026-10-15 🎨 Square the encoder's 3V3 fork at IC1
    The previous revision's 3V3 trunk forked into two branches leaving in the same direction, a 45 degree wedge away from any pad. fork.py makes the branch to IC1 pin 11 leave the vertical of the branch to pin 12 at 90 degrees; same copper otherwise. Every board now passes test_tracks_are_octilinear_without_acute_corners.
    [encoder.kicad_pcb]
2026-10-15 ✨ Add the ESP32-S3-MINI-1 module
    The ESP32-S3-MINI-1-N8 radio and debug-probe module of the next main board: the KiCad 10
    RF_Module symbol, Espressif's footprint (checked against the datasheet's Figure 11-1 land pattern,
    antenna keep-out on every copper layer) with Espressif's STEP embedded, a docstring citing the
    module datasheet v1.7 (supply, TX peaks, strapping pins, EN delay, USB pins), a test bench and
    its JLCPCB entry.
2026-10-15 🔧 Let the tooling handle a schematic-only board
    A board whose root declares Project(layout = False) has no .kicad_pcb: `micras-pcb lvs/drc/dfm`
    skip it with that reason, `rules` writes only the ERC severities into its project (no DRC rules
    copy), `outputs` exports its schematic alone, `fab` its BOM alone, and the layout tests list only
    the boards with a layout.
    [checks.py, cli.py, jlc.py, outputs.py, paths.py, test_layout.py]
2026-10-15 ✨ Add the main2 board schematic
    The main board's second revision from research/next-revision, entered in Zener as a new,
    schematic-only board (boards/main stays the current board with its layout):
    - REGULATORS: the 4S battery input with Q6/SW4 kept, an INA228 on a 2 mOhm WSK2512 shunt for the
    ESP32, the 100k/20k battery divider, the VSYS power path (B5819W from VBAT, AO3401A from VBUS
    with its gate on VBAT), the L6981C33 3V3_D buck, the ADP7142 3V3_A LDO behind 22 Ohm + 10 uF
    with EN on 3V3_D.
    - DRIVERS: two DRV8874 in PH/EN with IMODE on GND, ITRIP 2.97 A, nSLEEP on Motors_Enable,
    nFAULT wire-ORed on PC15, 10 mOhm 4-terminal shunts and 47 uH chokes with DNP 0 Ohm
    alternatives;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
    [main2.kicad_sch]
2026-10-15 📝 Document the main2 board
    The root README lists main2 and how the gates treat a schematic-only board; the next-revision
    research points at the board and records the parts it settled (chokes, battery shunt, emitter
    op-amp, power-path diode, ESP EN RC); the micras-pcb skill covers per-board firmware changes and
    schematic-only boards.
2026-10-15 📝 Note that the main2 schematic shares the flat-sheet page limit
2026-10-16 🍱 Give the wall sensor's courtyard and silkscreen the LED's cathode flat
    The SFH 4550 flange is cut flat on its cathode side (pad 2/4), flush with the
    body, so the courtyard there follows the body (2.8 mm from the axis) rather than
    the round flange (3.2 mm).
2026-10-16 🏷️ Name the main board's module ports after their nets
    A sheet pin and its hierarchical label take the module's port name and the root's label the net
    name; KiCad's ERC flagged the 33 nets whose two names differed only in case (similar_labels).
    GND_BAT becomes a ground port of REGULATORS, so the root shows a power symbol at its sheet pin
    instead of a label nothing else joined (label_dangling).
    [DRIVERS.kicad_sch, PERIPHERALS.kicad_sch, REGULATORS.kicad_sch, SENSORS.kicad_sch, main.kicad_sch]
2026-10-16 🚨 Accept the ERC warnings pcb 0.4.81 leaves on module sheets
    boards/<board>/erc.toml [accepted_warning] names the KiCad ERC rules a board accepts at warning
    severity, each with its reason. The main board accepts same_local_global_label and
    multiple_net_names, from the global labels pcb 0.4.81 adds beside each sheet pin
    (diodeinc/pcb#1520) until a release includes diodeinc/pcb#1522. GND_BAT joins the nets supplied
    from off the board.
2026-10-16 ✅ Check that every schematic item lies on its sheet's page
2026-10-16 ✅ Check that each label's text stays on its sheet's page
2026-10-16 ✨ Give each main2 module its own schematic sheet
    As on the main board: each module declares Project(..., layout=False), its signal ports take the
    names of the nets they carry, GND_BAT is a ground port of REGULATORS, and erc.toml accepts the
    two ERC warnings pcb 0.4.81's labels leave (diodeinc/pcb#1520). The netlist is unchanged (174
    nets, same connectivity). The root's SENSORS pin labels run past the page's left edge until a pcb
    release includes diodeinc/pcb#1522; tests/test_schematic.py expects it.
    [DRIVERS.kicad_sch, ESP.kicad_sch, PERIPHERALS.kicad_sch, REGULATORS.kicad_sch, SENSORS.kicad_sch, main2.kicad_sch]
2026-10-16 ✨ Give each main-board module its own schematic sheet
    Regulators, Drivers, Sensors and Peripherals declare Project(path="layout", layout=False), so pcb apply writes them as sheets of layout/main.kicad_sch (REGULATORS, DRIVERS, SENSORS, PERIPHERALS.kicad_sch) and the layout stays the board's: main.kicad_pcb is byte-identical.
    ERC fails on the sheets until the ports take their nets' names (next commit) and the warnings pcb 0.4.81 leaves on module sheets are accepted (diodeinc/pcb#1520).
    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
    [DRIVERS.kicad_sch, PERIPHERALS.kicad_sch, REGULATORS.kicad_sch, SENSORS.kicad_sch, main.kicad_sch]
2026-10-17 🏷️ Name the main board's module ports after their nets
    A module's signal port now takes the name of the board net it carries (Fan_Enable, Wall_Sensor_0, Button), so its sheet pin and hierarchical label match the root's label: KiCad's ERC flagged each pair as similar_labels, names that differ only in case. The SPI buses and the Motor_*_Sense+/- nets, whose names are not identifiers, keep their port names. GND_BAT becomes a ground port of REGULATORS, so it reaches the root as a power symbol at the sheet pin instead of a dangling label. The netlist is unchanged: same nets, same names.
    [DRIVERS.kicad_sch, PERIPHERALS.kicad_sch, REGULATORS.kicad_sch, SENSORS.kicad_sch, main.kicad_sch]
2026-10-17 🚨 Accept the ERC warnings pcb 0.4.81 leaves on module sheets
    boards/<board>/erc.toml gains an [accepted_warning] table, rule by rule with the reason; `micras-pcb erc` accepts a violation of a listed rule only at warning severity and prints one line per rule. The main board accepts same_local_global_label and multiple_net_names, both from the global label pcb 0.4.81 puts beside each sheet pin and hierarchical label (diodeinc/pcb#1520); they go away with a pcb release that includes diodeinc/pcb#1522. GND_BAT, the battery's minus on J1, joins the off-board supplies now that it is a power net on two sheets.
2026-10-17 ✅ Check that every schematic item and label text lies on its sheet's page
    tests/test_schematic.py checks each sheet of every board's schematic: its symbols (body, pins and visible fields, rotated and mirrored as KiCad places them), labels with their text, wires and sheet symbols lie inside the sheet's paper, so the exported PDF and KiCad Prism show the whole circuit. pcb apply grows a sheet's paper only up to A0 and places what does not fit past the page with a warning; the main board's flat sheet had 970 items off its page.
    [test_schematic.py]
2026-10-17 📝 Record the main board's module sheets and the ERC warnings they leave
2026-10-17 🐛 Keep main2's root labels on the page
    SENSORS took three Spi ports, one per device, so the shared SCK, MISO and MOSI came in three times: 32 sheet pins. pcb 0.4.81 places the root's sheet symbols one by one in the order of their names, each as near the page centre as the earlier ones leave room and by its box alone, and a 32-pin SENSORS fitted only against the page's left edge, where the labels at its pins ran up to 11 mm past the page.
    SENSORS now takes the bus once (SPI_SCK, SPI_MISO, SPI_MOSI) and each device's chip select (IMU_SPI_CSn, Encoder_Right_CSn, Encoder_Left_CSn), and builds the three Spi interfaces inside. With 26 pins it sits right of ESP, and every label is on its page,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
    [SENSORS.kicad_sch, main2.kicad_sch]
2026-10-17 ⚡️ Speed up the layout router and route to the cheapest path
    router.py keeps its API and its rules (octilinear, no acute corner, MINRUN, pad axes, the 0.12 mm
    clearance) and gets faster and better:
    - the A* heuristic never overestimates (octile distance plus a bend where a state cannot run
    straight into the target; after GEO_AFTER states, the least cost around the obstacles with the
    vias between layers), so a route is the cheapest one; the old 4-neighbour distance overestimated
    diagonals;
    - free regions that cannot reach the target are never entered, and a search whose source lies in
    none stops at once (the old search exhausted its window, up to 84 s each);
    - rasters cover each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
    [test_router.py]
2026-10-17 ✨ Place the schematics from per-sheet placement files
    micras-pcb sch redraws each sheet pcb apply writes from
    boards/<board>/schematic/<sheet>.toml: parts, wires, labels, power
    symbols, titled frames, paper and title block, the root's sheet
    symbols, and a ports column for the module sheets' extra labels. It
    fails unless KiCad's netlist of the placed schematic equals pcb's.
    make gen runs it after pcb apply; make check's sch gate fails on a part
    without a placement, and tests/test_placement.py on any overlap.
    The encoder and Bluetooth sheets are placed; the main board's DRIVERS
    sheet is drafted.
    [DRIVERS.kicad_sch, bluetooth.kicad_sch, encoder.kicad_sch]
2026-10-17 ✨ Place and route the bare wall sensors fully on the main board
    wall_inside.py moves W1/W4 3.3 mm inwards and 0.45 mm back, W2 0.03 mm
    sideways, re-places each channel's parts around its sensor and routes what
    the moves cut with router.py (octilinear, the board's clearances).
2026-10-17 🎨 Draw the main board's DRIVERS sheet from its placement, and refine labels and fields
    Labels of a wired net sit one grid step along the wire, clear of the pin
    number; junction dots mark only wires and pins; fields clear pin names
    drawn past a small body; the overlap check sizes labels as KiCad draws
    them.
    [DRIVERS.kicad_sch, bluetooth.kicad_sch, encoder.kicad_sch]
2026-10-17 🐛 Share one connection among stacked pins, and skip placement entries the sheet no longer has
    Pins stacked on one point (a part's ground pads) all count as wired by a
    wire that reaches the point, and an unwired stack gets one label or power
    symbol. A placement entry for a part or pin the sheet no longer has is
    reported and skipped, so make gen still places the rest; make check's
    sch gate names it.
    [placement.py]
2026-10-17 ✅ Name the placement entries for pins a sheet no longer has
    [placement.py]
2026-10-17 🎨 Hang the fan driver's slew-rate resistor below its pin
    [DRIVERS.kicad_sch]
2026-10-17 🚸 Put the bare wall sensors fully on the main board
    Ran boards/main/layout/wall_inside.py: W1/W4 3.3 mm inwards and 0.45 mm back
    (robot (36.270, +/-18.200)), W2 0.03 mm sideways, each channel's parts around its
    sensor, the cut connections routed again at 0/45/90 degrees. Every gate passes.
    [main.kicad_pcb]
2026-10-17 📝 List swd_top.py and wall_inside.py among the main layout scripts
2026-10-17 🎨 Place main2's REGULATORS sheet
    [REGULATORS.kicad_sch]
2026-10-17 🎨 Place the main board's REGULATORS sheet
    [REGULATORS.kicad_sch]
2026-10-17 🎨 Hide the B02B-PASK connector's pin names, and let stubs name a pin by its name
    [DRIVERS.kicad_sch, REGULATORS.kicad_sch]
2026-10-17 🐛 Let a sheet pin's name sit inside its own sheet box in the overlap check
2026-10-17 🎨 Place the main board's SENSORS sheet, and size the ports column for global labels' flags
    [DRIVERS.kicad_sch, REGULATORS.kicad_sch, SENSORS.kicad_sch]
2026-10-17 🎨 Place main2's SENSORS sheet, and draw the TLV9001's inputs as + and − in its triangle
    [DRIVERS.kicad_sch, ESP.kicad_sch, REGULATORS.kicad_sch, SENSORS.kicad_sch]
2026-10-17 📝 Note where a wired net's label goes
2026-10-17 ✨ Leave blank slots between a sheet symbol's pin groups
2026-10-17 🎨 Place main2's root sheet: the MCU with its supply domains, and the module sheets
    [main2.kicad_sch]
2026-10-17 🎨 Place the main board's root sheet: the MCU with its Direct SMPS supply, debug, test pads and the module sheets
    [main.kicad_sch]
2026-10-17 🐛 Keep the overlap check's line list when it measures a note
2026-10-17 🎨 Place the main board's PERIPHERALS sheet; widen the USBLC6 symbol and draw the TLV7041's inputs as + and −
    A wired pin of a jumper pin group (the USBLC6's second I/O pads) takes
    the labels of its partners, so a wire from it carries the net's name.
    [PERIPHERALS.kicad_sch]
2026-10-17 🚨 Name the loop variable apart from its iterable
2026-10-17 📝 Name each board's schematic placement in its README
2026-10-17 🎨 Place main2's DRIVERS and PERIPHERALS sheets
2026-10-17 🍱 Regenerate main2's DRIVERS and PERIPHERALS sheets with the widened USBLC6 and the jumper pin labels
    [DRIVERS.kicad_sch, PERIPHERALS.kicad_sch]
2026-10-17 📝 Name main2's schematic placement in its README
2026-10-17 🥅 Report a sheet symbol too small for its pins, and pins it lists that it no longer has, as left-out placement
    [placement.py]
2026-10-17 ✨ Place the schematics from per-sheet placement files: the tool's fixes, the B02B pin names, docs, and the encoder, Bluetooth and DRIVERS placements for this revision
    [DRIVERS.kicad_sch, REGULATORS.kicad_sch, bluetooth.kicad_sch, encoder.kicad_sch]
2026-10-17 🎨 Place this revision's root, REGULATORS and SENSORS sheets; give the CJA1117B room for its pin names
    [DRIVERS.kicad_sch, PERIPHERALS.kicad_sch, REGULATORS.kicad_sch, SENSORS.kicad_sch, main.kicad_sch]
2026-10-17 🎨 Place this revision's PERIPHERALS sheet
    [PERIPHERALS.kicad_sch]
2026-10-17 🔧 Name each board's root schematic and board for KiCad Prism
    Without a .prism.json, a Prism project registered without its .kicad_pro takes the
    first *.kicad_sch in the folder as the root; main's DRIVERS.kicad_sch sorts first,
    so its sheet dropped out of the viewer.
2026-10-17 🔧 Name main2's root schematic for KiCad Prism
2026-10-17 ✨ Draft schematic placement for parts without a hand entry
    micras-pcb sch drafts what a sheet's placement file leaves out (tools/micras_pcb/autoplace.py):
    blocks by connectivity, each part beside a pin of its net and wired to it, decoupling in rows on
    the supply, labels on short stubs, repeated blocks alike, frames packed on the smallest paper.
    sch --draft writes the drafts into the placement files (auto = true), --draft --all drafts whole
    sheets into build/<board>/sch-draft for comparison, and sch --check verifies the placed sheets
    are clean and current instead of failing on parts without an entry.
    [autoplace.py, cli.py, placement.py]
2026-10-17 ✅ Test the placement rules of the drafts and draft every board whole
    Unit tests on synthetic sheets for each rule (decoupling at the supply pin, pulls at their pins,
    series parts lying down, supplies up and grounds down, blocks by connectivity and source order,
    repeated blocks alike, signal flow, sheet pin order, paper, hints, hand entries kept), and a
    test that drafts every sheet of every board from its Zener source alone with pcb's netlist and
    no overlaps. Drafts also wire a part's pins that face placed pins of their net in line, keep
    pin labels clear of wires, and give the ports column the labels of wired nets.
2026-10-17 💡 Title the wall-sensor channels for the schematic drafts
    A SCHEMATIC_HINTS dict in Sensors.zen names each channel's block. pcb evaluates the value and
    ignores it: build, warnings, style lints, BOM, tests, the schematic pcb writes, the layout and
    the netlist are unchanged.
2026-10-17 📝 Document schematic drafts and hints
2026-10-17 🎨 Keep drafted labels a word apart and give stuck labels longer stubs
    A label with no room beside its neighbours steps sideways further or runs out on a long stub
    before it may overlap; two texts on one line keep a word space between them. Drafting the
    previous revision's DRIVERS sheet on main no longer overlaps.
    [autoplace.py]
2026-10-17 ✨ Add the SK-12D29-G060 slide switch, rated DC 24 V
2026-10-17 🔧 Switch main2's battery on the SK-12D29-G060, rated for the 4S pack
    [REGULATORS.kicad_sch]
2026-10-17 ⚡️ Replace main2's bridge electrolytics with 1210 ceramics, and study VBAT bulk and overvoltage
    [DRIVERS.kicad_sch]
2026-10-17 ✨ Add the Littelfuse SMAJ18A TVS diode
2026-10-17 🛡️ Clamp main2's battery input with an SMAJ18A across J1
    [REGULATORS.kicad_sch]
2026-10-17 ✨ Set main2's emitter current from the DAC and AC-couple its selectors
    - The shared sink's set-point comes from PA5 (DAC1_OUT2, buffer off) through
    200k/20k, ratiometric to VDDA and 0 V at reset; 1k/1 nF compensates the loop
    into Q9 and 200k from 3V3_A turns the sink off at a zero set-point.
    - Q2-Q5 keep the main board's AC-coupled gates (220 nF, 22k, 1N4148WS clamp):
    a pin held high turns its emitter off within 11 ms.
    - Battery_Voltage moves to PC5, Switch_0 to PH0; the H7's VBUS divider goes,
    the ESP32 reports USB power over UART4.
    - A test bench checks the selector coupling and the DAC set-point; the
    research model is calculations/emitter/emitter_sink.py.
    [PERIPHERALS.kicad_sch, SENSORS.kicad_sch, main2.kicad_sch]
2026-10-21 📌 Pin Freerouting 2.4.1 for main2's routing
2026-10-21 🚧 Place and route main2 but for 12 connections
    place.py places every part and route.py pours the planes and routes the board, with hand-routed
    fixes on top. 12 connections are still open (boards/main2/layout/README.md, Layout), so DRC and
    the layout check fail on them; every other gate passes.
    [DRIVERS.kicad_sch, ESP.kicad_sch, PERIPHERALS.kicad_sch, main2.kicad_pcb, main2.kicad_sch]
2026-10-22 ✨ Route main2 completely and fuse its battery input
    - Every connection routed: short In2.Cu hops for digital STM32/ESP32 lines (never under
    switching or analog B.Cu copper, off the VBAT pour, out of the STM32 islands, In2 ground
    kept one plane), checked by a new layout test; F.Cu/B.Cu ground pours, ground stitching
    vias and teardrops.
    - ADC pins swapped for the routing: Current_Sensor_Left on PB1 (fast channel), Wall_Sensor_0
    on PA4, Wall_Sensor_3 on PC0; firmware changes updated.
    - Battery fuse F1 (Littelfuse 0501020.WR1, 20 A, 150 A at 32 VDC) from J1 to VBAT, the TVS and
    the switch drive behind it; the INA228 battery monitor and its shunt removed.
    - route.py's DRC refills zone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
    [ESP.kicad_sch, REGULATORS.kicad_sch, main2.kicad_pcb, main2.kicad_sch]
2026-10-26 🐛 Fix main2's review findings and settle its open doubts
    Schematic and parts:
    - Battery input: F1 is a 12 A Littelfuse 501 (0501012.WR1). C58 now sits
    gate-source with C114 gate-drain, so Q6 stays off at plug-in. D16 clamps
    Q8's VGS. R44/R45 are 10k/2k, so VBAT can't float up on USB alone.
    - Capacitors: VBAT and VSYS use 1210/0805 50 V parts, sized with Samsung's
    DC-bias curves. C109 is fitted.
    - Drivers: R66/R76 are removed (the chokes are needed). ITRIP and the fan
    limit are retuned. The INA241 R_iso is 150 Ohm.
    - Rails are declared as ranges, and the abs-max checks run under the TVS
    clamp.
    - STM32 pin swaps for routing: the wall selectors move to TIM3,
    Motor_Left_EN to TIM8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
    [DRIVERS.kicad_sch, ESP.kicad_sch, PERIPHERALS.kicad_sch, REGULATORS.kicad_sch, SENSORS.kicad_sch, main.kicad_pcb, main2.kicad_pcb, main2.kicad_sch]
2026-10-26 🎨 Draw D16 as a Zener and take the choke losses from Coilcraft
    - D16 (BZT52C10S): replace the generic box symbol with a Zener (cathode bar
    to VSYS) and regenerate the REGULATORS sheet.
    - Wheel and fan chokes: Coilcraft's Power Inductor tool gives 330 mW / 49 C
    for the XAL7070-473 at 1.0 A with 1.1 A pp at 100 kHz, and 673 mW / 57 C
    for the XGL5030-472. The model bounds stay as the conservative check.
    - Add drivetrain/choke_spice_loss.py, the Document 267 SPICE model
    cross-check.
    [REGULATORS.kicad_sch]
2026-10-26 🎨 Draw the diodes and buzzer as symbols, and make D4 blue
    - 1N4148WS, B5819W and FUET-5030: replace the box bodies with diode,
    Schottky and buzzer symbols (same pins). Nudge D3 and BZ1 on both boards'
    PERIPHERALS sheets.
    - D4: KENTO KT-0603B blue (C2288, VF 2.6-3.1 V at 5 mA) instead of the
    yellow NCD0603Y2. R4 goes from 680 Ohm to 100 Ohm: 1.2 mA at the worst
    bin and rail, 7.5 mA at most. LED_YELLOW_A is renamed LED_BLUE_A.
    [PERIPHERALS.kicad_sch, REGULATORS.kicad_sch, SENSORS.kicad_sch, main2.kicad_pcb]
2026-11-01 🚧 Swap main2's USB and ESP32-S3 for an ESP32-C5 and programming headers
    Schematic and component checkpoint; the layout follows in its own commit.
    - Remove USB-C, its ESD, power path and VBUS sense; both MCUs flash over
    the air.
    - U13 ESP32-C5-MINI-1-N4 (dual-band, 5 GHz channels 36-48) in the
    rear-right corner, with its antenna notch on the right edge. SW4 and its
    notch move to the rear-left.
    - H7-C5 link: SPI2 half-duplex 3-wire (PA12 SCK, PA11 CSn, PB14 DATA with
    IOSWP), PA9 flow control, UART4 fallback on the same pins. Fan_Enable
    moves to PB10, IMU INT1 to PB6, INT2 is left open.
    - J2: 2x3 1.27 mm header in the ESP-Prog layout. SWD1: 1x4 1.27 mm in
    clone ST-Link order (SW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
    [ESP.kicad_sch, PERIPHERALS.kicad_sch, REGULATORS.kicad_sch, SENSORS.kicad_sch, main2.kicad_sch]
2026-11-01 🐛 Put the inner copper layers in the gerbers and the review SVGs
    The fab zip held only F/B copper, so a 4-layer board would be built without
    its In1 ground and In2 planes. The layer list now comes from the board's layer
    table, and a test checks it against the table and the stackup.
2026-11-01 🚧 Lay out main2's ESP32-C5 corner and the rear-left power cluster
    - Remove the USB and ESP32-S3 copper. U13 sits in the rear-right corner
    with a ground via fence along the antenna notch, 12 tented thermal vias and
    a keep-out that matches its antenna.
    - J1, F1, D15, Q6 and the L6981 buck move to the rear-left beside SW4. C54
    and C55 sit 1.6 mm from their pins. J2 sits in the tab between the
    notches, 17 mm from the antenna. SWD1 has 4 pads in ST-Link order.
    - U13's 3V3 runs as a 0.8-1.0 mm B.Cu strap to C108/C109, with two vias at
    each change. 3V3_A runs 0.3 mm wide and clears the switch node.
    - Tests: U13 and IC7 decoupling, the antenna keep-out from the library
    footprint, and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
    [main2.kicad_pcb]
2026-11-01 🚧 Move main2's C5 link to SPI3 on the STM32's rear-right face
    SPI2's clock exists only on the STM32's left-side pins, so the link had to
    cross every line leaving the rear-right face to reach the C5.
    - The link moves to SPI3, a 3-wire master on MOSI with no IOSWP: SCK on
    PC10, DATA on PC12, CSn on PC11. The UART4 fallback stays on
    PC10/PC11 (AF8).
    - The sensor bus moves to SPI2 on PB13/PB14/PB15.
    - Fan_PWM moves to TIM14_CH1 on PA7, with the same 275 MHz clock and
    ARR. Button moves to PA11 and Fan_TOFF to PA12.
    - CubeMX 6.18.1 accepts both the SPI and the UART4 configurations.
    - Routed: all four link joins and the SPI_SCK join to EC2. DRC shows 0
    errors and 13 unconnected. Button,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
    [main2.kicad_pcb, main2.kicad_sch]
2026-11-02 🚧 Re-map main2's STM32 rear pins and re-route behind the fan hole
    Moves 18 signals to new pins (LEDs kept in place), plus two GPIO-only
    swaps (encoder CSn, motor PH), each checked against DS13311 Table 9 and
    CubeMX. Re-routes the corridors round the fan hole and the hub behind
    it, moves C6, C21, R27/C30 and R79/C105, and lands the 3V3_D feed on
    pin 68 (154.2 mOhm). DRC 0 errors, 10 unconnected.
    [main2.kicad_pcb, main2.kicad_sch]
2026-11-02 🚧 Close eight more of main2's open joins and fix its layout test failures
    Three more GPIO-only swaps (PB6/PB7/PB8, PA9/PA12) put the right
    bridge and encoder lanes in peel order. Re-lays the EC1 hub, routes
    SPI_MISO, SWDIO, ESP_Flow, Motor_Left_EN and Button, pulls the FAN_LSS
    pour 0.5 mm off CURRENT_L_AMP, shortens Wall_Emitter_Set and restores
    Q6's drain vias. DRC 0 errors, 2 unconnected (LED_ARGB,
    Encoder_Left_ABI_A).
    [main2.kicad_pcb, main2.kicad_sch]
2026-11-02 ✨ Finish main2's routing with every connection joined
    Routes LED_ARGB through a square In2 hop between Button and ELABI_B,
    and Encoder_Left_ABI_A up the front corner and behind ELABI_B, after
    re-laying Switch_0's 103 mm loop at 38 mm. DRC 0 errors, 0 unconnected;
    every make check gate passes.
    [main2.kicad_pcb]
2026-11-02 🐛 Fix main2's final-review findings: battery entry, countersinks, bulk caps
    Moves the 5V_IN hop out of the unfused BAT_P pour (neck 0.54 -> 3.0 mm)
    and 3V3_A 0.6 mm off J1/SW4's battery pins. Clears copper round H1-H4
    for the hand-cut Ø4.4 countersinks, drawn on User.1 only, and re-lays
    the bus at H2 (3V3_D feed 149.2 mOhm). Puts C84 on the VBAT pour,
    re-routes Fan_PWM off Wall_Sensor_0, adds the antenna fence vias and
    the firmware I/O speed and encoder filter notes. Adds tests for the
    battery pours' width, the battery pins' clearance, the countersinks and
    analog spacing from noisy supplies.
    [main2.kicad_pcb]
2026-11-02 🔥 Drop Dependabot and adopt its last bumps (ruff 0.17.2, setup-uv 10.3.2)
2026-11-02 🐛 Fix main2's remaining review findings: fan driver heat, Kelvin pairs, silk
    Gives IC6 its third thermal-via lane (6 -> 9) with FAN_LSS moved off
    the exposed pad, and spaces the fan's FAN_OUT vias out of C35's In1
    return. Pairs both INA241s' Kelvin lines (loops 25.6/25.9 -> 10.6/8.8
    mm^2, R75 turned) and re-lays Reset out of the right loop. Adds U8's
    exposed-pad vias (footprint via sites, split paste), nudges L3 0.45 mm
    from the antenna, and brings the repo footprints' silk to 0.15 mm and
    the board's texts to 0.8 mm. Adds tests for the exposed-pad vias and
    the Kelvin loop area.
    [main2.kicad_pcb]
2026-11-02 ⬆️ Bump KiCad to 10.0.8, the release the PPA now installs
2026-11-02 🚚 Make the new revision boards/main, replacing the v1 board
    The second revision, entered as boards/main2, becomes boards/main: main.zen, its sheets, test
    benches, schematic placement, layout (place.py, route.py, the routed main.kicad_pcb), spec and
    tests take the main name. The v1 board's files go; it stays in history (e34fb9a, and main until
    this merges), and the docs cite it there as "the v1 main board" where a value or a block comes
    from it.
    - Firmware: firmware.toml (MicrasFirmware's v1 pin map) stays the baseline, and one
    firmware_changes.toml holds the board's changes. The v1 board's C1, M11 and m17 are dropped:
    every key they set is set again by the new board's changes, so the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
    [DRIVERS.kicad_sch, ESP.kicad_sch, PERIPHERALS.kicad_sch, REGULATORS.kicad_sch, SENSORS.kicad_sch, main.kicad_pcb, main.kicad_sch, main2.kicad_pcb]
2026-11-02 🐛 Write the layout's zones in a canonical order, so make gen is byte-stable
    KiCad 10 saves a teardrop zone without its UUID and gives it a new one on every load, so each
    `pcb apply` wrote the main board's 1605 teardrop zones in another order, and CI's "generated
    files are up to date" step could never pass. micras-pcb mech now writes the zones with a UUID as
    KiCad ordered them, then the teardrops by their text (mech.zone_order); a board without teardrops
    is unchanged. The regenerated layout differs from the routed one only in that order and in
    PCB_NAME (pcbnew: same footprints, tracks, vias, zones and pad nets).
    [main.kicad_pcb]
2026-11-02 🔧 Write each project's own file name into its .kicad_pro
    micras-pcb rules sets meta.filename to <board>.kicad_pro: the renamed main project still named
    main2.kicad_pro there, which KiCad only rewrites when it saves the project.
2026-11-02 🔥 Retire the Bluetooth module and the parts no board uses
    The new main board has its radio on board (the ESP32-C5) and no USB port, so the HM-19
    module that plugged into the v1 board's USB-C has nothing to mate with. The v1 main board and
    the module stay at the tag v1 (e34fb9a).
    - boards/bluetooth, spec/bluetooth.toml and their tests, mech features and export, previous
    source and silkscreen rule go.
    - 29 component packages no board loads go (the v1 board's and the module's), with the 56
    parts/jlc.toml entries no board uses.
    - Comments that cited the untracked routing review now cite only the primary sources.
    [bluetooth.kicad_pcb, bluetooth.kicad_sch]
2026-11-03 💄 Cut the main board's JLCPCB Economic cost, clear its stock blockers, place its labels
    For an Economic PCBA order of 5 boards with 2 assembled (jlcpick quote: US$186.57 → 149.35),
    with every part JLCPCB places in stock:
    - U10/U11 INA241A2QDGKRQ1, the AEC-Q100 grade of the INA241A2IDGKR (2 in JLC stock): same DGK
    package, pinout and specifications (TI SBOSA31D).
    - L4/L5 MetalLions MTQH707050S470MGT (new package) on the XAL7070 land, L6 Coilcraft
    XAL5030-472MEC on its own land: the XAL7070/XGL5030 had none in stock. The choke checks pass
    with the new datasheets (ripple, reversal overshoot under the 6 A OCP, heat).
    - C102/C105/C113/C114 basic 1 nF X7R instead of extended C0G, check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
    [DRIVERS.kicad_sch, REGULATORS.kicad_sch, SENSORS.kicad_sch, main.kicad_pcb]
2026-11-03 💄 Have JLCPCB place the buzzer, DIP switch and RGB LEDs
    - BZ1 FUET-5025 (682 in JLC stock): the FUET-5030 in a 2.5 mm body, same land and ratings
    (Fusheng FST-5025); the package is renamed, with the FUET-5025's own STEP.
    - D1/D2 WS2812C-2427-V6 (new package, 2.7 x 2.4 mm, JLC Economic): same supply range, input
    thresholds (VIL now 0.3 x VDD) and bit timing as the WS2812C-2020-V6, whose JLC stock (4) and
    /W reel (Standard PCBA only) ruled it out. The LEDs keep their positions, turned to 0 degrees so
    each pin faces the side its 2020 pin did; the tracks re-joined, the 3V3_D via moved off D1's
    VDD pad, the pads' zone connections and teardrops restored.
    - SW1 DSHP04TJGER back on the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
    [PERIPHERALS.kicad_sch, main.kicad_pcb]
2026-11-07 ✨ Shorten the main board to 91 mm, stand the wall sensors on paddle boards, and route it fully
    - Main board: 91.18 mm long and axle-centred, with a turning circle that includes the ESP32-C5
    antenna; a 20 mm nose with 4 mm shoulders; the IMU at the rotation centre; the H7 turned 45 deg
    and partly under the fan; diagonal sensors at the front; M1 and M2 side by side at the rear with J2;
    connector latches outward; SWD1 with NRST (1 NRST, 2 SWDIO, 3 GND, 4 SWCLK, 5 5V).
    - Wall sensors: a new wall board (paddle outline, JLC-assembled) standing in a 2x3 1.27 mm
    straddle-mount header (Hanxia HX-PZ1.27-2x3P-ZZ) on the WallJoint footprint; the selector parts
    move onto the wall boards; the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
    [ESP.kicad_sch, SENSORS.kicad_sch, main.kicad_pcb, main.kicad_sch, wall.kicad_pcb, wall.kicad_sch]
2026-11-07 🔧 Pin KiKit 1.8.1 for the wall board's panel
2026-11-07 ✨ Apply review 3: wall ADC pins away from the fan PWM, LDO soft start, HASL, panel and paste rules
    - Pins: Current_Sensor_Left PA6, Wall_Sensor_2 PB1, Wall_Sensor_1 PA3, Button PC4; Fan_PWM and
    the buzzer 0.45 mm or more from every wall-sensor line; buzzer classed fast digital.
    - C115 1 nF on U8 SS so VDDA never overtakes VDD at power-up.
    - No vias or tracks under the LSM6DSV; 3 vias on each DRV8874 VM pin; reliefs on hand-soldered
    ground pins; one spoke on tombstone-prone pads; countersink keep-outs cone + 0.4 mm.
    - Parts: INA241A2IDGKR, hongjiacheng SMAJ18A, XGL5030-472MEC; green mask on main.
    - Leaded HASL on every board; the wall board ships as a 4-up mouse-bite panel.
    - JLCPCB pas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
    [DRIVERS.kicad_sch, REGULATORS.kicad_sch, SENSORS.kicad_sch, encoder.kicad_pcb, main.kicad_pcb, main.kicad_sch, wall.kicad_pcb]
2026-11-07 ✨ Grow the main board's vias to JLCPCB's free 0.45 mm, turn EC2 to 180°, build the assembly view
    - Every via on main has 0.45 mm copper (0.2 or 0.3 mm hole), so the order takes JLCPCB's
    standard via option; test_vias_take_jlcpcbs_standard_option holds it.
    - EC2 stands at 180° again (spec/main.toml [encoder_slots] rotations, checked by mech), so the
    left encoder board plugs in with its chip toward the wheel; its pads re-routed, C71/C72 moved.
    - micras-pcb assembly (make review): main with the four wall boards and both encoder boards in
    place, as GLB, STEP and renders, with placement, pad-mating and clash checks.
    - Green solder mask on the wall and encoder boards.
    [encoder.kicad_pcb, main.kicad_pcb, wall.kicad_pcb]
2026-11-07 📝 Record the STM32CubeMX run on the final pin map
2026-11-07 💄 Show every designator on the main board and outline only the drive blocks' footprint
    Every reference designator is on the silkscreen, the wall joints' W1-W4 included (the mounting
    holes' stay on F.Fab): 0.4 mm high with a 0.1 mm stroke, the owner's choice, a little smaller than
    the v1 board's 0.5 mm, placed by silk.py within 1.2 mm of each part's courtyard (163 of 163).
    Each drive block's silk outline is where it stands on the board, as on the v1 board: its plate and
    its two screw bosses' pads (spec [silkscreen], lines and arcs), no longer the union of every zone
    the block overhangs.
    [main.kicad_pcb]
2026-11-08 🐛 Apply the team review's direct fixes: the radio's feed, the via rule, SW4's legend and the docs
    - 3V3_D to the ESP32-C5 widened where the copper leaves room (0.18 mm along the wheel notch to
    0.5 mm, the B.Cu and edge runs to 0.6-0.8 mm): 145 -> 86 mOhm from L3, 37 mV at the 426 mA
    transmit peak; test_radio_feed_resistance holds it under 0.1 Ohm. The docs described a 0.8/1.0 mm
    feed that was never routed.
    - rules/jlcpcb.kicad_dru: the preferred via hole is the PDK's 0.20 mm (it read 0.30, 199 warnings on
    the free 0.45/0.2 vias), and a warning holds every via at JLCPCB's free 0.45 mm class;
    test_no_via_drill_or_diameter_warnings.
    - SW4's ON legend moved off C114's pads to past t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
    [main.kicad_pcb]
2026-11-08 🐛 Keep the inner planes 0.5 mm and the slots' tracks 0.3 mm off the milled edges, and name the blue LED's line LED_Blue
    - JLCPCB mills edges to +-0.2 mm (regular): the inner planes keep 0.5 mm from every routed edge (a
    DRU rule on In1/In2 pours; test_inner_planes_keep_off_the_routed_edges keeps the rule), and the
    nine tracks and vias that passed 0.20-0.28 mm from the encoder slots move to 0.3 mm or more, each
    at 45 deg (test_tracks_and_vias_keep_off_the_encoder_slots).
    - PB2 lights the blue D4: its net LED_Red becomes LED_Blue, with the rename in
    firmware_changes.toml (leds, pinmap) for MicrasFirmware.
    - Layout README: J2 sits inboard of the antenna notch, SWD1 in the rear tab; C1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
    [PERIPHERALS.kicad_sch, main.kicad_pcb, main.kicad_sch]
2026-11-08 ✨ Swap the fan choke L6 to the MPS MPL-AL5030-4R7, which JLCPCB stocks
    The XGL5030-472MEC has no stock anywhere JLCPCB can place it from. The MPL-AL5030-4R7 (C3222781)
    lands on the same pads: 4.7 uH +-20 %, 36.5 mOhm max, IR 5.3 A, Isat 8 A at 30 %; its curve reaches
    -20 % at 4.55 A, so the fan's limiter band (top 4.31 A) keeps 0.19 A to it and a 2S motor runs at up
    to 2.44 A. MPS publishes no core loss: estimated 0.27 W at the worst ripple, bounded at 1.04 W,
    L6 at 86 C (estimate) / 121 C (bound) with the limiter held, under the board's 125 C and the
    part's 155 C (research calculations/fan/fan_choke_check.py). New package with a CadQuery STEP; the
    unused XGL package goes.
    [DRIVERS.kicad_sch, main.kicad_pcb]
2026-11-08 🐛 Put C105 at PA6 and let the STM32's In2 islands give way to the lines over them
    C105, the left current's ADC filter capacitor, moves from beside R79 (23 mm of track from PA6) to
    the front-left face, 1.9 mm from IC1.25 with 2 mm of track, as ST AN2834 4.2.8 asks; the four
    lines its new spot crossed are re-routed. The 3V3_D island spans its 0.8 mm gap to VCORE under the
    left encoder's A/B lines and at the front vertex, and VCORE's band is cut back where lines ran
    along it: B.Cu lines change In2 net 34 times instead of 44, over the fill clearance's gap only.
    test_adc_filter_caps_at_the_pin is no longer an expected failure, and
    test_analog_and_encoder_lines_keep_to_their_in2_plane holds the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
    [main.kicad_pcb]
2026-11-08 ✨ Add bare USB pads J3 on the ESP32-C5's USB Serial/JTAG pins
    J3 (components/micras/UsbPads: GND, D-, D+, 1.0 mm SMD at 1.27 mm) sits off
    U13's front-left corner. The pair runs on F.Cu with no via, 0.2248/0.127 mm,
    D- 10.40 mm and D+ 10.35 mm, along the outer side of the module's edge row
    into pins 23/24. ESP_EN crosses under it on an In2 hop. ESP_CSn_IO,
    ESP_SCK_IO, ESP_SWCLK and 3V3_D are re-laid off the row. No series
    resistors: there is no room at the pins.
    [ESP.kicad_sch, main.kicad_pcb]
2026-11-08 ♻️ Make the USB pads J3 plated holes, soldered from the bottom
    J3 takes J2's hole geometry (1.05 mm pads, 0.65 mm drills, pad 1 square) and
    keeps its place and order (GND, D-, D+), labelled on both silkscreens. J3.1
    joins the pours as the other hand-soldered ground pins do, and its separate
    ground via goes. ESP_TXD0's B.Cu peak, 0.59 mm from J3.3, is lowered:
    13.24 -> 11.93 mm. D+'s riser moves 0.05 mm, 0.36 mm off D-'s hole.
    [ESP.kicad_sch, main.kicad_pcb]
2026-11-08 💄 Let the designators turn 45° and sit along their part's side
    silk.py now tries 0, 90, 45 and 135 degrees, each searched in a frame turned with the label so a
    diagonal label is checked against its own outline, and ranks spots by the label's centre to the
    part's centre, which puts it along the part's side; a label parallel to its part's sides is
    preferred. test_every_designator_is_shown_by_its_part fails a hidden or stray designator.
    [main.kicad_pcb]
2026-11-08 💄 Name each part by its nearest label, the user's parts by their use
    silk.py now holds both ways that a label names its nearest part of its kind (the same kind of
    reference, or the same footprint) and that a part's nearest such label is its own, measured to the
    part's body; it sizes labels by their drawn strokes and treats each closed F.Fab shape as its own
    body. The big ICs carry no designator, the buttons, battery, motor and fan connectors and the
    programming pads carry what they are for (RST, BTN, BAT, MOT R on M1, MOT L on M2, FAN, ESP, SWD,
    USB), and SW4, the DIP switch, the LEDs and the buzzer keep only their own marks.
    test_labels_name_their_nearest_similar_part holds both rules.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
    [main.kicad_pcb]
2026-11-08 🏷️ Name the motor lines after the wheel they drive: M1 takes the right motor
    The motors' leads cross as they are mounted, so M1, on the board's left, drives the right wheel's
    motor and M2 the left's. No connection changes: the nets of IC9, M1, U11, R79 and C105 (PC6, PA9,
    PA6) become the right motor's and those of IC8, M2, U10, R78 and C102 (PA10, PB7, PC1) the left's,
    and firmware_changes.toml carries the firmware's new pin labels.
    [DRIVERS.kicad_sch, SENSORS.kicad_sch, main.kicad_pcb, main.kicad_sch]
2026-11-08 💄 Keep every label clear of the part bodies, not 0.5 mm² under them
    [main.kicad_pcb]
2026-11-08 🐛 Redraw the motor nets' teardrops and pair the Kelvin test with the renamed sides
    The motor rename left the teardrop zones on their old net names, which layout-check and DFM read
    as shorts, and the Kelvin test still paired the right side with IC8's shunt R65: R65/U10 are now
    the left motor's, R75/U11 the right's.
    [main.kicad_pcb]
2026-11-08 💄 Keep the user labels off vias, where a via would break their letters
    [main.kicad_pcb]
2026-11-08 📝 Apply the team's re-review: the no-pack threshold, the reversed pack's numbers, LED_Blue's timing
    battery_absent drops to 5.0 V: 3.0 V/cell at the review's worst-case 10.4 A through a 0.6 Ohm pack
    reads 5.8 V, under the old 6.0 V, and the no-pack float stays at or below 3.9 V. The reversed-pack
    text gives GND_BAT's 4.0 V beside GND's 3.2 V, F1's 9-62 s at about 30 A and J1's contact heating.
    LED_Blue changes only between wall-sensor scans, as its line runs 0.20-0.23 mm beside
    Wall_Sensor_2 and Wall_Emitter_Set round C105, and the ADC filter test says why C102 cannot reach
    AN2834's 3 mm.
    [test_main_layout.py]
2026-11-09 🐛 Turn the CPL as JLCPCB's preview places the parts
    The DRV8874, INA241 and ADP7142 take 270 and the TLV9001 180: their LCSC footprints line up with ours pin for pin only turned so, and JLCPCB's placement preview shows pin 1 on our pad 1 for each. JLCPCB mirrors bottom parts, so the wall board's Q1 and D1 sat 180 off; bottom parts now take 180 minus KiCad's rotation and the offset (jlc.jlc_rotation), checked in the preview.
2026-11-09 ✅ Mark the parts JLCPCB's placement preview showed on their pads as verified
    Main board and wall panel, 2026-11-08: every polarised or pin-1 part (IC8, IC9, U8, U10, U11, U12, Q1, Q6, Q9, D3, D5, D14, D15, D17, BZ1, SW1 and the wall's Q1, D1) with pin 1 or its cathode on our pad, and every two-terminal part on its pads. The WS2812C-2427 is Standard PCBA only and was not placed; hand-assembled parts stay unverified.
2026-11-09 ✨ Add the CHONGTIAN CT-1515UGRBC addressable RGB LED
    1.5 x 1.5 mm, VDD 3-7.5 V in its recommended operating range, WS2812-style 24-bit GRB data, 5 mA a channel. The datasheet's recommended land pattern, the LCSC model scaled to the datasheet's 0.9 mm height, and a test bench for the pinout, supply range and 3.3 V data level.
2026-11-09 💄 Swap the status LEDs to the CT-1515 and dim the blue LED to the red's
    JLCPCB places only Standard PCBA for the WS2812C-2427 and every other addressable LED rated from 3.3 V; the CT-1515 is placed with Economic PCBA and runs from 3 V. Its corners hold the WS2812C's signals, so D1/D2 stay put and their copper reaches the new pads by short stubs (D1's data via moves out from under the body). The firmware's T0H/T1H go to 295/596 ns, centred in the CT-1515's +-50 ns windows. R4 goes from 100 to 680 Ohm, R5's value: the blue D4 now runs about 1 mA, the red D5's brightness.
    [PERIPHERALS.kicad_sch, main.kicad_pcb]
2026-11-10 💄 Dim the status LEDs: 1 kOhm for both the red and the blue
    The owner wants the red D5 a little dimmer (R5 680 -> 1 kOhm: 0.9-1.5 mA, 14-23 mcd) and the blue D4 at the same brightness (R4 1 kOhm: about 0.65 mA for a mid-bin die, 9-23 mcd). The 680 Ohm part leaves the board.
    [PERIPHERALS.kicad_sch, main.kicad_pcb]
